enggsajjad/scooter/logs/20210728 Testing A9G GPS/20210728 Testing AT 5.jpeg

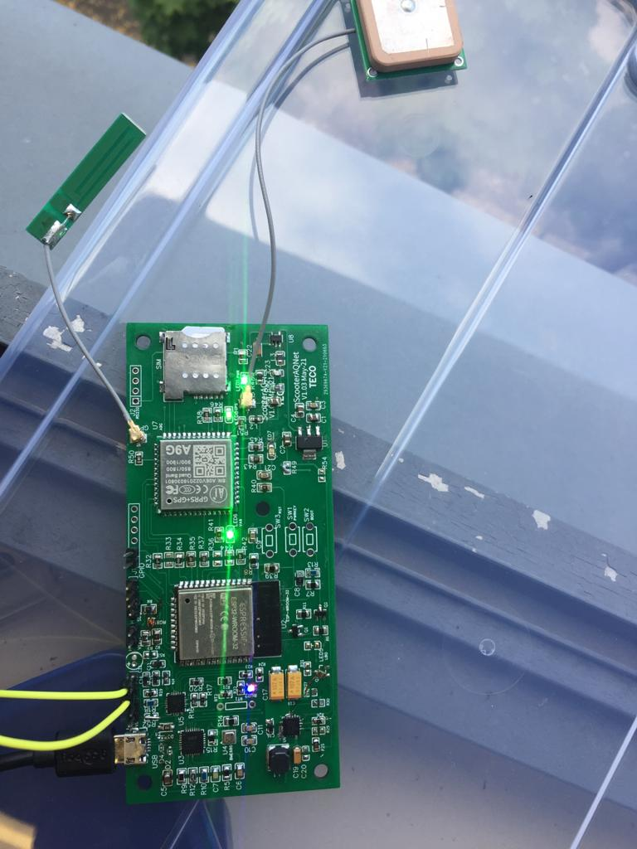
logs/20210728 Testing A9G GPS/20210728 Testing AT 5.jpeg
