enggsajjad/scooter/esp32scooter/docs/latex/esp32scooter_8ino.tex

\hypertarget{esp32scooter_8ino}{}\section{H\+:/github/scooter/esp32scooter/esp32scooter.ino File Reference}
\label{esp32scooter_8ino}\index{H:/github/scooter/esp32scooter/esp32scooter.ino@{H:/github/scooter/esp32scooter/esp32scooter.ino}}

This is the Arduino .ino file.  

{\ttfamily \#include \char`\"{}main.\+h\char`\"{}}\newline
\subsection*{Functions}
\begin{DoxyCompactItemize}
\item 
void \mbox{\hyperlink{esp32scooter_8ino_a4fc01d736fe50cf5b977f755b675f11d}{setup}} ()
\begin{DoxyCompactList}\small\item\em initialization of peripherals attached to E\+S\+P32 board \end{DoxyCompactList}\item 
void \mbox{\hyperlink{esp32scooter_8ino_afe461d27b9c48d5921c00d521181f12f}{loop}} ()
\begin{DoxyCompactList}\small\item\em reading the Microphone with timer function \end{DoxyCompactList}\end{DoxyCompactItemize}

\subsection{Detailed Description}
This is the Arduino .ino file. 

This is the E\+S\+P32 implementation file, which implement the overall flow of the project by calling different files/functions. It implements the state-\/machine like flow as described in the \href{StatemachineFlow.pdf}{\texttt{ {\bfseries{flowchart}}}}.

\begin{DoxyDate}{Date}
07.\+09.\+2020 
\end{DoxyDate}

\subsection{Function Documentation}
\mbox{\Hypertarget{esp32scooter_8ino_afe461d27b9c48d5921c00d521181f12f}\label{esp32scooter_8ino_afe461d27b9c48d5921c00d521181f12f}} 
\index{esp32scooter.ino@{esp32scooter.ino}!loop@{loop}}
\index{loop@{loop}!esp32scooter.ino@{esp32scooter.ino}}
\subsubsection{\texorpdfstring{loop()}{loop()}}
{\footnotesize\ttfamily void loop (\begin{DoxyParamCaption}{ }\end{DoxyParamCaption})}

reading the Microphone with timer function 

\begin{DoxyReturn}{Returns}
void 
\end{DoxyReturn}

Definition at line 59 of file esp32scooter.\+ino.

\mbox{\Hypertarget{esp32scooter_8ino_a4fc01d736fe50cf5b977f755b675f11d}\label{esp32scooter_8ino_a4fc01d736fe50cf5b977f755b675f11d}} 
\index{esp32scooter.ino@{esp32scooter.ino}!setup@{setup}}
\index{setup@{setup}!esp32scooter.ino@{esp32scooter.ino}}
\subsubsection{\texorpdfstring{setup()}{setup()}}
{\footnotesize\ttfamily void setup (\begin{DoxyParamCaption}{ }\end{DoxyParamCaption})}

initialization of peripherals attached to E\+S\+P32 board 

\begin{DoxyReturn}{Returns}
void 
\end{DoxyReturn}

Definition at line 23 of file esp32scooter.\+ino.
