enggsajjad/scooter/esp32scooter/docs/images/header.tex

% Latex header for doxygen 1.8.15
\let\mypdfximage\pdfximage\def\pdfximage{\immediate\mypdfximage}\documentclass[twoside]{book}

% Packages required by doxygen
\usepackage{fixltx2e}
\usepackage{calc}
\usepackage{doxygen}
\usepackage{graphicx}
\usepackage[utf8]{inputenc}
\usepackage{makeidx}
\usepackage{multicol}
\usepackage{multirow}
\PassOptionsToPackage{warn}{textcomp}
\usepackage{textcomp}
\usepackage[nointegrals]{wasysym}
\usepackage[table]{xcolor}
\usepackage{ifpdf,ifxetex}

% Font selection
\usepackage[T1]{fontenc}
\usepackage[scaled=.90]{helvet}
\usepackage{courier}
\usepackage{amssymb}
\usepackage{sectsty}
\renewcommand{\familydefault}{\sfdefault}
\allsectionsfont{%
  \fontseries{bc}\selectfont%
  \color{darkgray}%
}
\renewcommand{\DoxyLabelFont}{%
  \fontseries{bc}\selectfont%
  \color{darkgray}%
}
\newcommand{\+}{\discretionary{\mbox{\scriptsize$\hookleftarrow$}}{}{}}

% Arguments of doxygenemoji:
% 1) ':<text>:' form of the emoji, already "LaTeX"-escaped
% 2) file with the name of the emoji without the .png extension
% in case image exist use this otherwise use the ':<text>:' form
\newcommand{\doxygenemoji}[2]{%
  \IfFileExists{./#2.png}{\raisebox{-0.1em}{}}{#1}%
}
% Page & text layout
\usepackage{geometry}
\geometry{%
  a4paper,%
  top=2.5cm,%
  bottom=2.5cm,%
  left=2.5cm,%
  right=2.5cm%
}
\tolerance=750
\hfuzz=15pt
\hbadness=750
\setlength{\emergencystretch}{15pt}
\setlength{\parindent}{0cm}
\newcommand{\doxynormalparskip}{\setlength{\parskip}{3ex plus 2ex minus 2ex}}
\newcommand{\doxytocparskip}{\setlength{\parskip}{1ex plus 0ex minus 0ex}}
\doxynormalparskip
\makeatletter
\renewcommand{\paragraph}{%
  \@startsection{paragraph}{4}{0ex}{-1.0ex}{1.0ex}{%
    \normalfont\normalsize\bfseries\SS@parafont%
  }%
}
\renewcommand{\subparagraph}{%
  \@startsection{subparagraph}{5}{0ex}{-1.0ex}{1.0ex}{%
    \normalfont\normalsize\bfseries\SS@subparafont%
  }%
}
\makeatother

% Headers & footers
\usepackage{fancyhdr}
\pagestyle{fancyplain}
\fancyhead[LE]{\fancyplain{}{\bfseries\thepage}}
\fancyhead[CE]{\fancyplain{}{}}
\fancyhead[RE]{\fancyplain{}{\bfseries\leftmark}}
\fancyhead[LO]{\fancyplain{}{\bfseries\rightmark}}
\fancyhead[CO]{\fancyplain{}{}}
\fancyhead[RO]{\fancyplain{}{\bfseries\thepage}}
\fancyfoot[LE]{\fancyplain{}{}}
\fancyfoot[CE]{\fancyplain{}{}}
\fancyfoot[RE]{\fancyplain{}{\bfseries\scriptsize Generated by Doxygen }}
\fancyfoot[LO]{\fancyplain{}{\bfseries\scriptsize Generated by Doxygen }}
\fancyfoot[CO]{\fancyplain{}{}}
\fancyfoot[RO]{\fancyplain{}{}}
\renewcommand{\footrulewidth}{0.4pt}
\renewcommand{\chaptermark}[1]{%
  \markboth{#1}{}%
}
\renewcommand{\sectionmark}[1]{%
  \markright{\thesection\ #1}%
}

% Indices & bibliography
\usepackage{natbib}
\usepackage[titles]{tocloft}
\setcounter{tocdepth}{3}
\setcounter{secnumdepth}{5}
\makeindex

\usepackage{newunicodechar}
  \newunicodechar{⁻}{${}^{-}$}% Superscript minus
  \newunicodechar{²}{${}^{2}$}% Superscript two
  \newunicodechar{³}{${}^{3}$}% Superscript three

% Hyperlinks (required, but should be loaded last)
\ifpdf
  \usepackage[pdftex,pagebackref=true]{hyperref}
\else
  \ifxetex
    \usepackage[pagebackref=true]{hyperref}
  \else
    \usepackage[ps2pdf,pagebackref=true]{hyperref}
  \fi
\fi

\hypersetup{%
  colorlinks=true,%
  linkcolor=blue,%
  citecolor=blue,%
  unicode%
}

% Custom commands
\newcommand{\clearemptydoublepage}{%
  \newpage{\pagestyle{empty}\cleardoublepage}%
}

\usepackage{caption}
\captionsetup{labelsep=space,justification=centering,font={bf},singlelinecheck=off,skip=4pt,position=top}

\usepackage{etoc}
\etocsettocstyle{\doxytocparskip}{\doxynormalparskip}
\renewcommand{\numberline}[1]{#1~}
%===== C O N T E N T S =====

\begin{document}

% Titlepage & ToC
\hypersetup{pageanchor=false,
             bookmarksnumbered=true,
             pdfencoding=unicode
            }
\pagenumbering{alph}
\begin{titlepage}
\vspace*{2cm}
\begin{center}%
{\Huge $projectname}\\
\vspace*{3cm}
{\Large $projectbrief}\\
\vspace*{1cm}
\centering
\vfill
 % also works with logo.pdf
\vspace*{2cm}
\vfill
{\large Generated by Doxygen}\\
\vspace*{1cm}
{\Large $date}\\
\end{center}
\end{titlepage}
\clearemptydoublepage
\pagenumbering{roman}
\tableofcontents
\clearemptydoublepage
\pagenumbering{arabic}
\hypersetup{pageanchor=true}

%--- Begin generated contents ---
