enggsajjad/scooter/esp32scooter/docs/Flowcharts/StatemachineFlow.pdf

# SMARTAQNET ESP32_STATIONARY STATEMACHINE

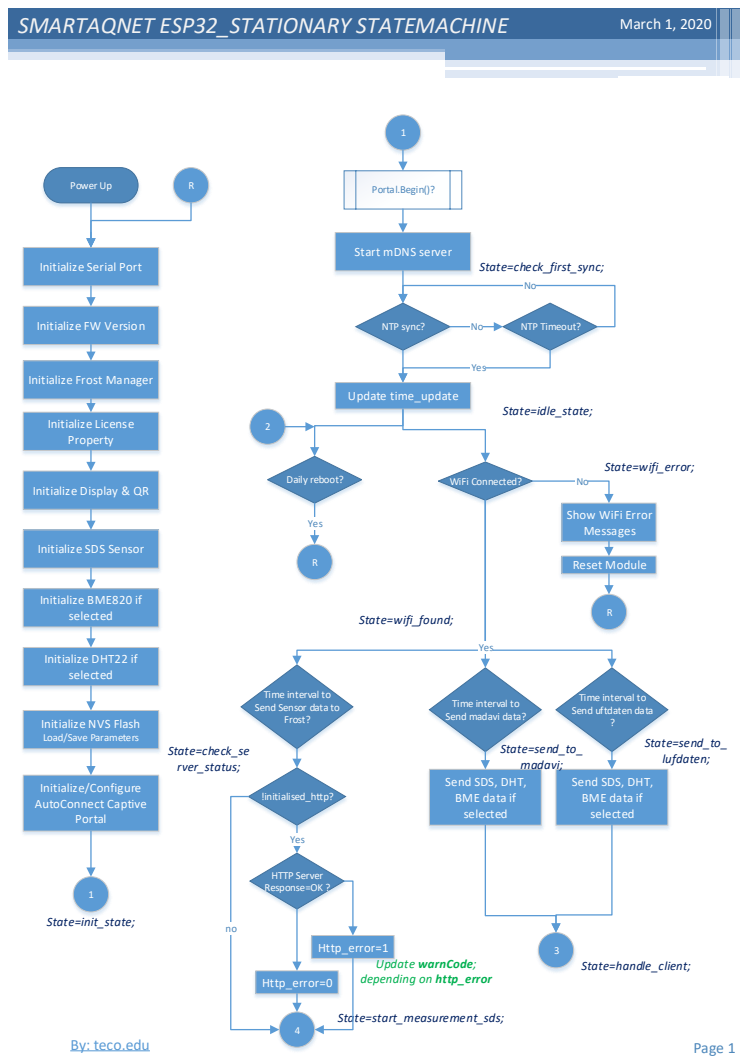
[picture p3: page 1]
March 1, 2020; Power Up; Initialize License Property; Initialize BME820 if selected; Initialize DHT22 if selected; Initialize/Configure AutoConnect Captive Portal; Portal.Begin()?; State=init_state;; NTP sync?; NTP Timeout?; Daily reboot?; WiFi Connected?; Reset Module; Update time_update; Yes; State=check_first_sync;; State=idle_state;; State=wifi_error;; State=wifi_found;; State=start_measurement_sds;; State=send_to_ madavi;; State=send_to_ lufdaten;; State=handle_client;; !initialised_http?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

Start mDNS server

Initialize Serial Port

Initialize FW Version

Initialize Frost Manager

Initialize Display & QR

Show WiFi Error
Messages

Initialize SDS Sensor

Time interval to
Send Sensor data to
Frost?

Send madavi data?

Send uftdaten data

Initialize NVS Flash
Load/Save Parameters

Send SDS, DHT,
BME data if
selected

By: teco.edu

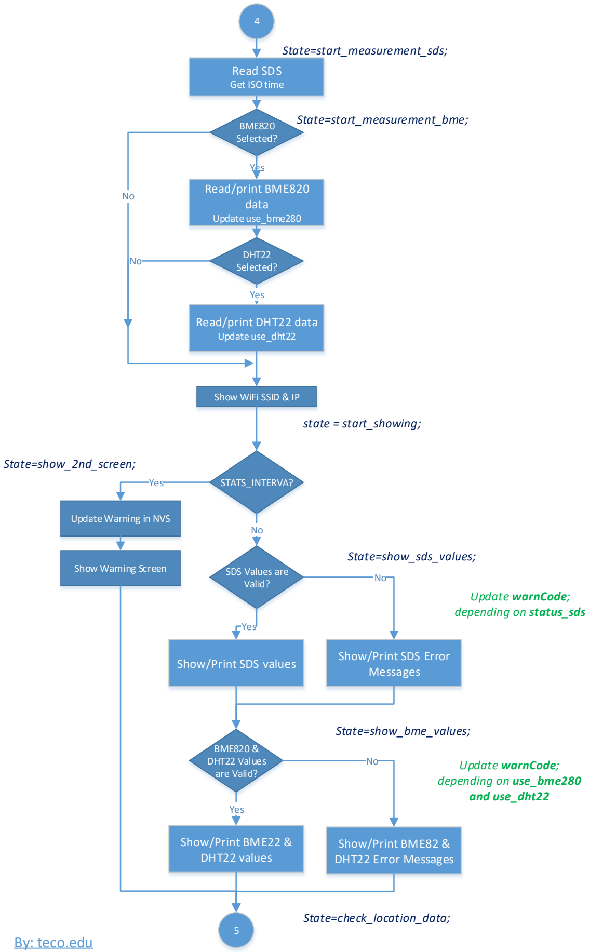
[picture p4: figure]
Read SDS Get ISO time; BME820 Selected?; Yes; State=start_measurement_sds;; State=start_measurement_bme;; Read/print BME820 data Update use_bme280; DHT22 Selected?; Read/print DHT22 data Update use_dht22; SDS Values are Valid?; Show/Print SDS values; Show/Print SDS Error; Messages; BME820 & DHT22 Values are Valid?; Show/Print BME22 & DHT22 values; Show/Print BME82 & DHT22 Error Messages; State=show_sds_values;; State=show_bme_values;; State=check_location_data;; Update warnCode; depending on status_sds; Update warnCode; depending on use_bme280 and use_dht22; Show WiFi SSID & IP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
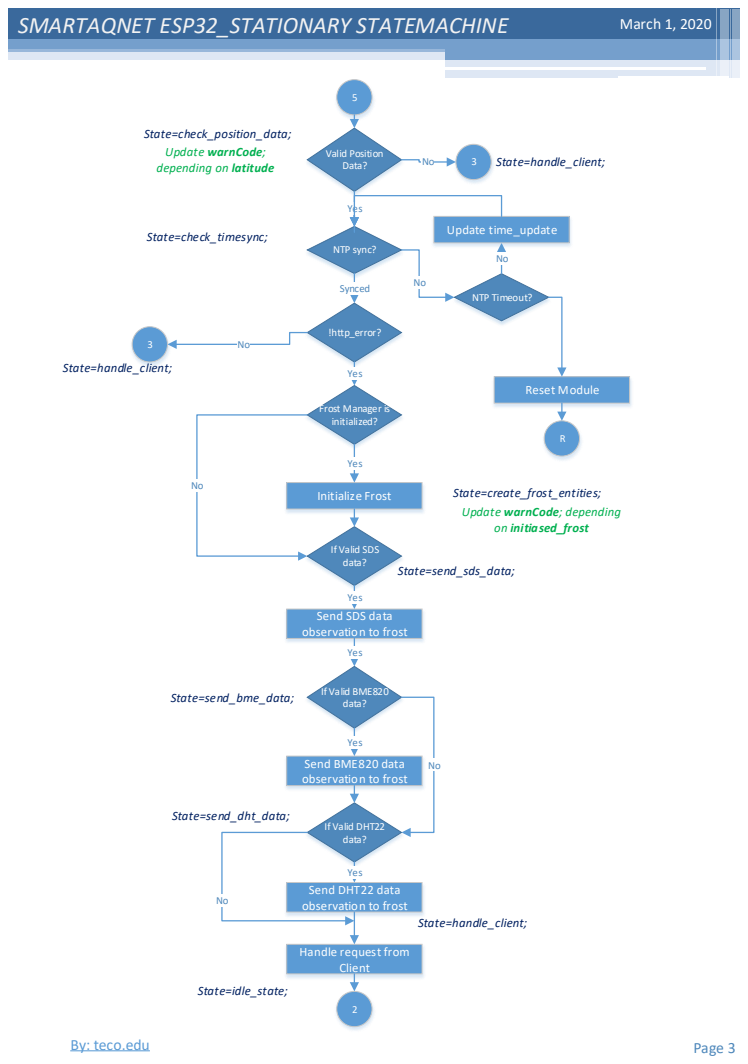
[picture p5: page 3]
Valid Position Data?; State=handle_client;; NTP sync?; NTP Timeout?; State=check_timesync;; Yes; Reset Module; Update time_update; Initialize Frost; State=create_frost_entities;; If Valid BME820 data?; If Valid DHT22 data?; State=send_sds_data;; State=send_bme_data;; State=send_dht_data;; Client; State=idle_state;; !http_error?; Synced

State=check_position_data;
Update warnCode;
depending on latitude

Frost Manager is
initialized?

Update warnCode; depending
on initiased_frost

If Valid SDS
data?

Yes
Send SDS data
observation to frost

Send BME820 data

Send DHT22 data

Handle request from

Handling the AutoConnect Portal and WebServer

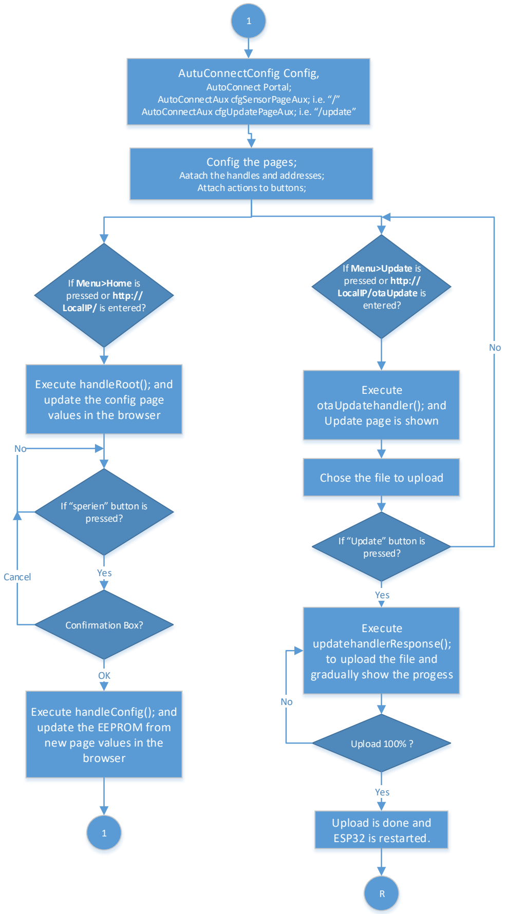
[picture p6: figure]
AutuConnectConfig Config, AutoConnect Portal; AutoConnectAux cfgSensorPageAux; i.e. “/” AutoConnectAux cfgUpdatePageAux; i.e. “/update”; If Menu>Home is pressed or http:// LocalIP/ is entered?; If Menu>Update is pressed or http:// LocalIP/otaUpdate is entered?; Config the pages; Aatach the handles and addresses; Attach actions to buttons;; Execute handleRoot(); and update the config page values in the browser; If “sperien” button is pressed?; Confirmation Box?; Execute handleConfig(); and update the EEPROM from new page values in the browser; Execute otaUpdatehandler()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

# Portal.Begin() Sub-Process

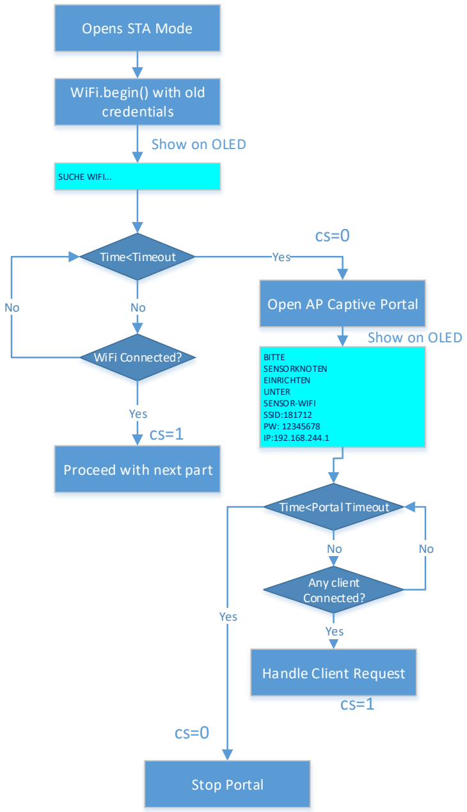
[picture p7: figure]
Opens STA Mode; Time<Timeout; WiFi.begin() with old credentials; WiFi Connected?; Proceed with next part; Yes; Time<Portal Timeout; Open AP Captive Portal; SUCHE WIFI...; BITTE SENSORKNOTEN EINRICHTEN UNTER SENSOR-WIFI SSID:181712 PW: 12345678 IP:192.168.244.1; Any client Connected?; Handle Client Request; Stop Portal; Show on OLED
