enggsajjad/scooter/esp32scooter/docs/images/tecoLogo.pdf

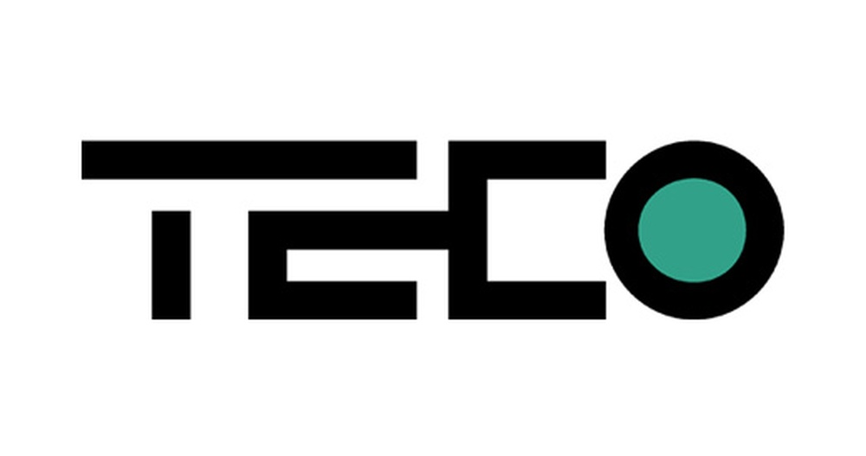
[picture p8: page 1]
