enggsajjad/scooter/esp32scooter/docs/latex/apmode.pdf

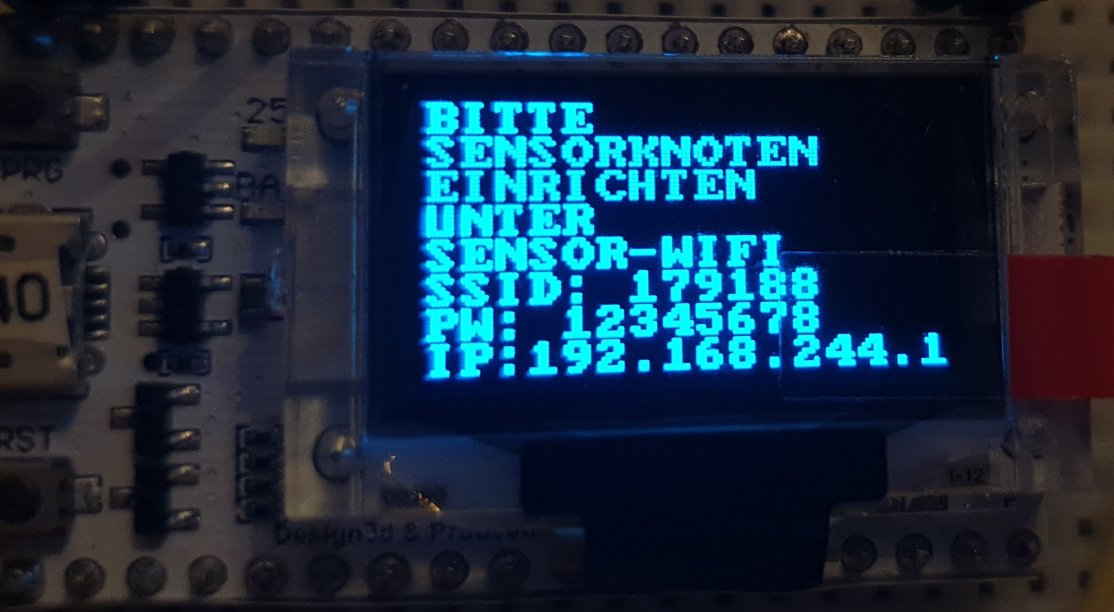
[picture p9: page 1]
