enggsajjad/scooter/esp32scooter/docs/latex/board.pdf

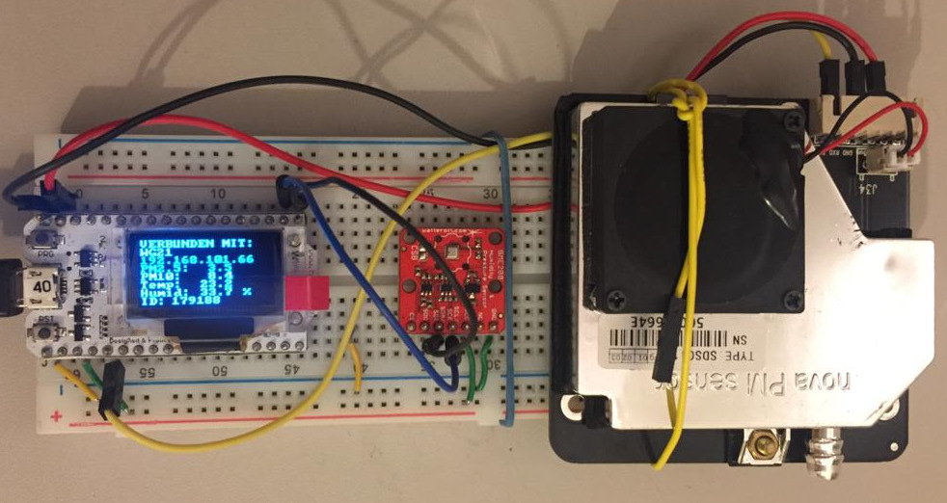
[picture p10: page 1]
