enggsajjad/scooter/esp32scooter/docs/latex/configr.pdf

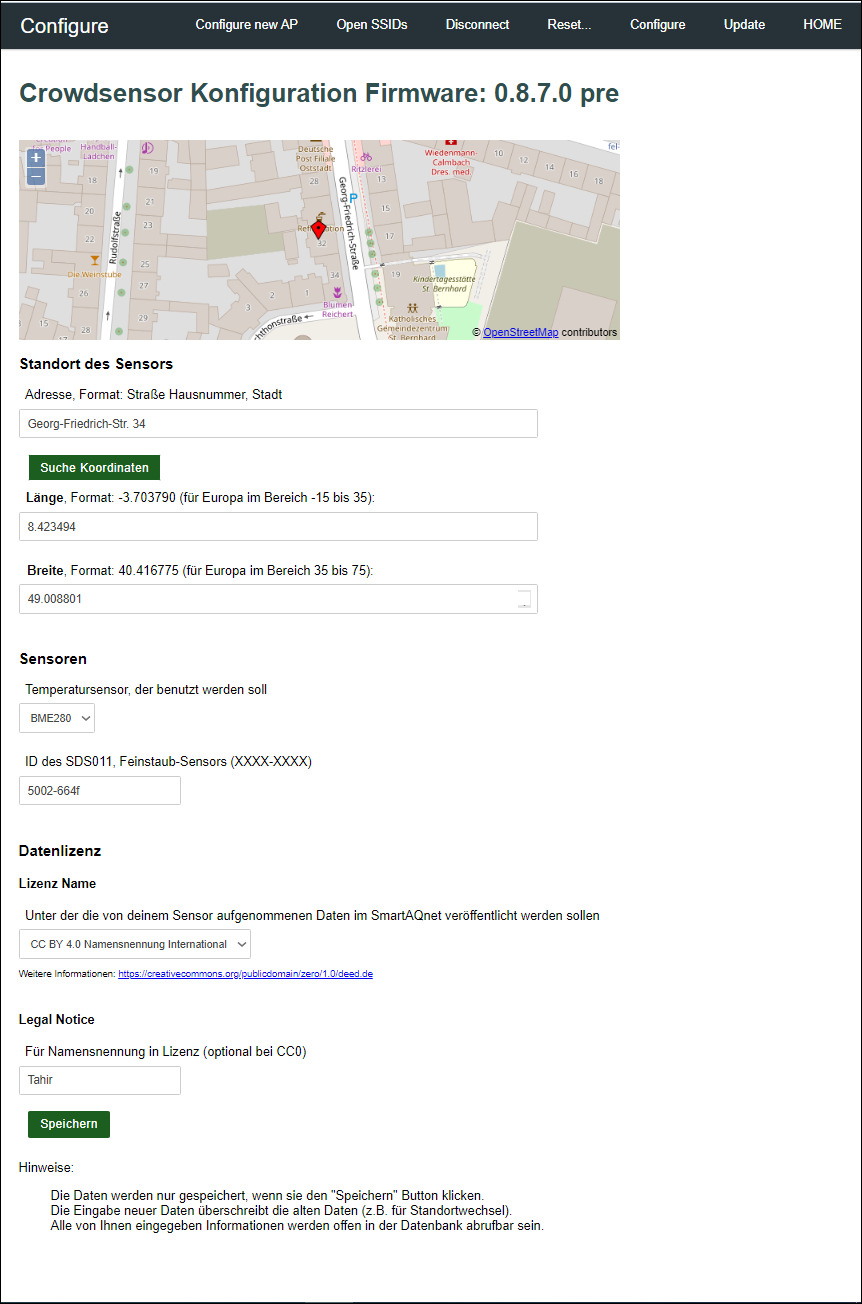
[picture p11: page 1]
