enggsajjad/scooter/esp32scooter/docs/latex/reboot.pdf

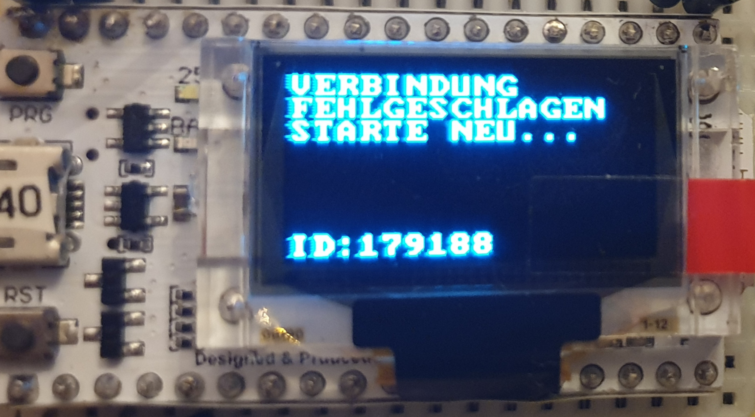
[picture p12: page 1]
