enggsajjad/scooter/esp32scooter/docs/latex/screen1.pdf

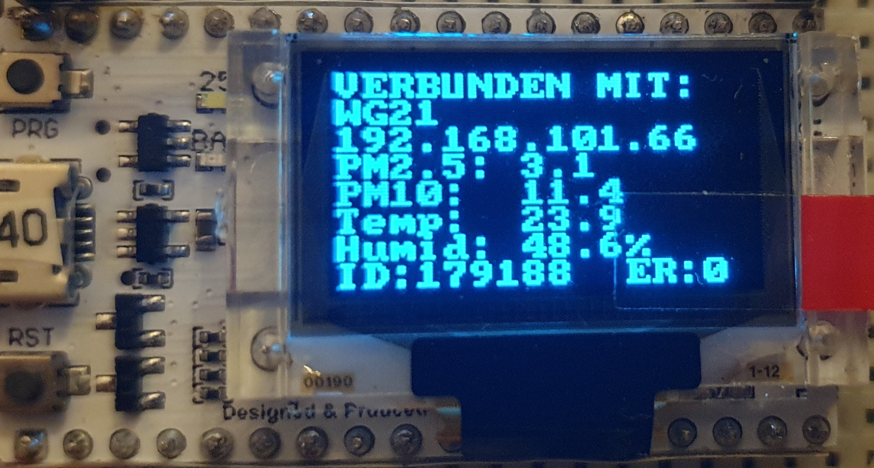
[picture p13: page 1]
