enggsajjad/scooter/esp32scooter/docs/latex/screen1error.pdf

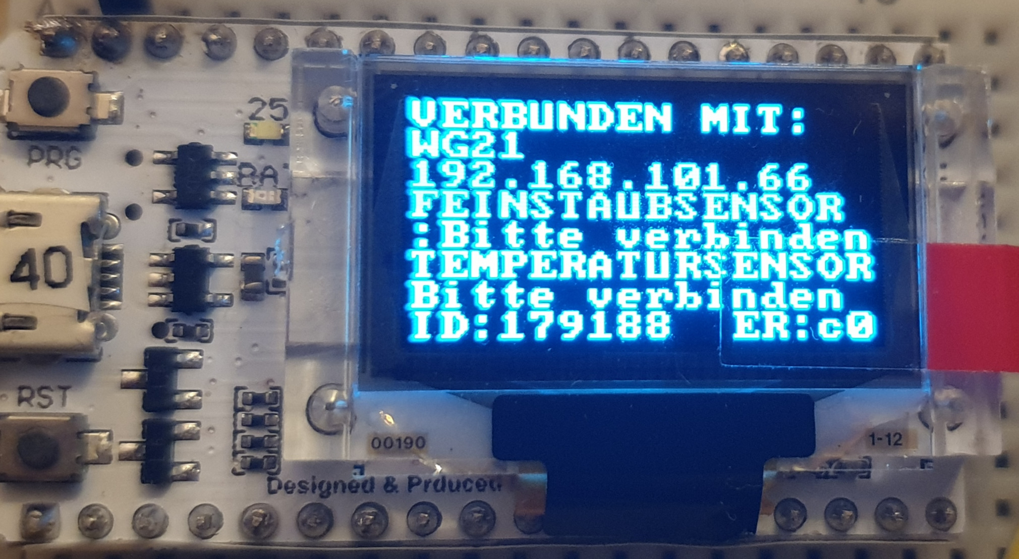
[picture p14: page 1]
