enggsajjad/scooter/esp32scooter/docs/latex/screen2.pdf

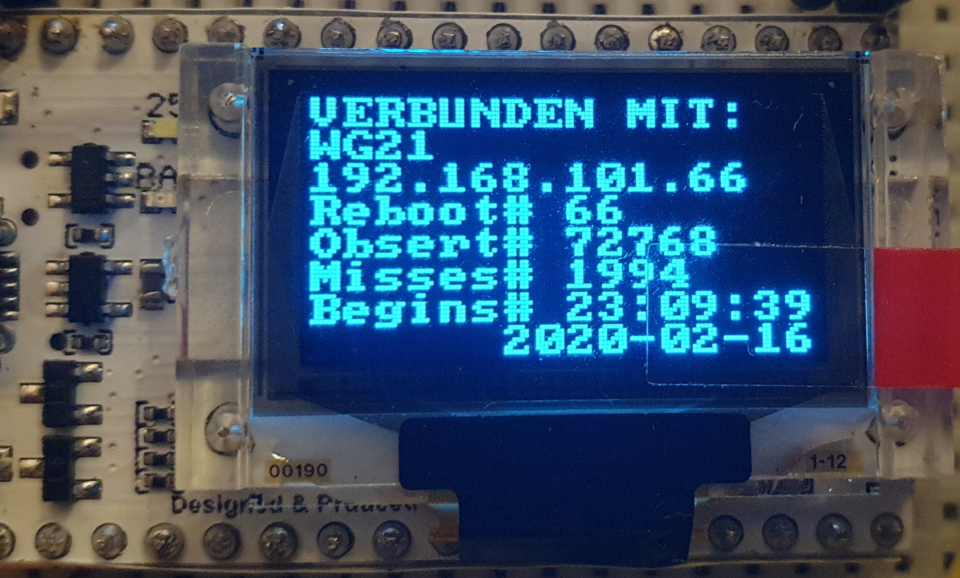
[picture p15: page 1]
