enggsajjad/scooter/esp32scooter/docs/latex/searchwifi.pdf

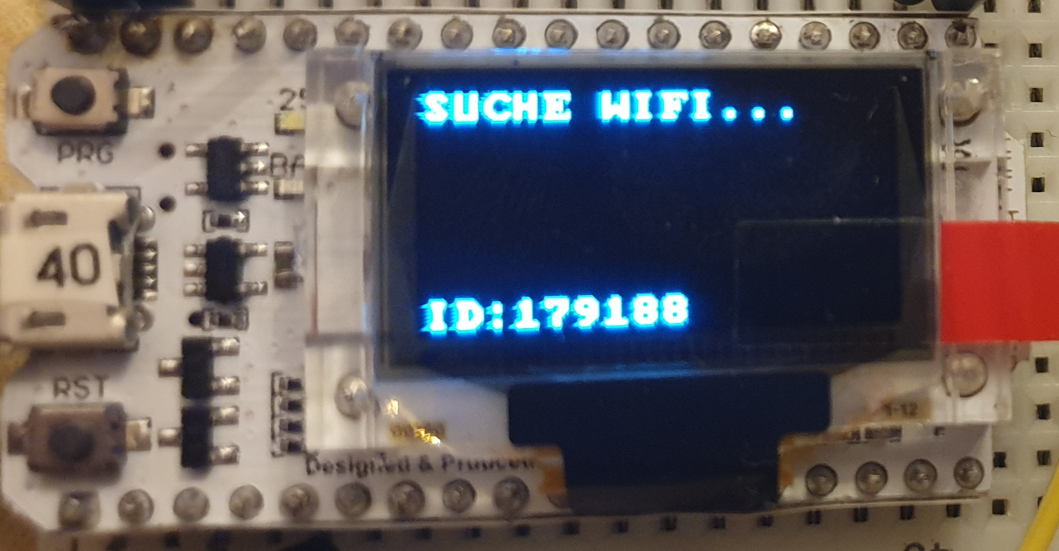
[picture p16: page 1]
