enggsajjad/scooter/esp32scooter/docs/latex/syncwait.pdf

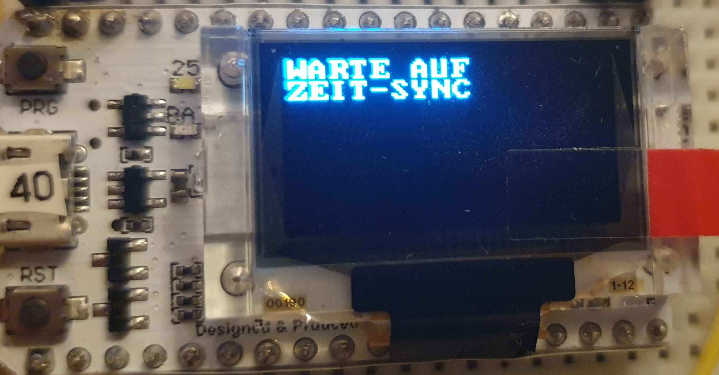
[picture p17: page 1]
