enggsajjad/scooter/logs/1.jpg

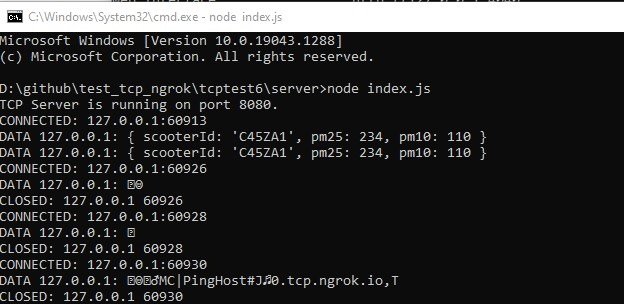
logs/1.jpg
