enggsajjad/scooter/logs/2.jpg

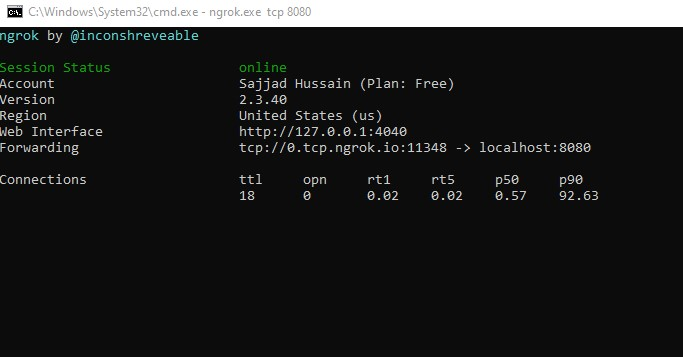
logs/2.jpg
