enggsajjad/scooter/logs/3.jpg

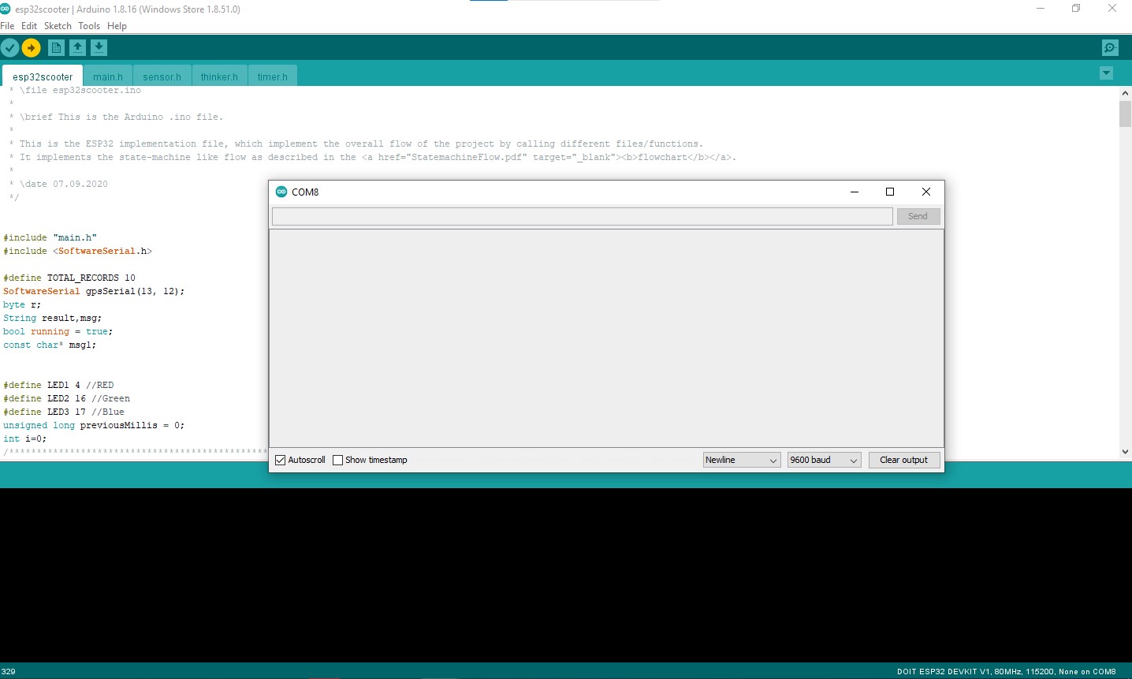
logs/3.jpg
