enggsajjad/scooter/logs/4.jpg

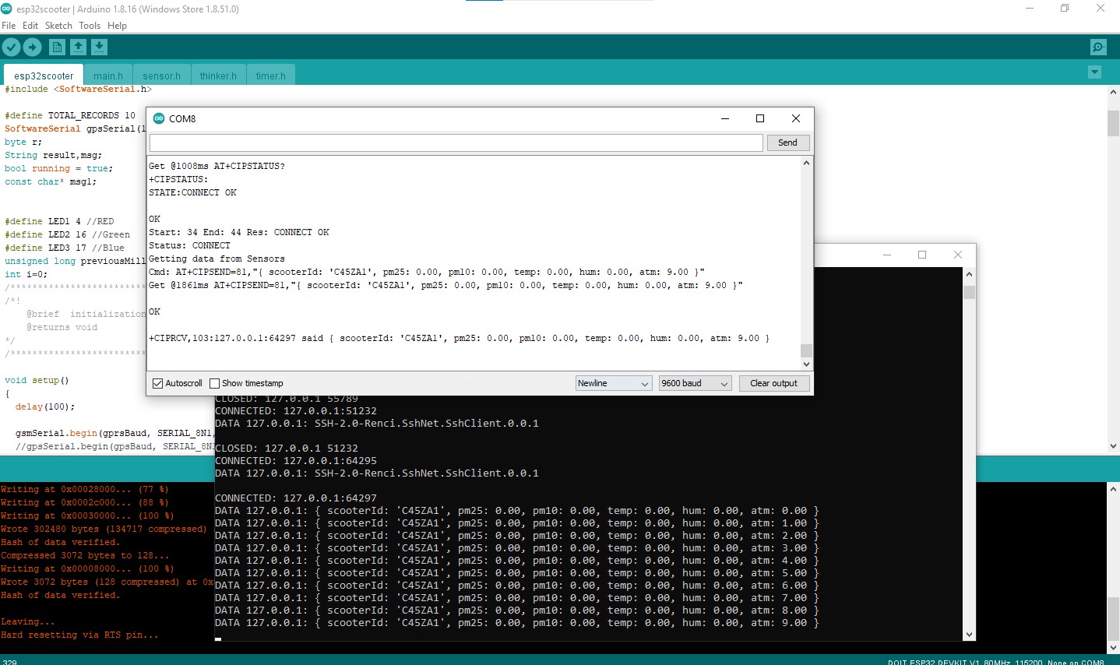
logs/4.jpg
