enggsajjad/scooter/logs/5.jpg

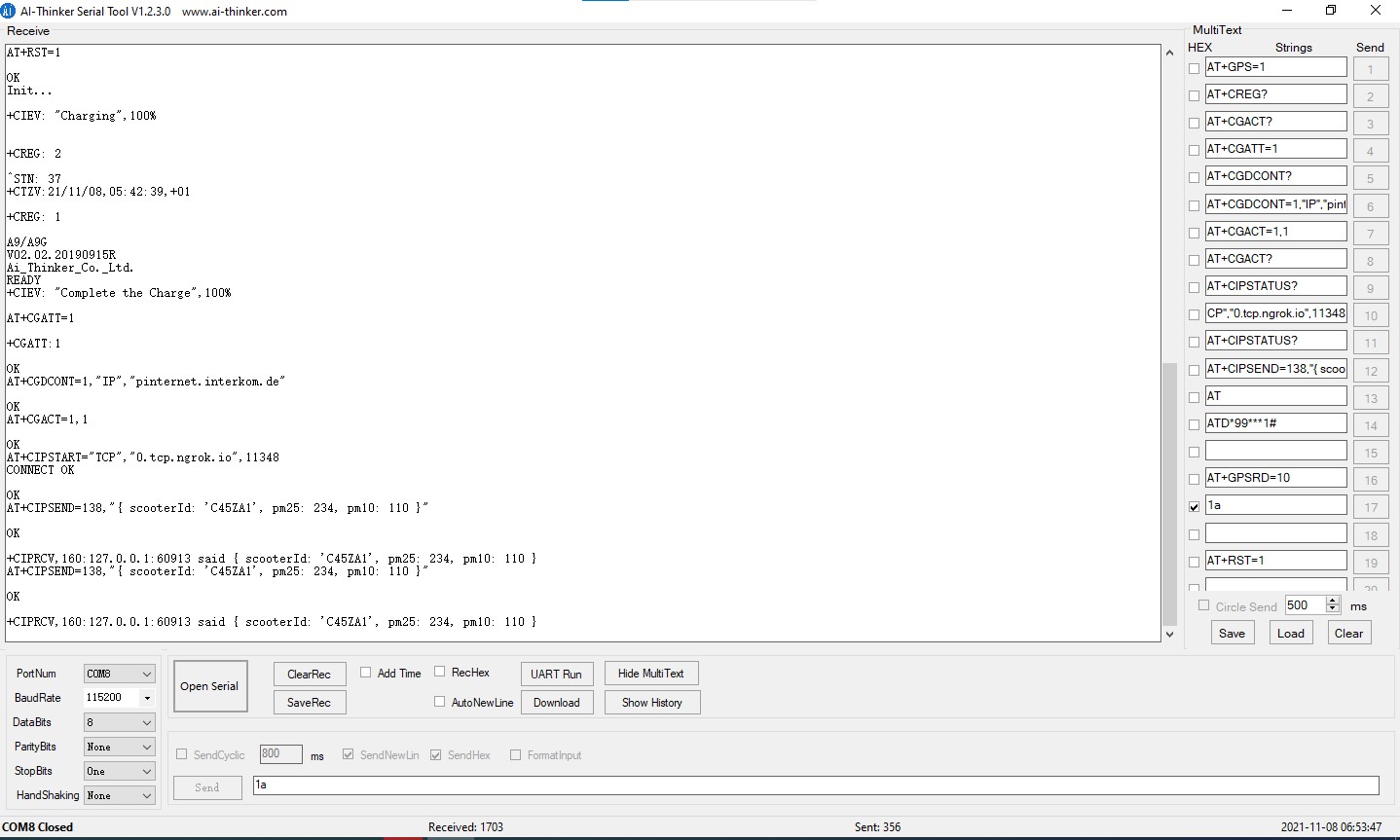
logs/5.jpg
