enggsajjad/scooter/logs/6.jpg

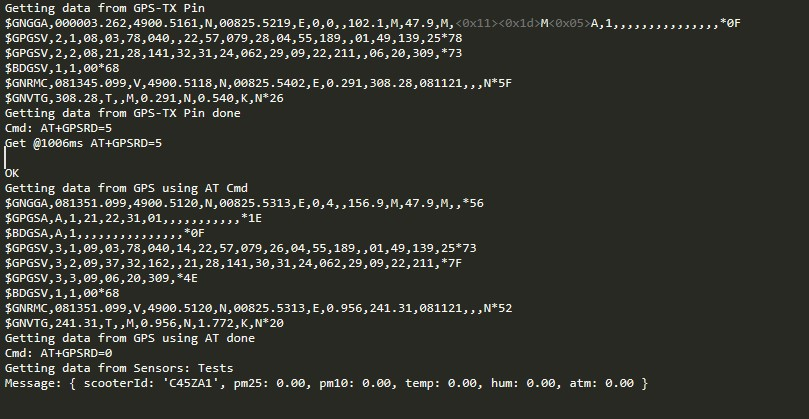
logs/6.jpg
