enggsajjad/scooter/logs/20220210 walking around map.jpg

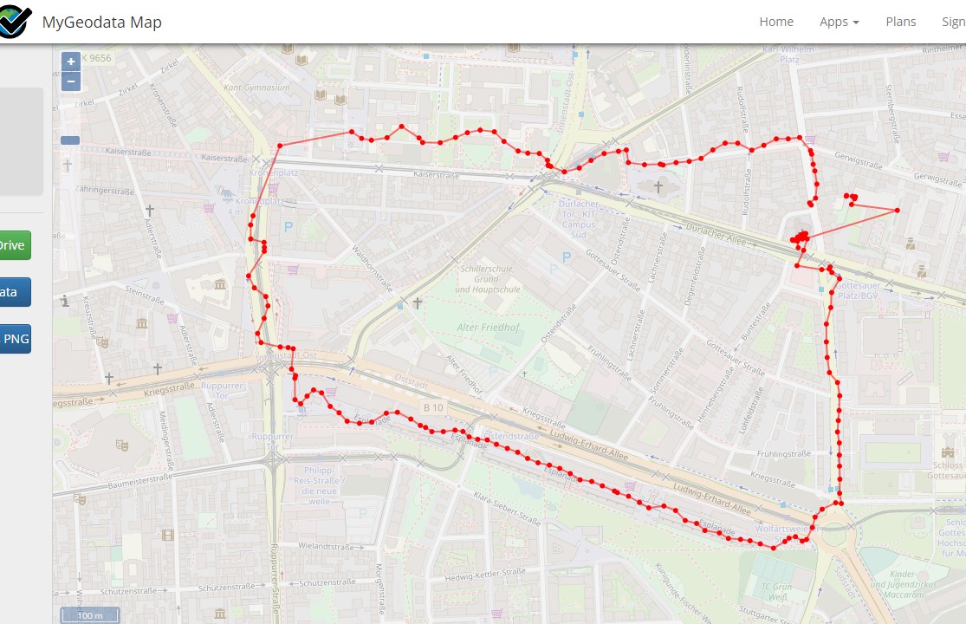
logs/20220210 walking around map.jpg
