enggsajjad/scooter/logs/20220210 walking around temperature.jpg

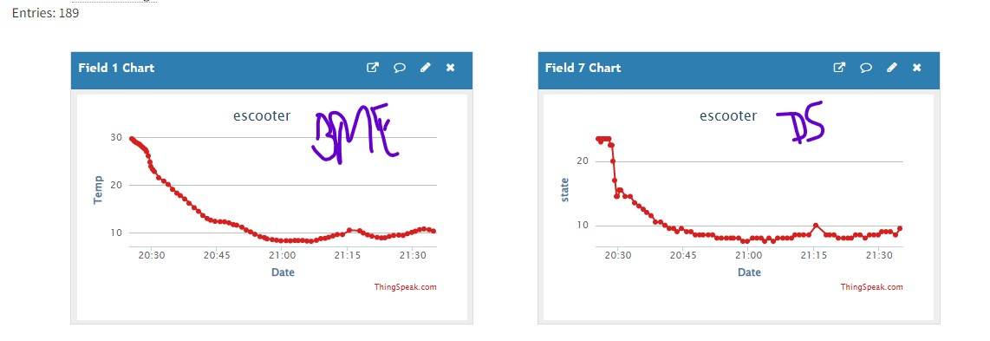
logs/20220210 walking around temperature.jpg
