enggsajjad/scooter/logs/20220211 Cycle till lidl then back home, then walk to Kronenplatz, dinner 1916 2126, walk to home map.jpg

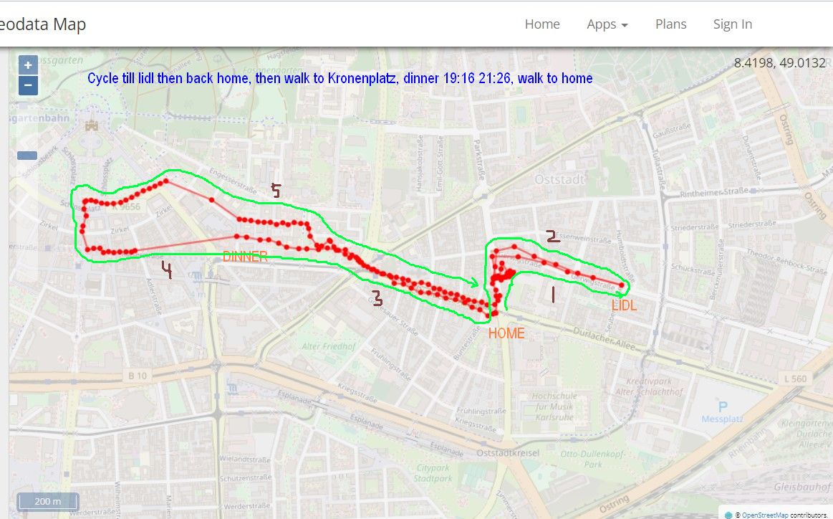
logs/20220211 Cycle till lidl then back home, then walk to Kronenplatz, dinner 1916 2126, walk to home map.jpg
