enggsajjad/scooter/logs/20220213 Walking 2034-2045 gap on the same location at multiple times temperature.jpg

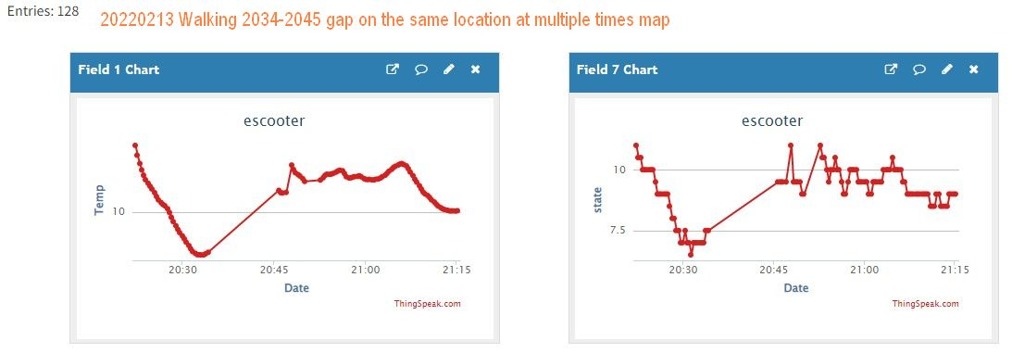
logs/20220213 Walking 2034-2045 gap on the same location at multiple times temperature.jpg
