enggsajjad/scooter/logs/20220214 Walking with cover maps.jpg

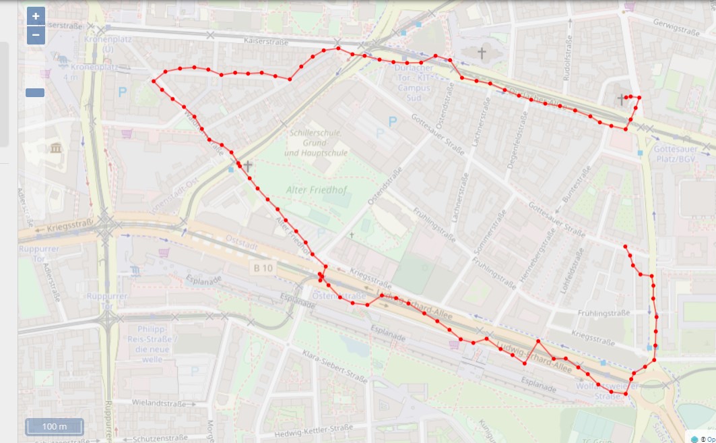
logs/20220214 Walking with cover maps.jpg
