enggsajjad/scooter/logs/20220214 Walking with cover temperature.jpg

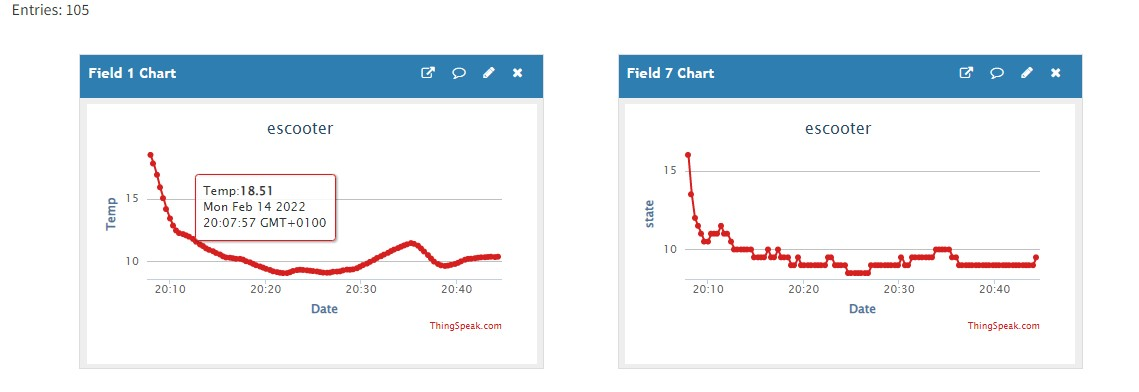
logs/20220214 Walking with cover temperature.jpg
