enggsajjad/scooter/logs/20220216 Walking dinner Walking map.jpg

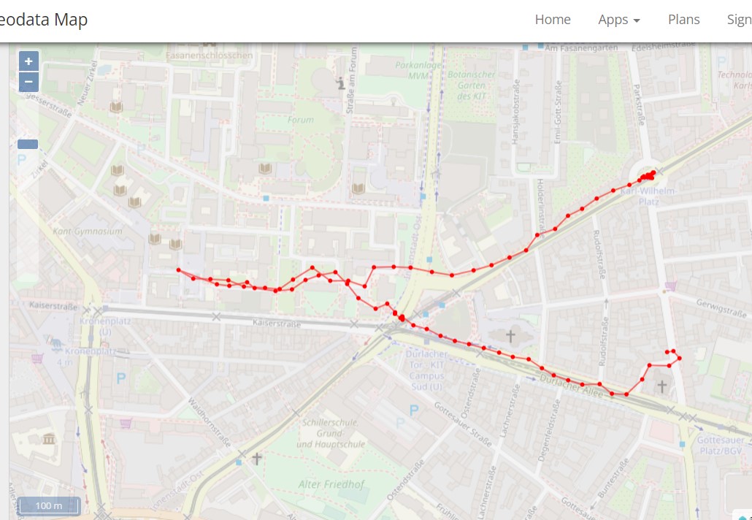
logs/20220216 Walking dinner Walking map.jpg
