enggsajjad/scooter/logs/20220216 Walking dinner Walking Temperature.jpg

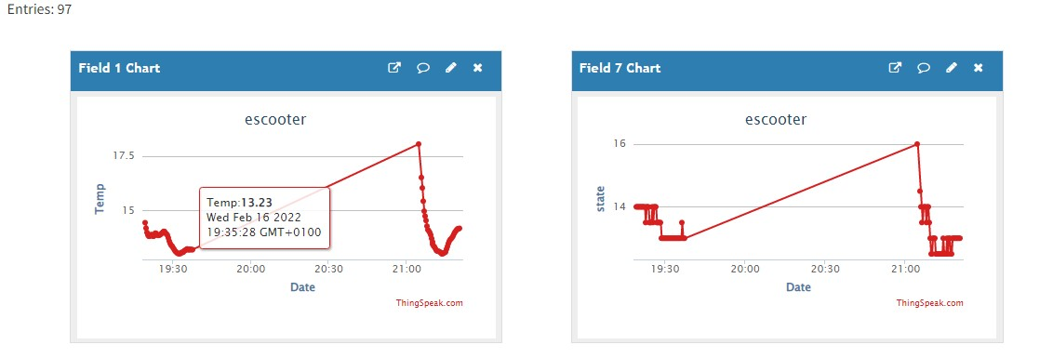
logs/20220216 Walking dinner Walking Temperature.jpg
