enggsajjad/scooter/logs/20220218 walking maps.jpg

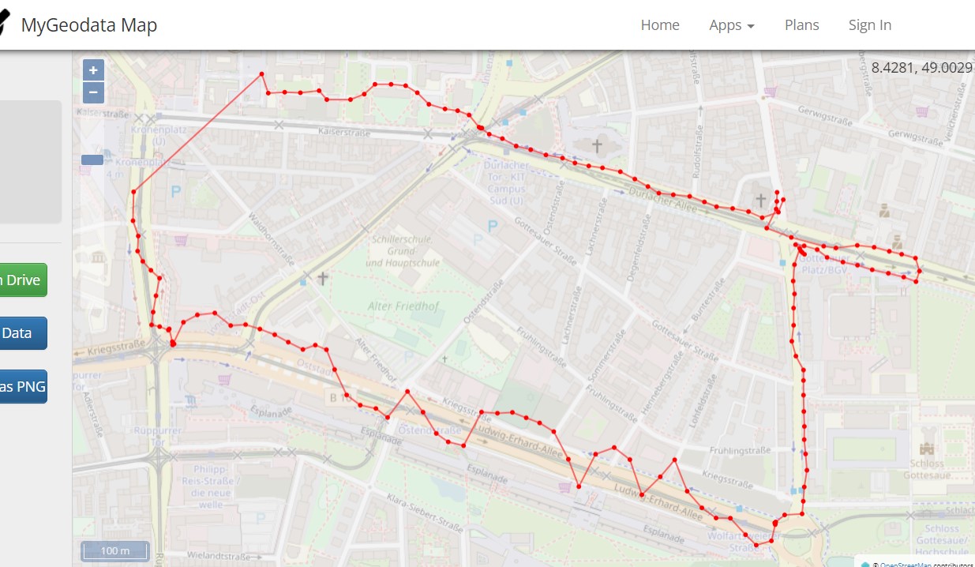
logs/20220218 walking maps.jpg
