enggsajjad/scooter/logs/20220218 walking temperature.jpg

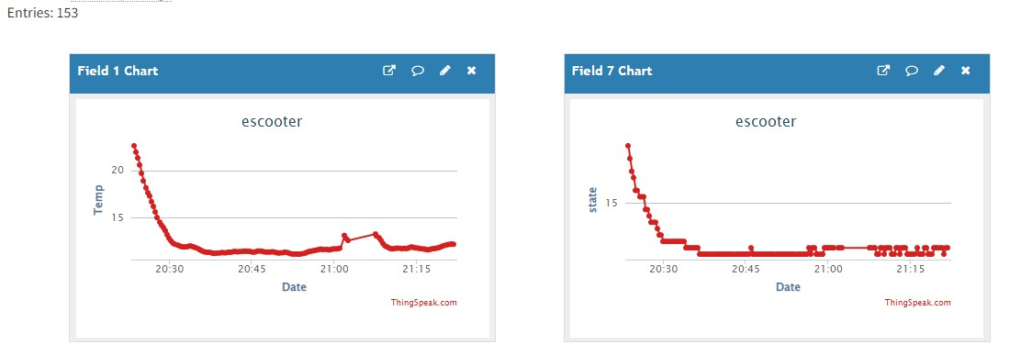
logs/20220218 walking temperature.jpg
