enggsajjad/scooter/logs/20220220 Walking from TECO to dinner to TECO to home temperature.jpg

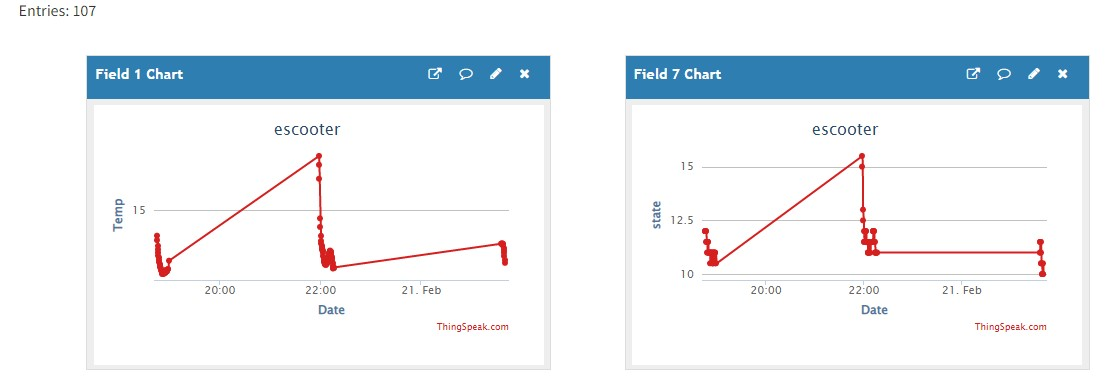
logs/20220220 Walking from TECO to dinner to TECO to home temperature.jpg
