enggsajjad/scooter/logs/20220221 Walking maps.jpg

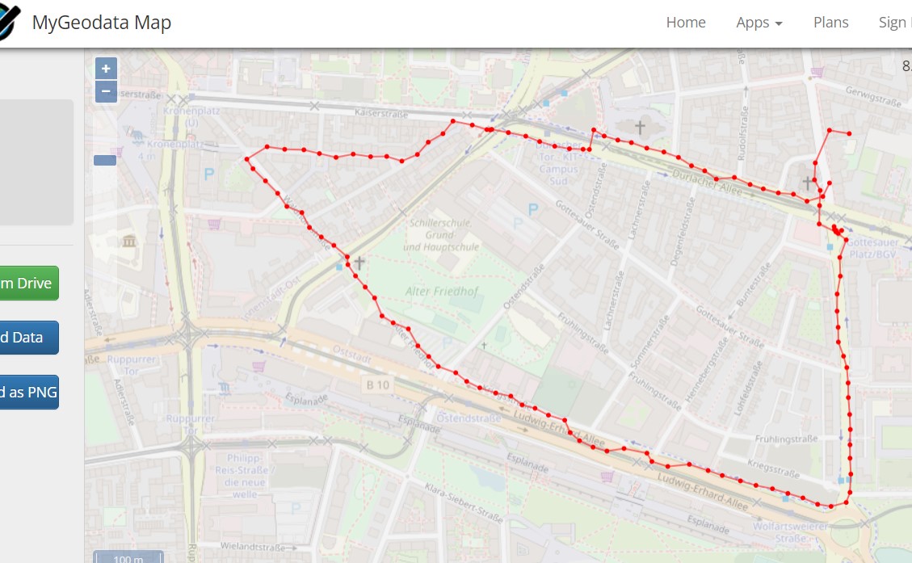
logs/20220221 Walking maps.jpg
