enggsajjad/scooter/logs/20220221 Walking temperatures.jpg

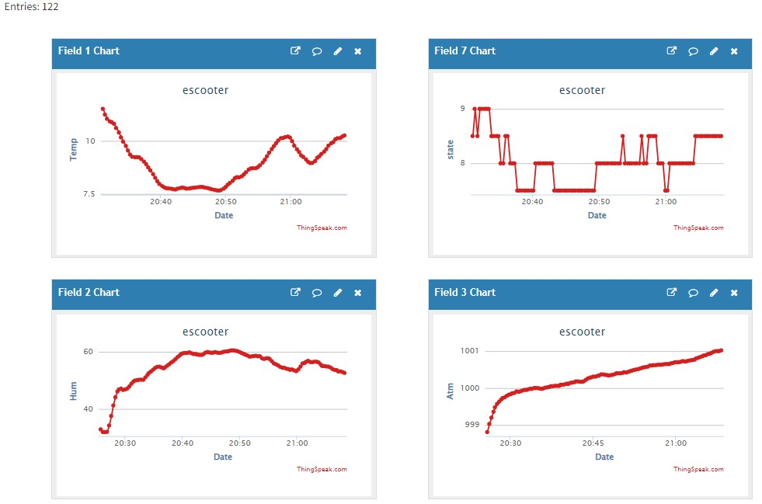
logs/20220221 Walking temperatures.jpg
