enggsajjad/scooter/logs/20220222 Walking maps.jpg

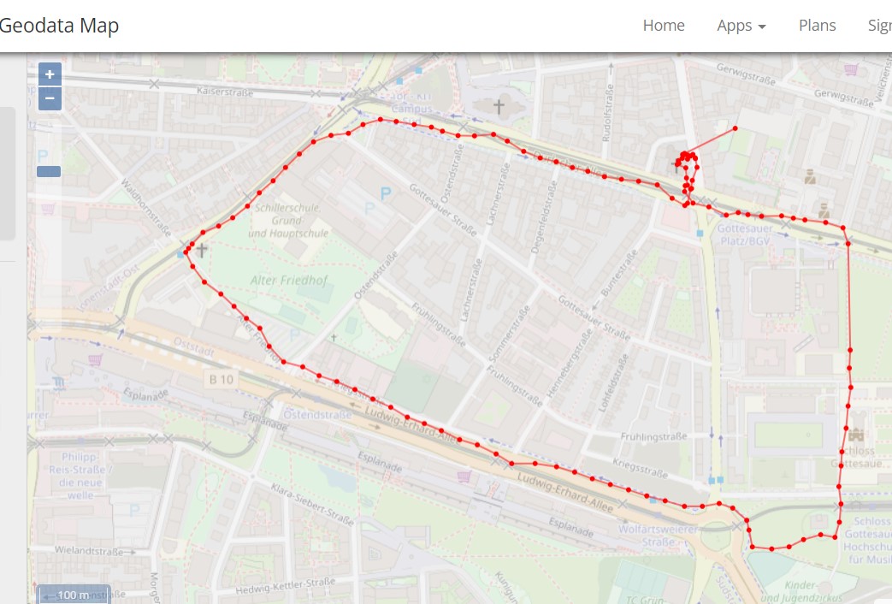
logs/20220222 Walking maps.jpg
