enggsajjad/scooter/logs/20220222 Walking temperature.jpg

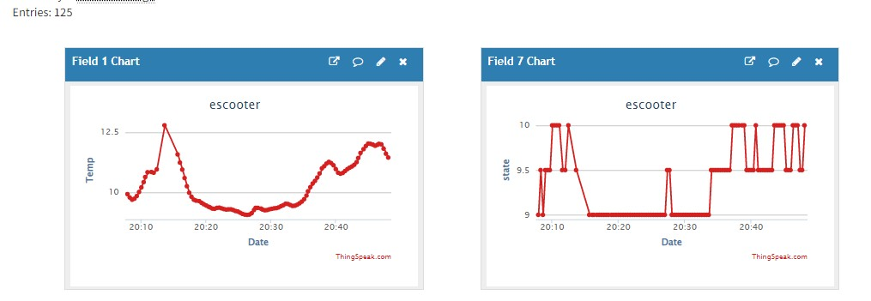
logs/20220222 Walking temperature.jpg
