enggsajjad/scooter/logs/20220223 Walking maps.jpg

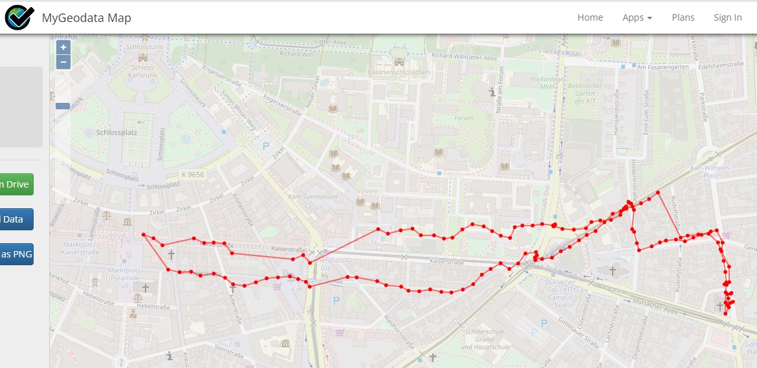
logs/20220223 Walking maps.jpg
