enggsajjad/scooter/logs/20220223 Walking Temperature.jpg

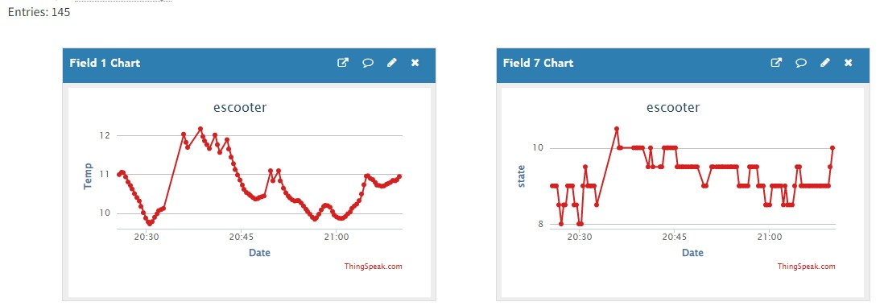
logs/20220223 Walking Temperature.jpg
