enggsajjad/scooter/logs/20220226 Walking-Train Case maps.jpg

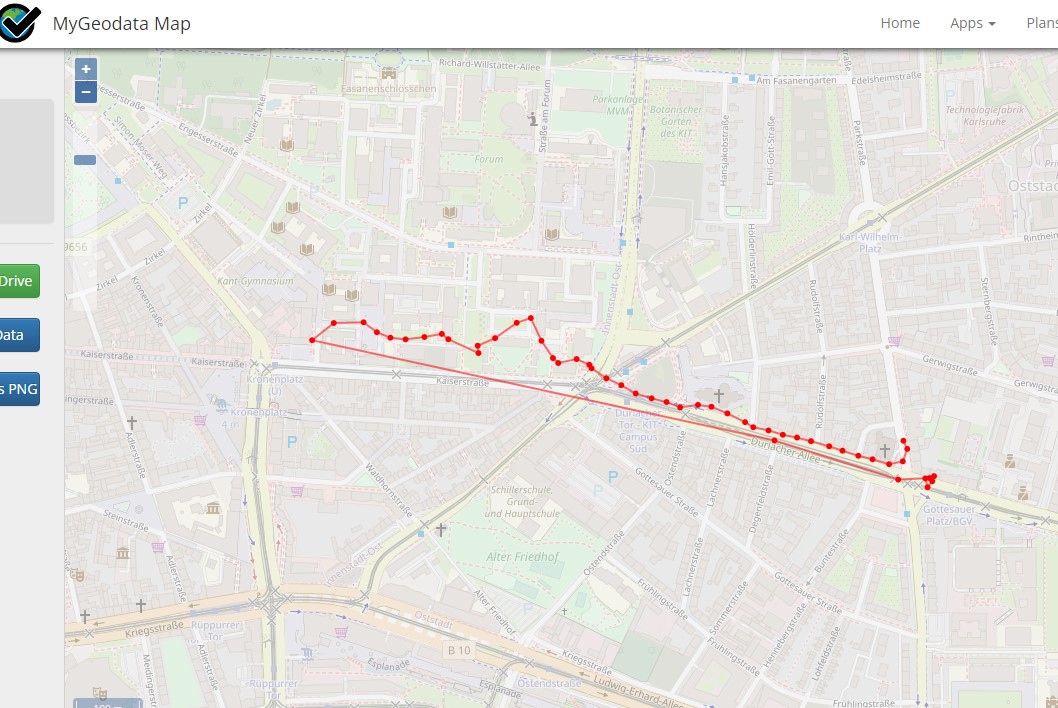
logs/20220226 Walking-Train Case maps.jpg
