enggsajjad/scooter/logs/20220226 Walking-Train Case Temperature.jpg

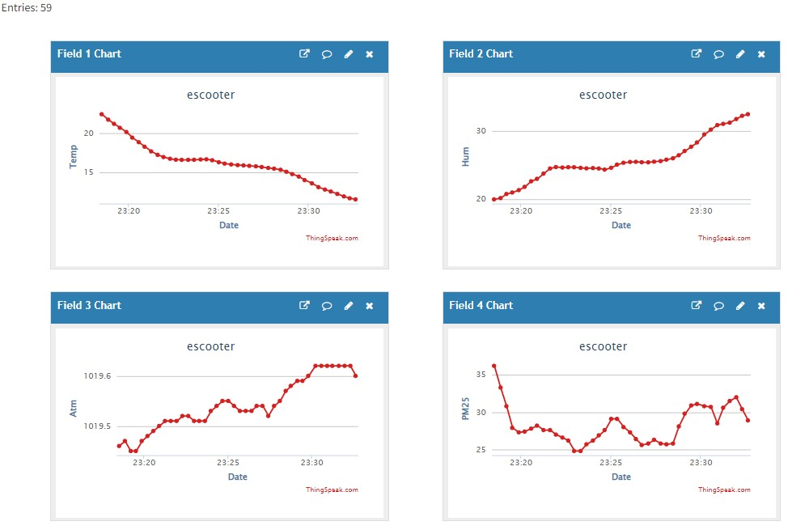
logs/20220226 Walking-Train Case Temperature.jpg
