enggsajjad/scooter/logs/20220227 Walking Case maps.jpg

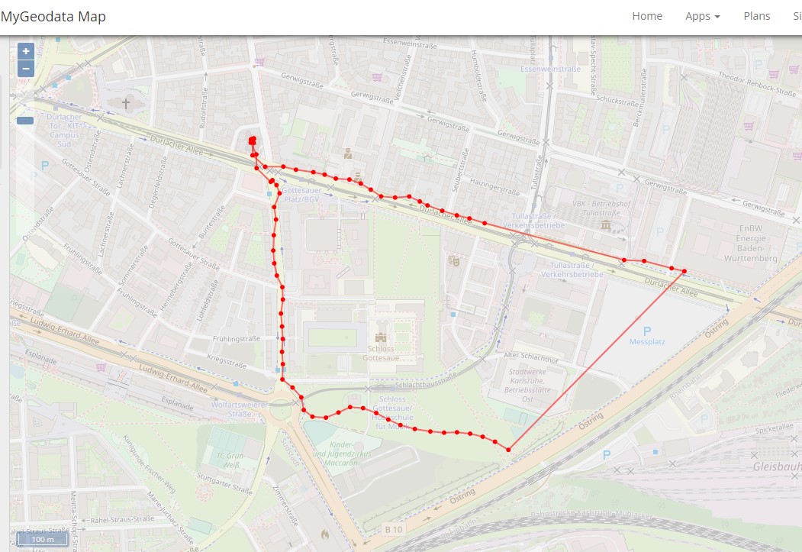
logs/20220227 Walking Case maps.jpg
