enggsajjad/scooter/logs/20220227 Walking Case Temperature.jpg

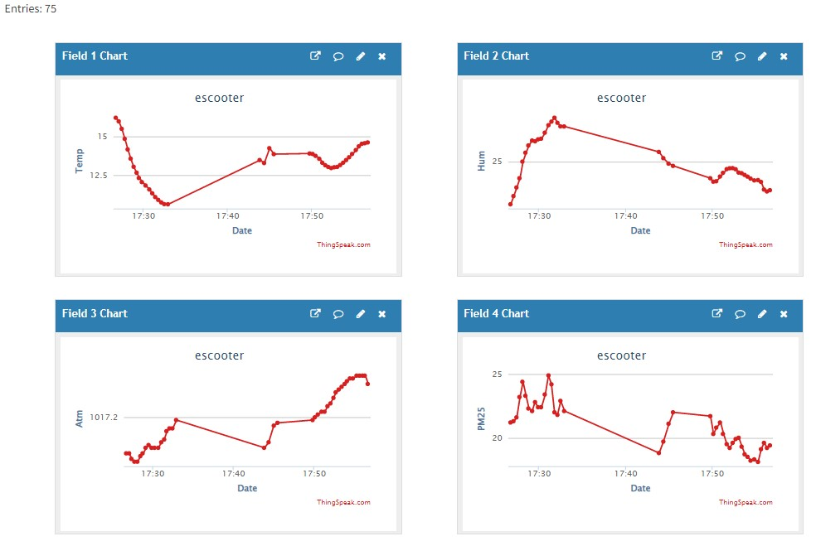
logs/20220227 Walking Case Temperature.jpg
