enggsajjad/scooter/logs/20220228 Walking Cycle Case Maps Combined.jpg

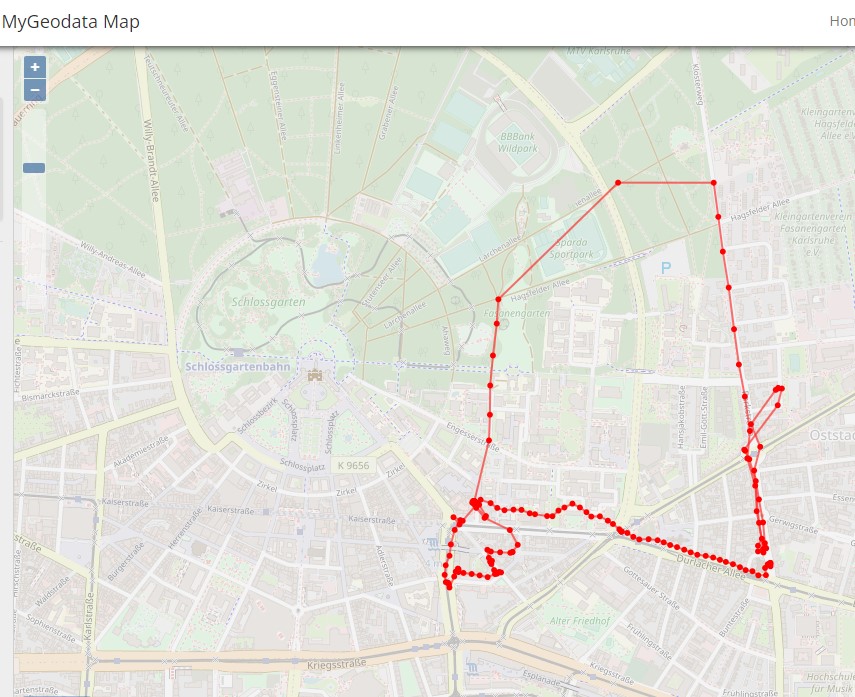
logs/20220228 Walking Cycle Case Maps Combined.jpg
