enggsajjad/scooter/logs/20220228 Walking Cycle Case Maps Part2.jpg

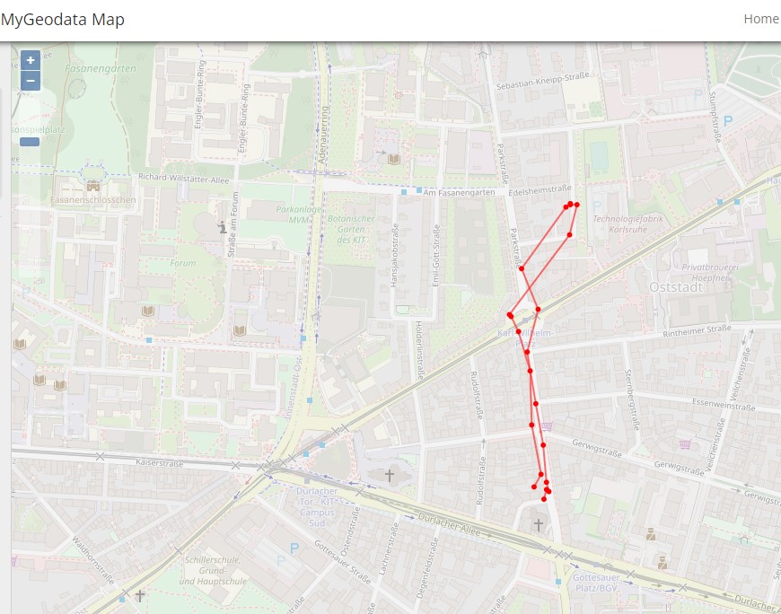
logs/20220228 Walking Cycle Case Maps Part2.jpg
