enggsajjad/scooter/logs/20220228 Walking Cycle Case Temperature Combined.jpg

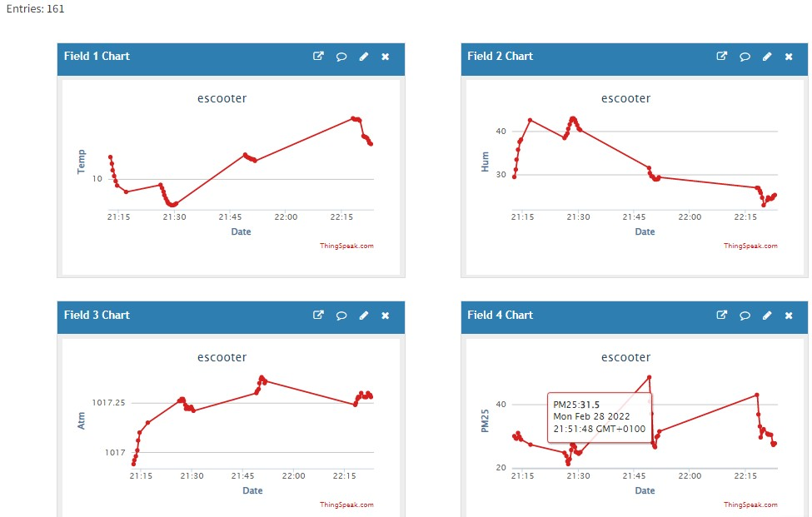
logs/20220228 Walking Cycle Case Temperature Combined.jpg
