enggsajjad/scooter/logs/20220228 Walking Cycle Case Temperature Part2.jpg

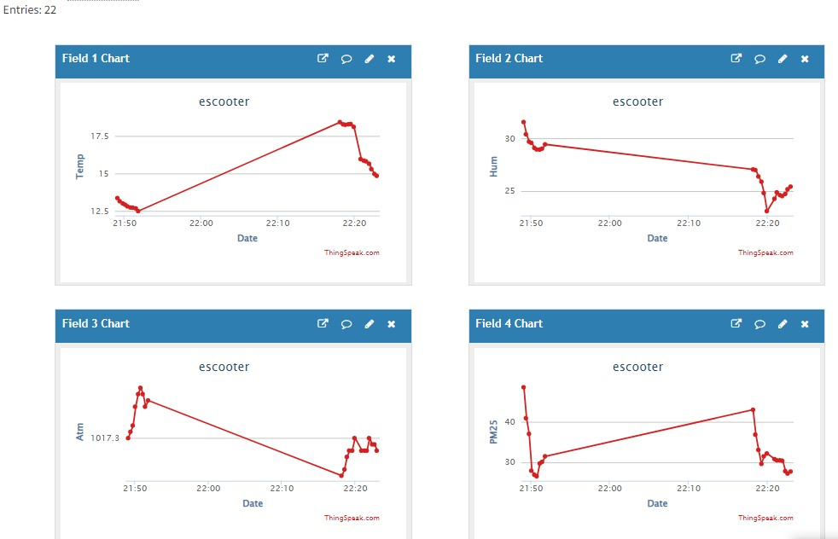
logs/20220228 Walking Cycle Case Temperature Part2.jpg
