enggsajjad/scooter/logs/20220301 Walking Cycle Case Map.jpg

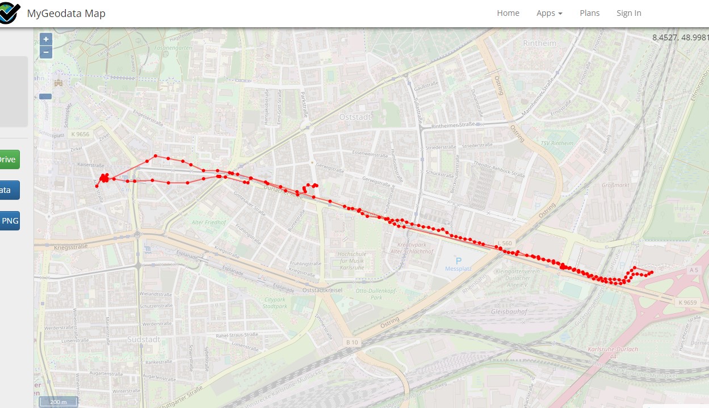
logs/20220301 Walking Cycle Case Map.jpg
