enggsajjad/scooter/logs/20220301 Walking Cycle Case Temperature.jpg

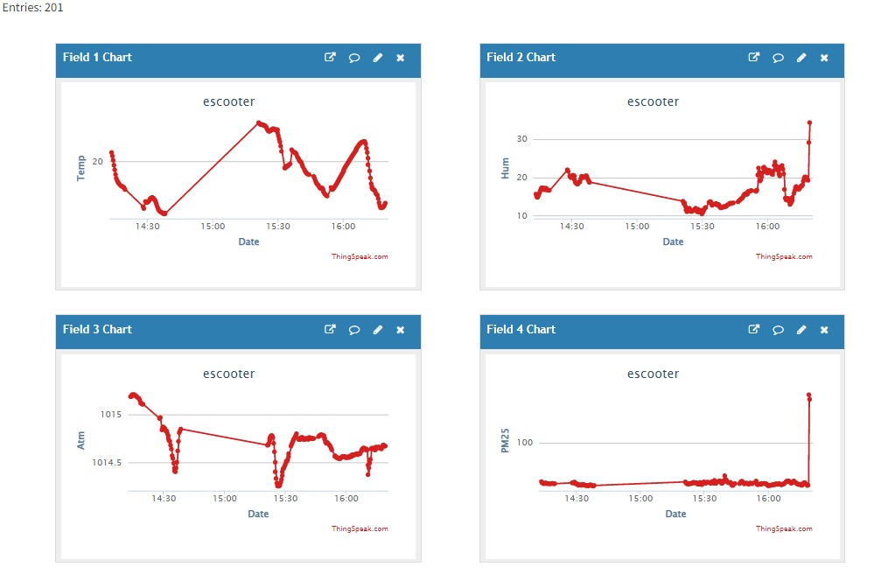
logs/20220301 Walking Cycle Case Temperature.jpg
