enggsajjad/scooter/logs/20220302 Train Walk Case Maps.jpg

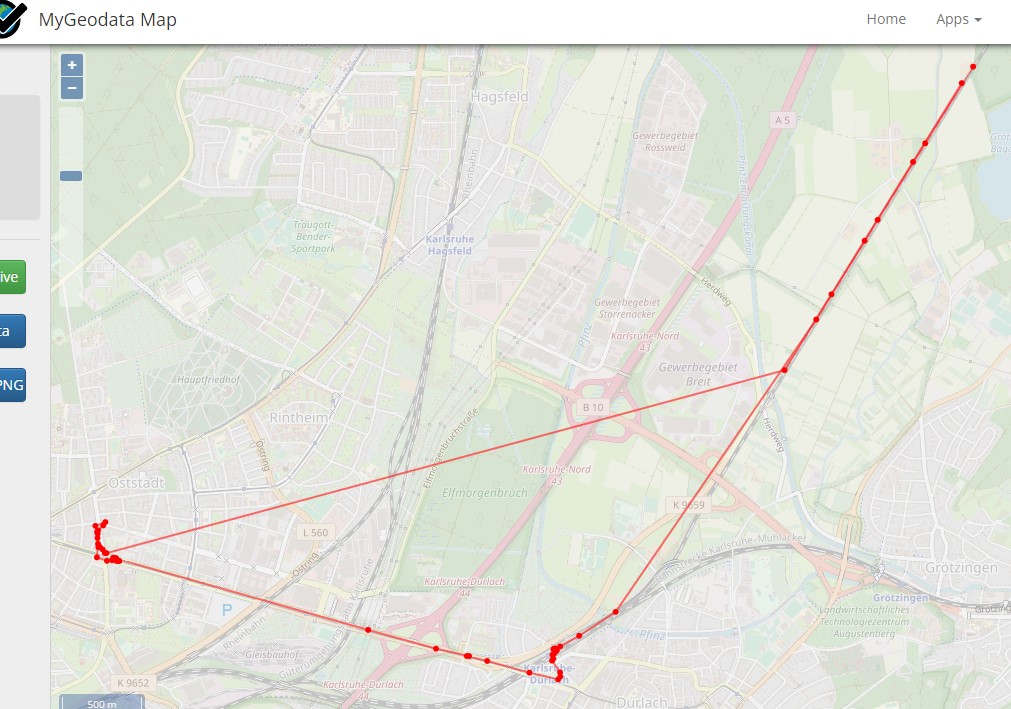
logs/20220302 Train Walk Case Maps.jpg
