enggsajjad/scooter/logs/20220302 Train Walk Case Temperature.jpg

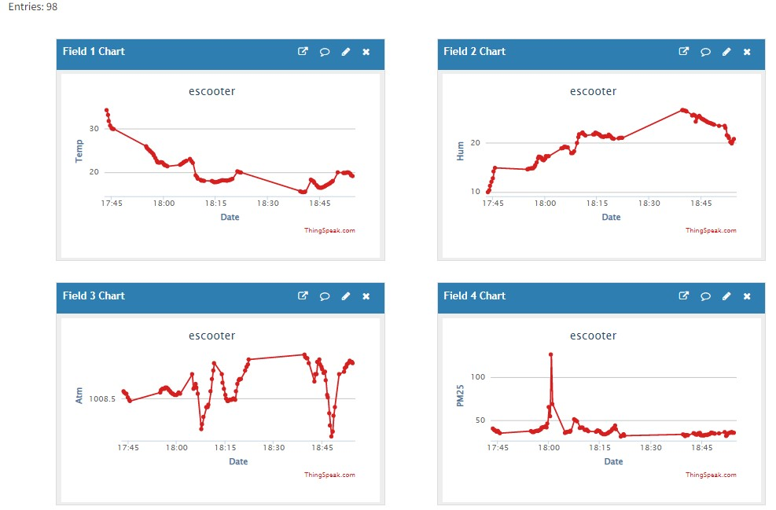
logs/20220302 Train Walk Case Temperature.jpg
