enggsajjad/scooter/logs/20220303 walking case maps.jpg

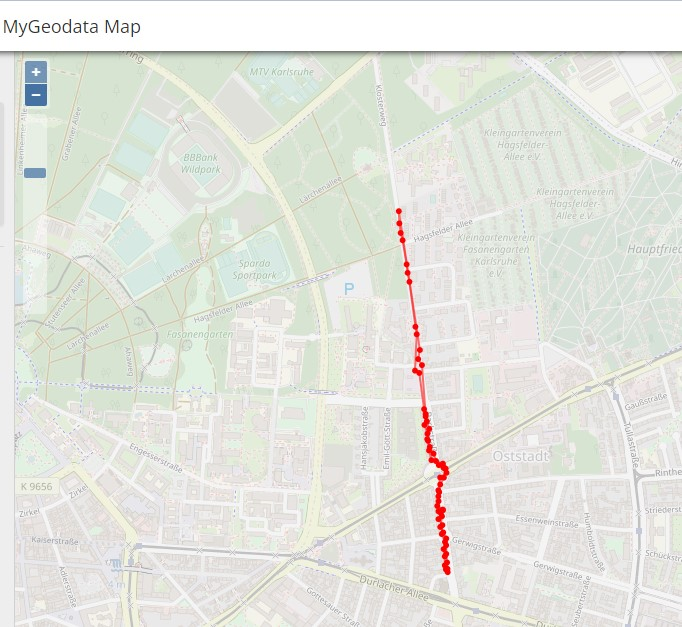
logs/20220303 walking case maps.jpg
