enggsajjad/scooter/logs/20220303 walking case temperature.jpg

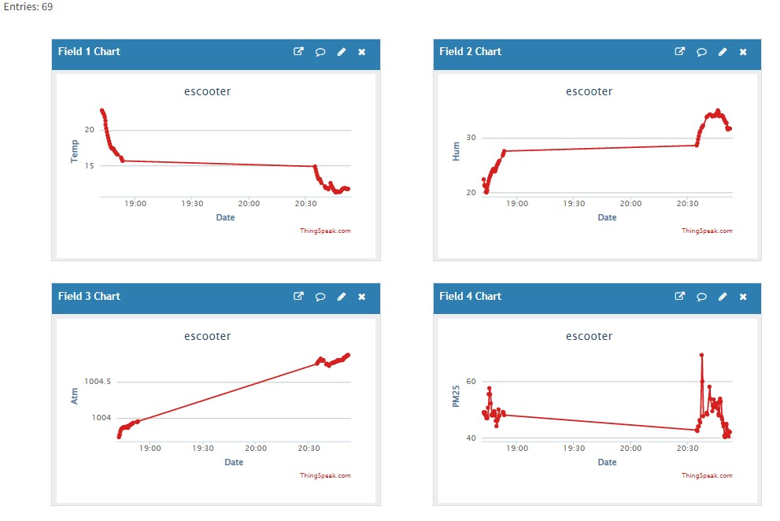
logs/20220303 walking case temperature.jpg
