enggsajjad/scooter/logs/20220304 Cycle Case maps.jpg

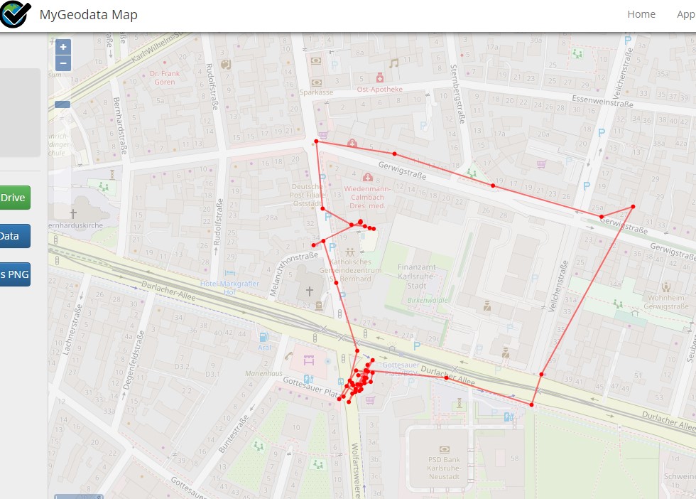
logs/20220304 Cycle Case maps.jpg
