enggsajjad/scooter/logs/20220304 Cycle Case Temperature.jpg

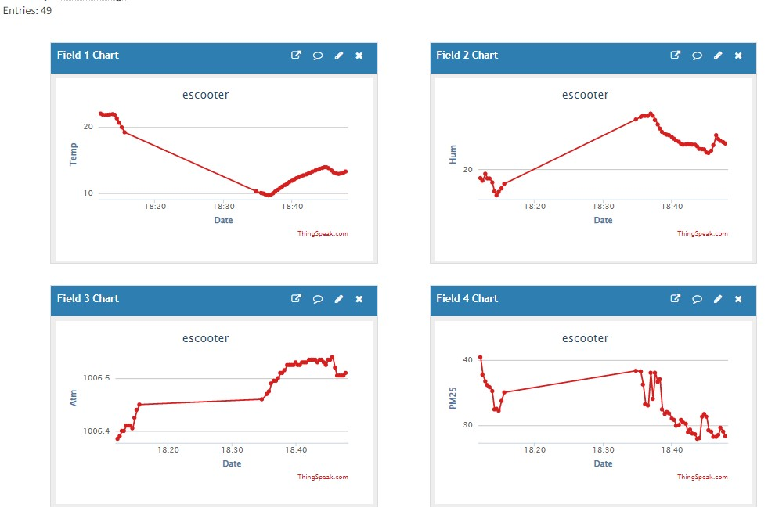
logs/20220304 Cycle Case Temperature.jpg
