enggsajjad/scooter/logs/20220304 Walk Case maps.jpg

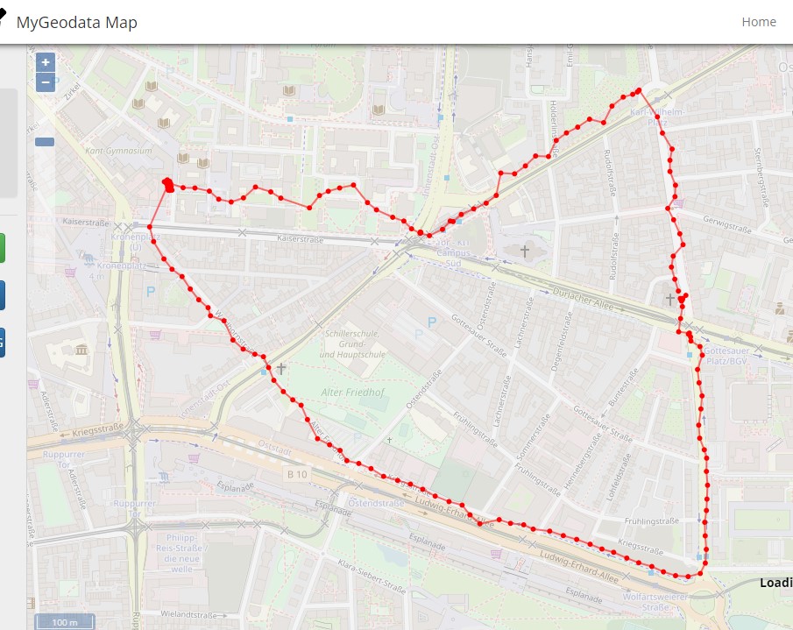
logs/20220304 Walk Case maps.jpg
