enggsajjad/scooter/logs/20220304 Walk Case Temperature.jpg

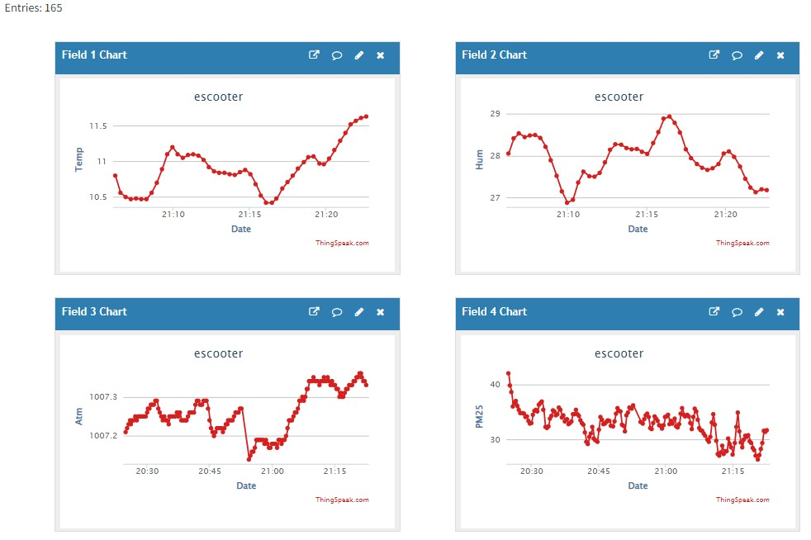
logs/20220304 Walk Case Temperature.jpg
