enggsajjad/scooter/logs/20220305 Walking case maps.jpg

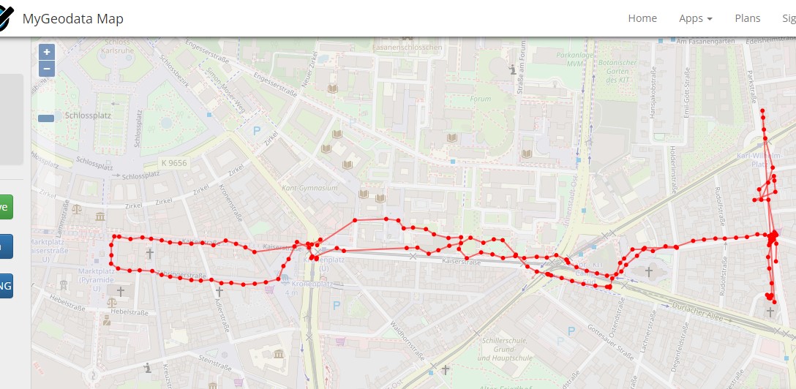
logs/20220305 Walking case maps.jpg
