enggsajjad/scooter/logs/20220305 Walking case temperature.jpg

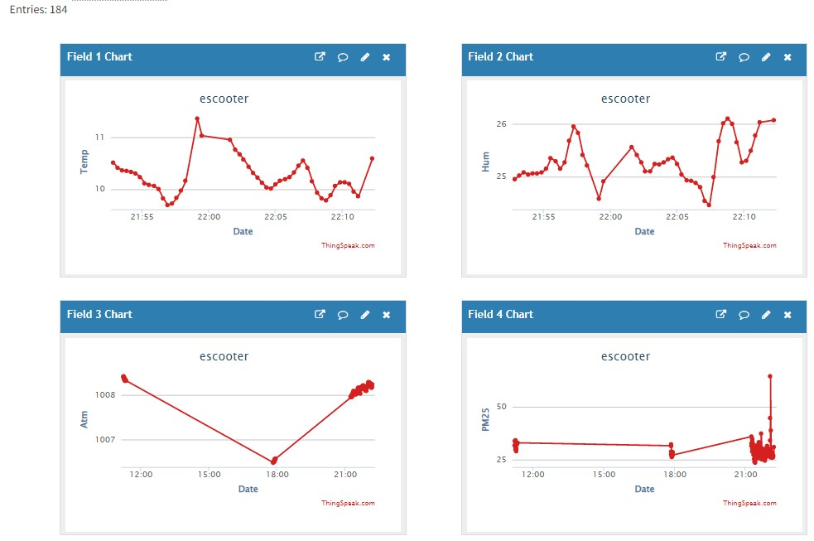
logs/20220305 Walking case temperature.jpg
