enggsajjad/scooter/logs/20220307 Charging Case Temperature.jpg

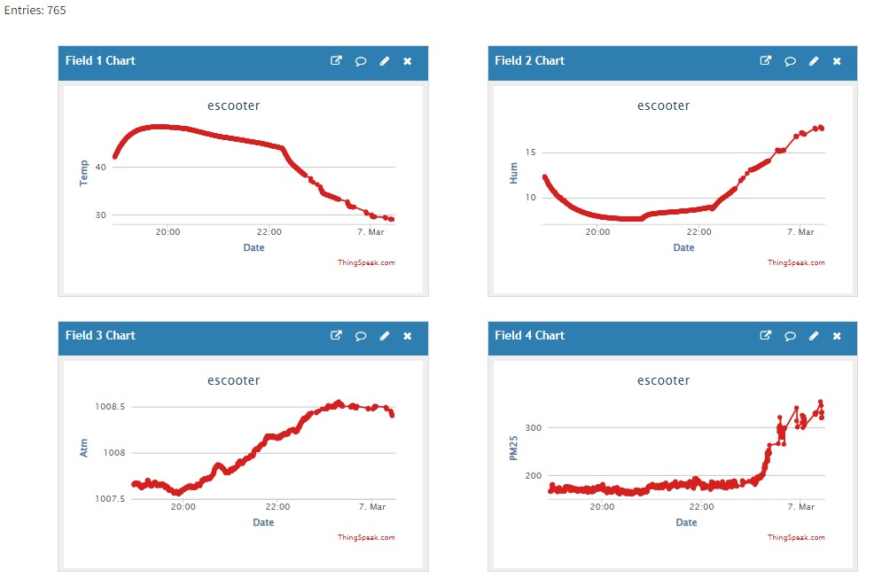
logs/20220307 Charging Case Temperature.jpg
