enggsajjad/scooter/logs/20220307 Walking case maps.jpg

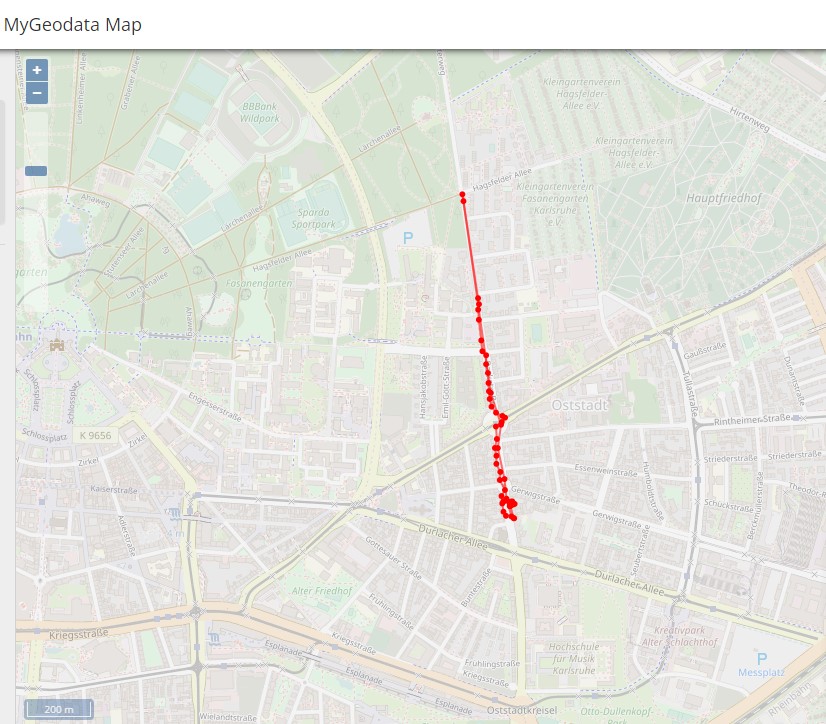
logs/20220307 Walking case maps.jpg
