enggsajjad/scooter/logs/20220307 Walking case temperature.jpg

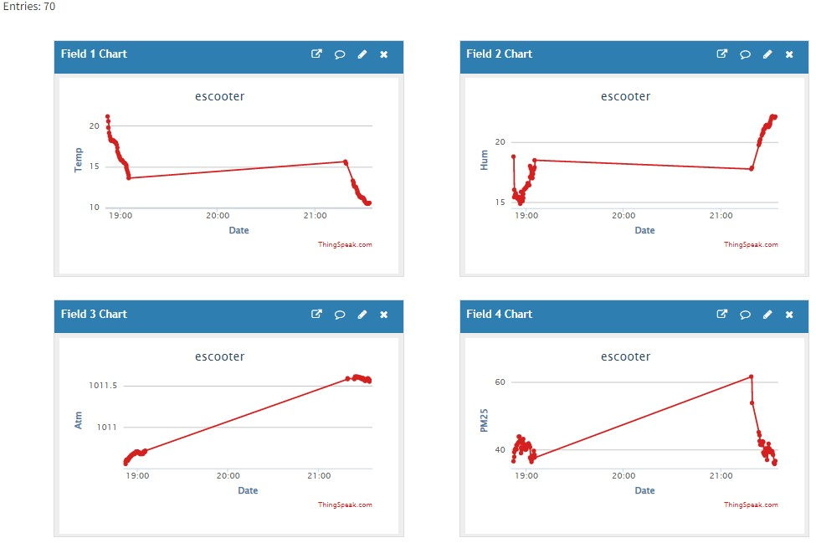
logs/20220307 Walking case temperature.jpg
