enggsajjad/scooter/logs/20220308 Cycle Case Map.jpg

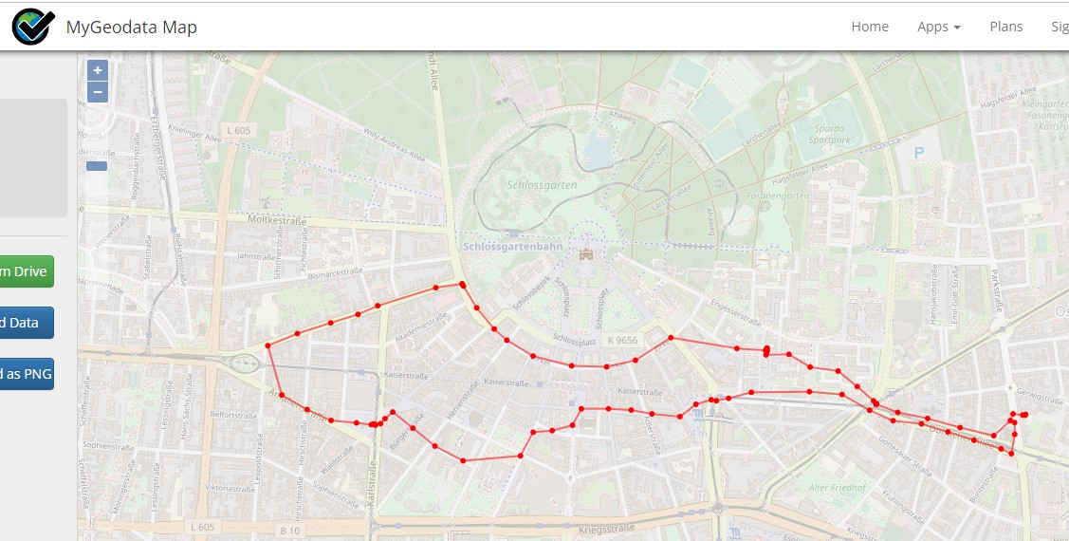
logs/20220308 Cycle Case Map.jpg
