enggsajjad/scooter/logs/20220308 Cycle Case temperature.jpg

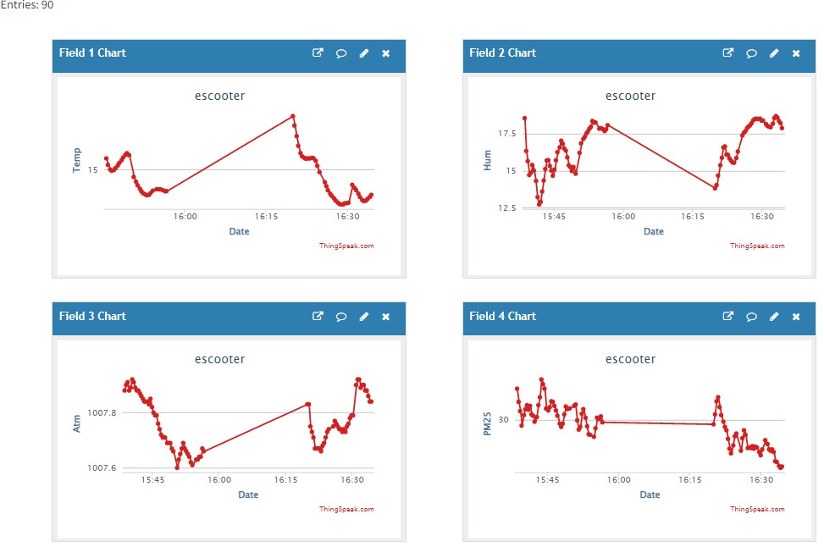
logs/20220308 Cycle Case temperature.jpg
