enggsajjad/scooter/logs/20220309 Walking Case Maps.jpg

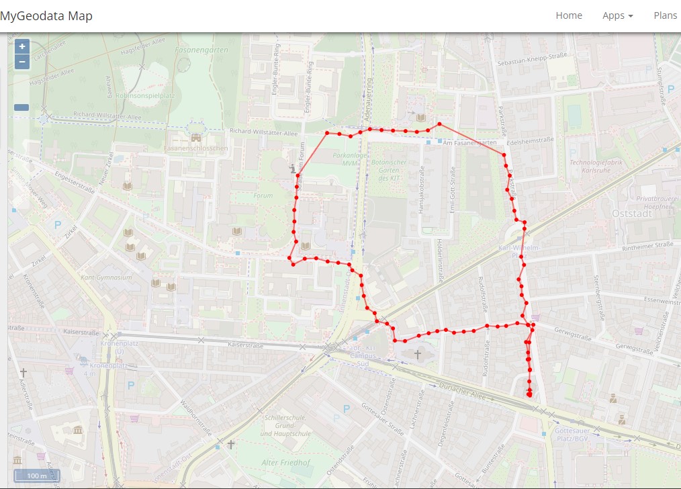
logs/20220309 Walking Case Maps.jpg
