enggsajjad/scooter/logs/20220309 Walking Case Temperature.jpg

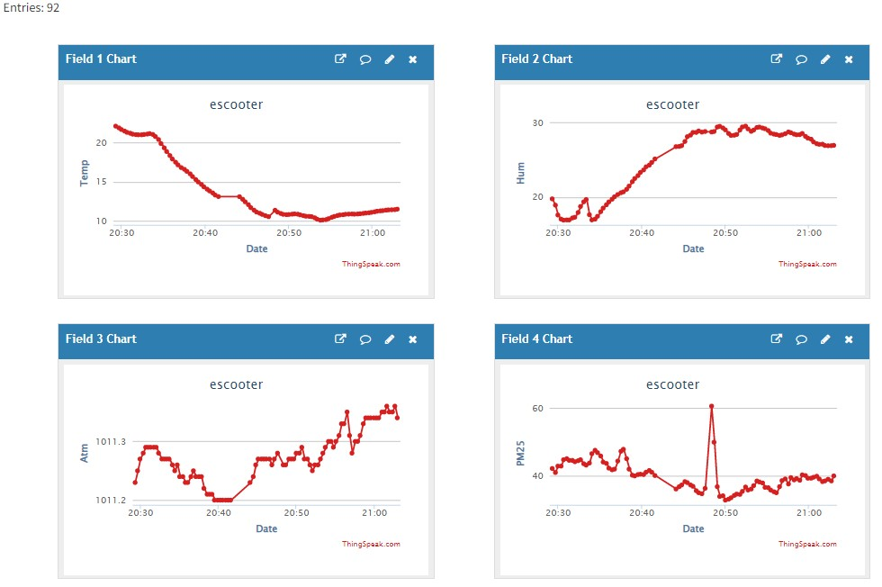
logs/20220309 Walking Case Temperature.jpg
