enggsajjad/scooter/logs/20220310 Walking Case Maps.jpg

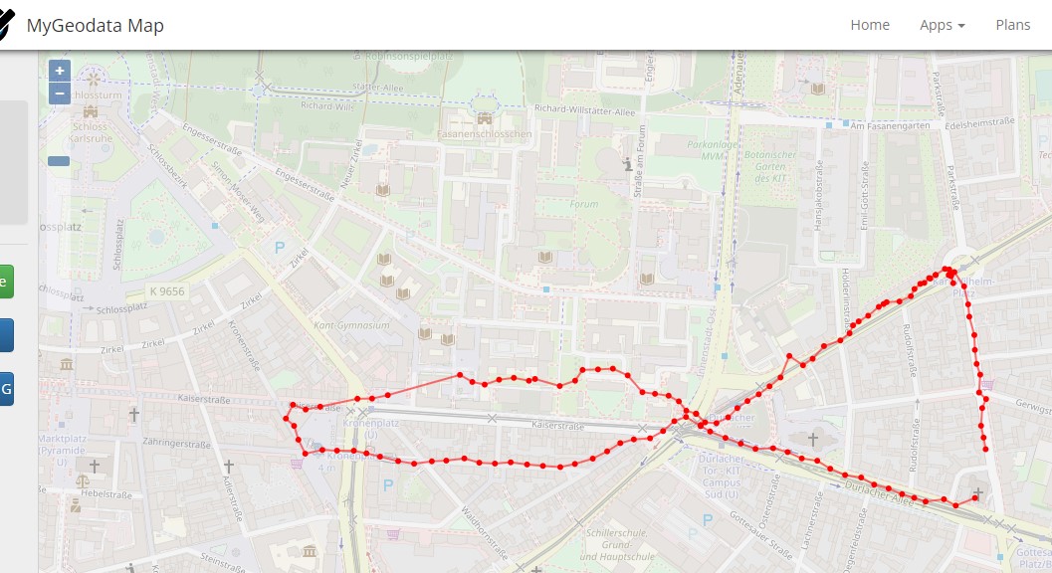
logs/20220310 Walking Case Maps.jpg
