enggsajjad/scooter/logs/20220310 Walking Case Temperature.jpg

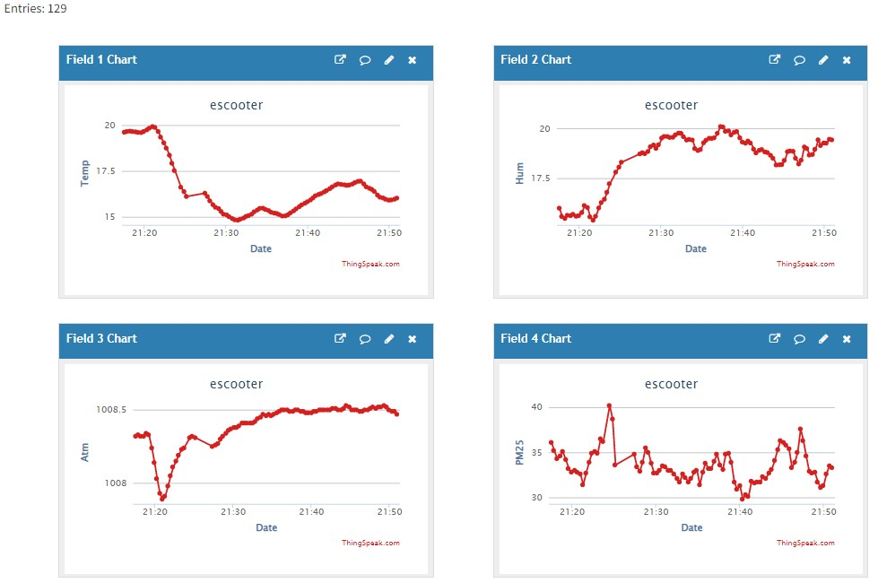
logs/20220310 Walking Case Temperature.jpg
