enggsajjad/scooter/logs/20220311 Cycling Walking Map.jpg

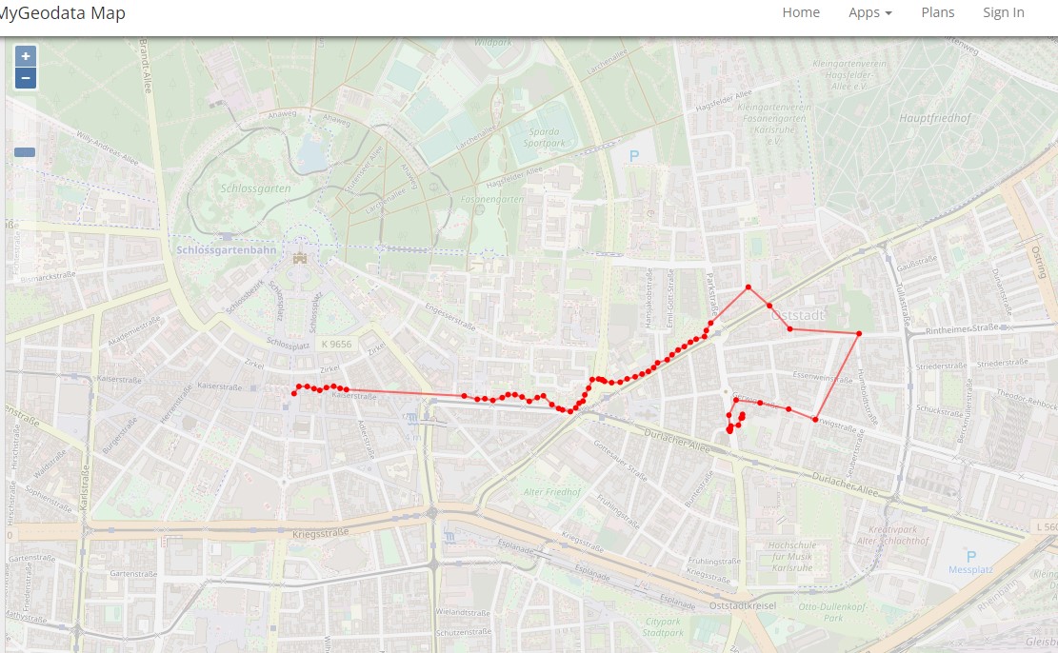
logs/20220311 Cycling Walking Map.jpg
