enggsajjad/scooter/logs/20220311 Cycling Walking Temperature.jpg

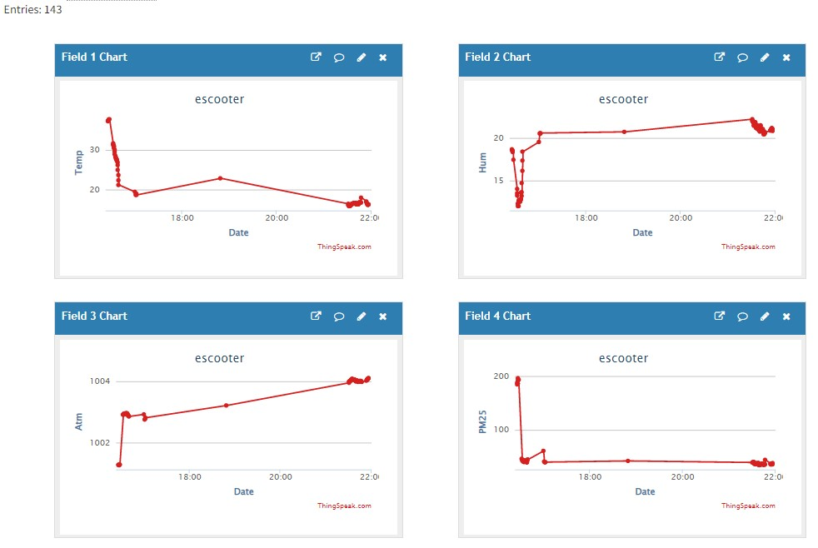
logs/20220311 Cycling Walking Temperature.jpg
