enggsajjad/scooter/logs/20220313 Train Cycle Walk Mannheim Heidelburg map part1.jpg

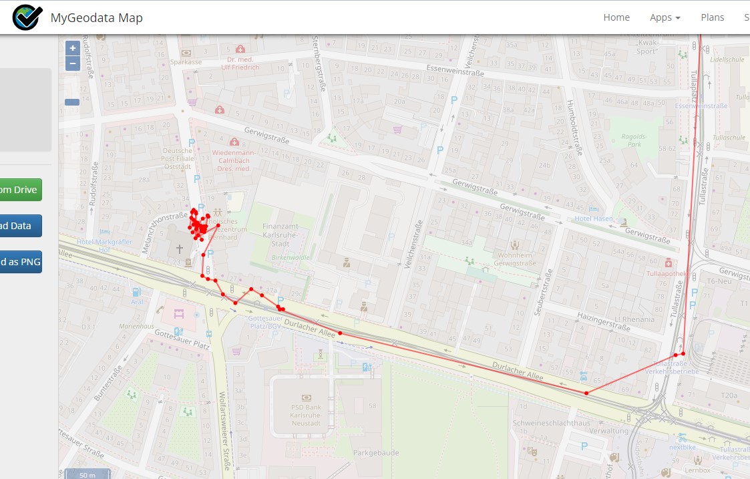
logs/20220313 Train Cycle Walk Mannheim Heidelburg map part1.jpg
