enggsajjad/scooter/logs/20220313 Train Cycle Walk Mannheim Heidelburg map part3.jpg

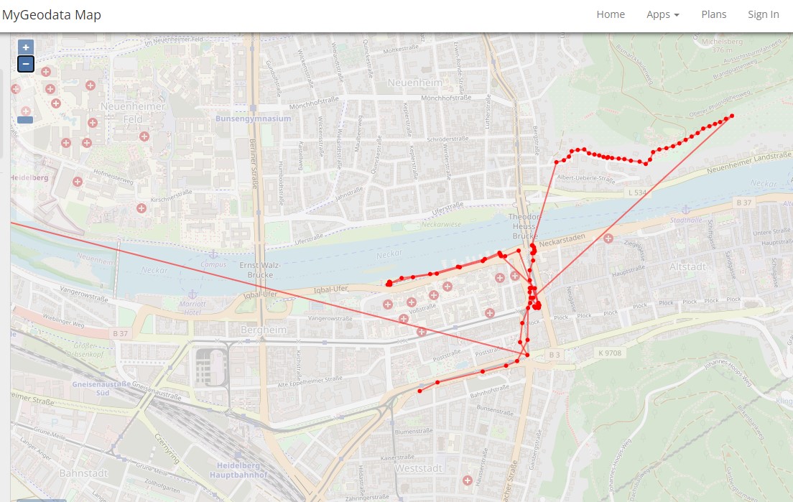
logs/20220313 Train Cycle Walk Mannheim Heidelburg map part3.jpg
