enggsajjad/scooter/logs/20220313 Train Cycle Walk Mannheim Heidelburg map.jpg

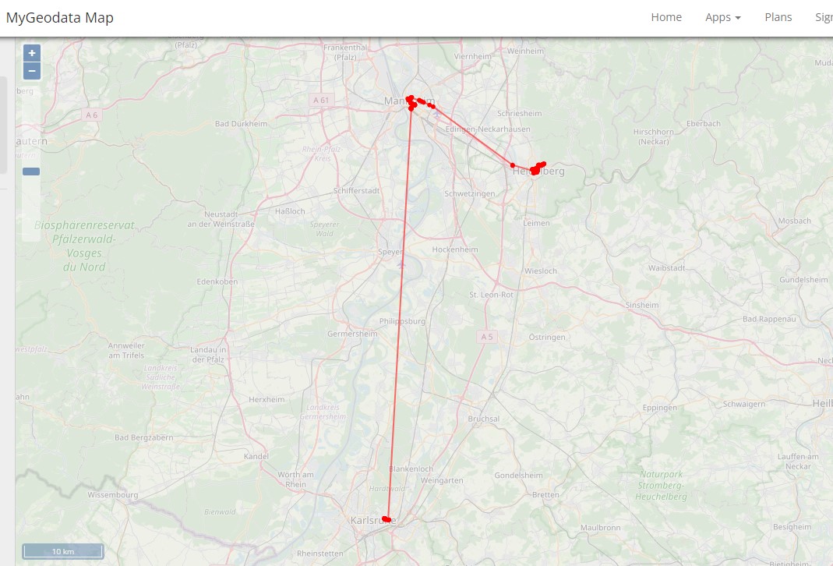
logs/20220313 Train Cycle Walk Mannheim Heidelburg map.jpg
