enggsajjad/scooter/logs/20220313 Train Cycle Walk Mannheim Heidelburg temperature.jpg

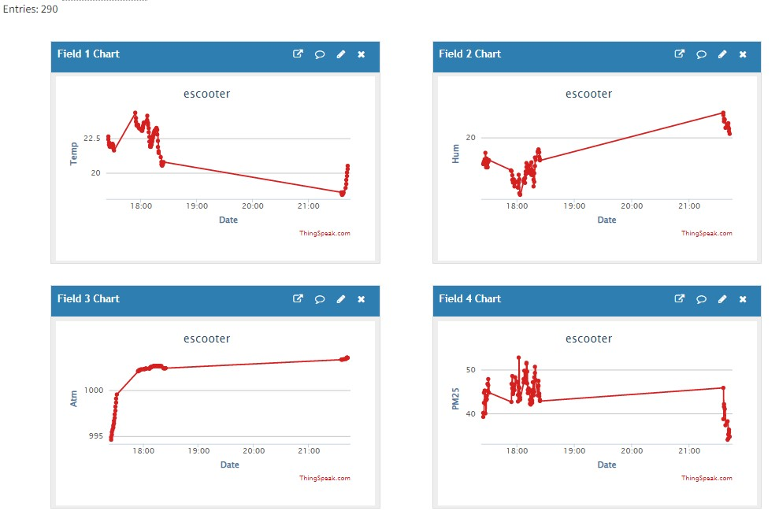
logs/20220313 Train Cycle Walk Mannheim Heidelburg temperature.jpg
