enggsajjad/scooter/logs/20220314 Cycling to Oberreut maps.jpg

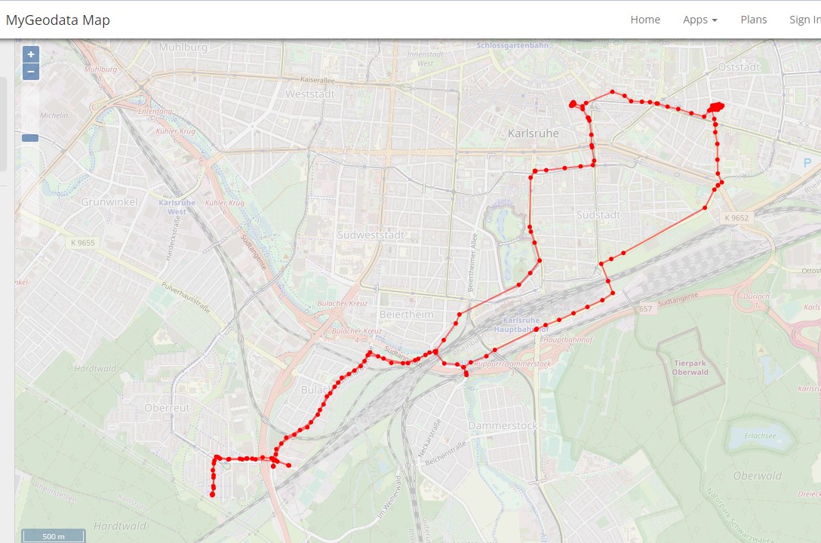
logs/20220314 Cycling to Oberreut maps.jpg
