enggsajjad/scooter/logs/20220314 Cycling to Oberreut temperature.jpg

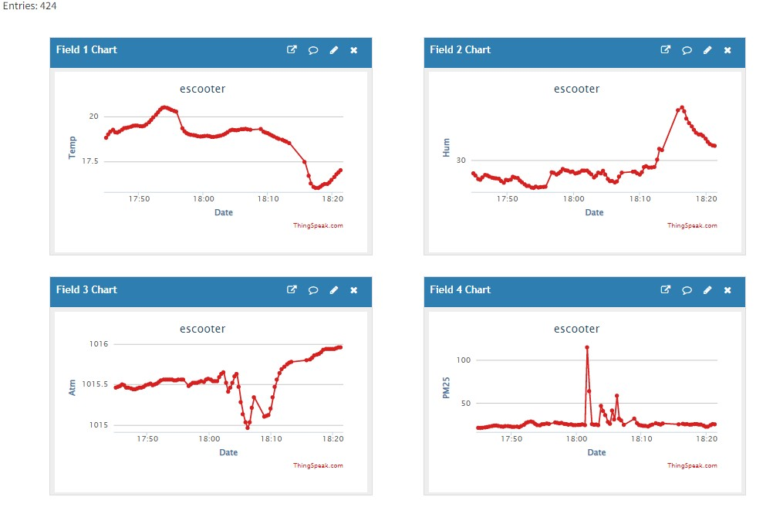
logs/20220314 Cycling to Oberreut temperature.jpg
