enggsajjad/scooter/logs/20220315 Walking Case Maps.jpg

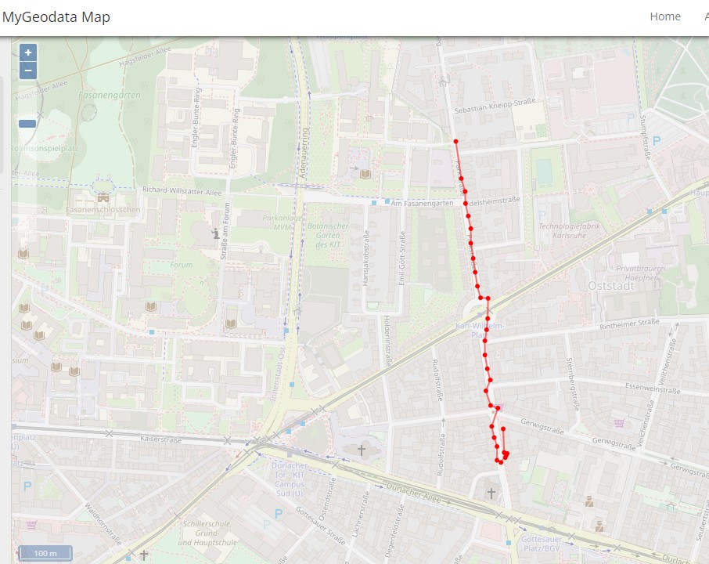
logs/20220315 Walking Case Maps.jpg
