enggsajjad/scooter/logs/20220315 Walking Case Temperature.jpg

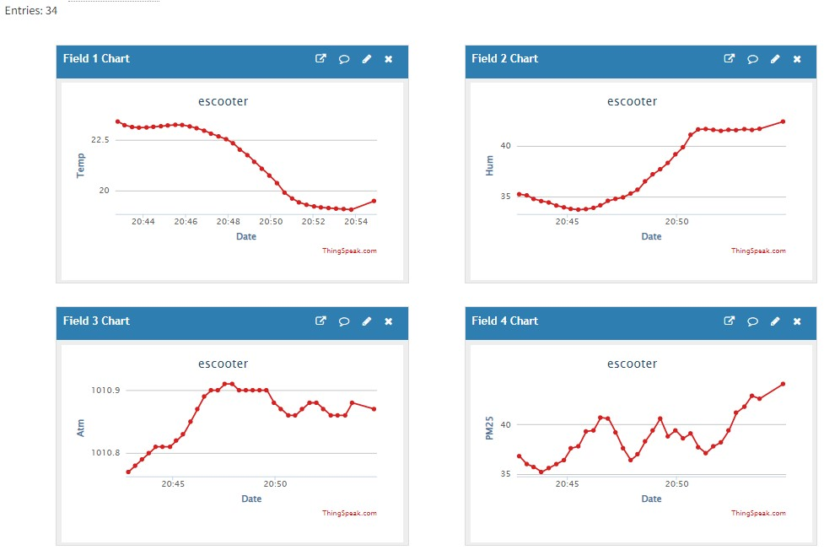
logs/20220315 Walking Case Temperature.jpg
