enggsajjad/scooter/logs/20220316 Walking Cycle Case maps.jpg

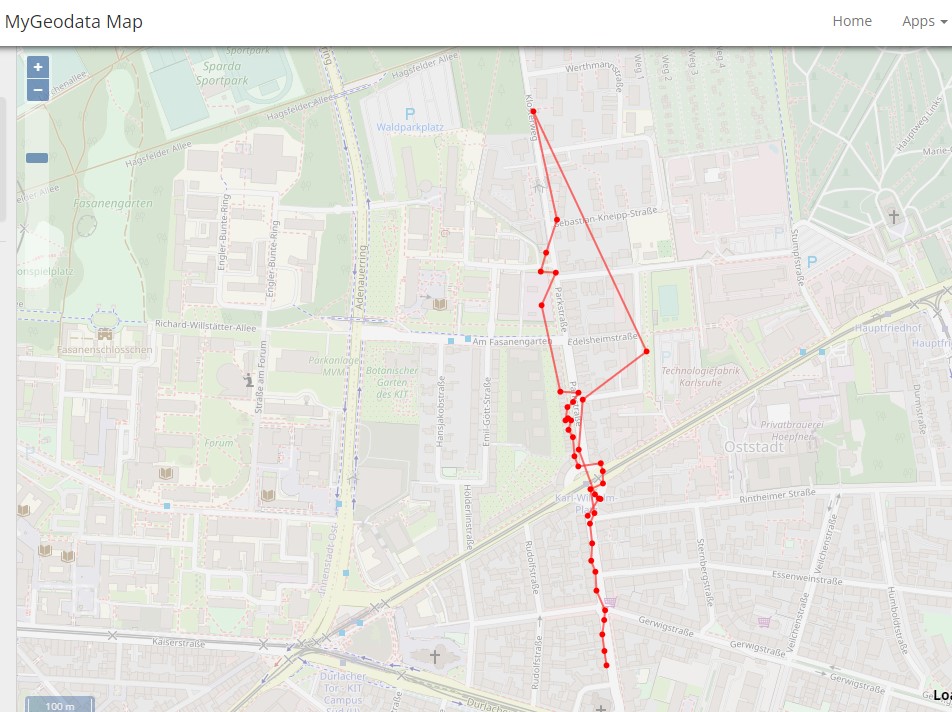
logs/20220316 Walking Cycle Case maps.jpg
