enggsajjad/scooter/logs/20220316 Walking Cycle Case temperature.jpg

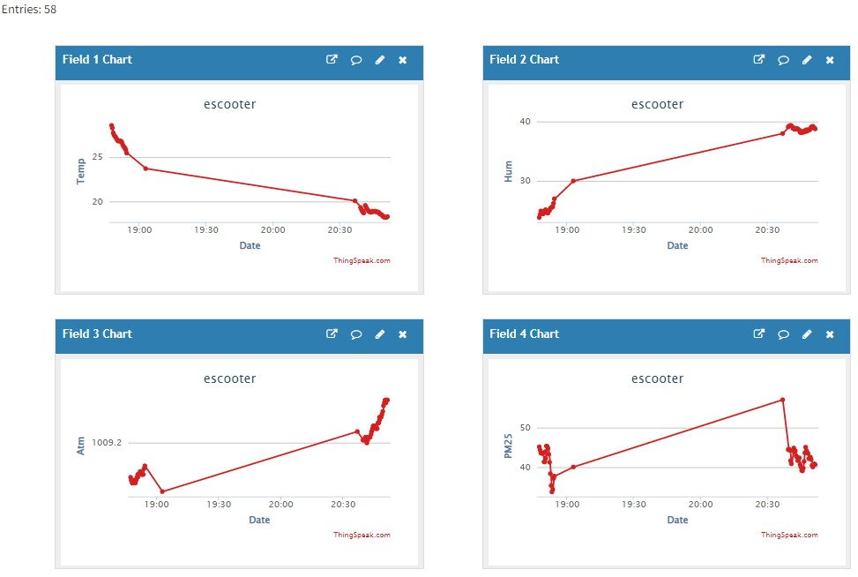
logs/20220316 Walking Cycle Case temperature.jpg
