enggsajjad/scooter/logs/20220317 Cycle Case Maps.jpg

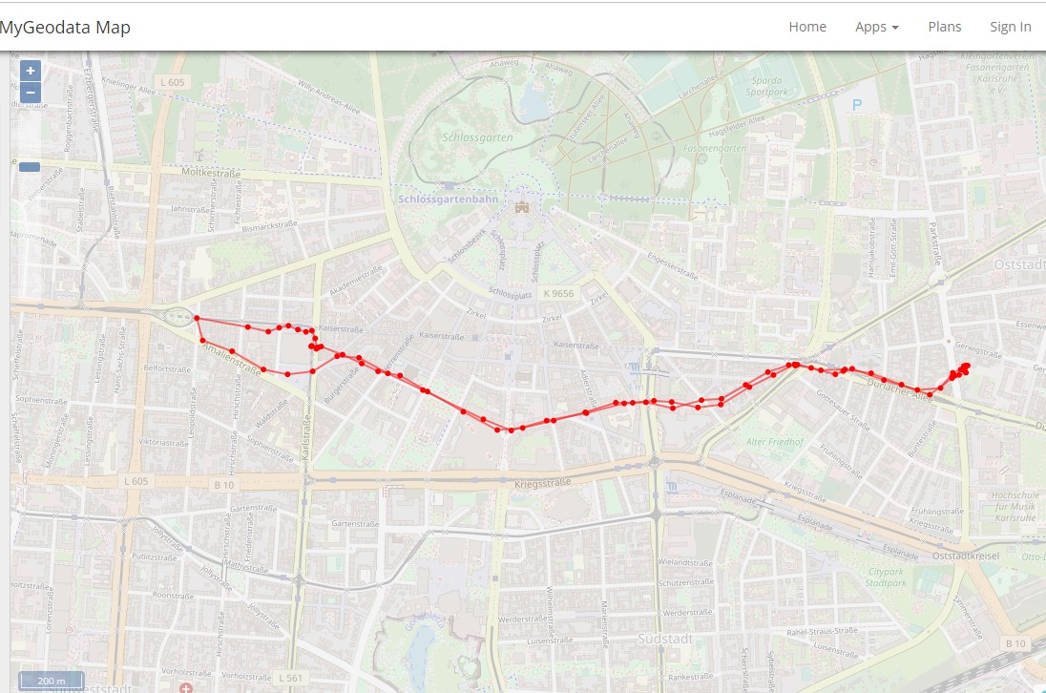
logs/20220317 Cycle Case Maps.jpg
