enggsajjad/scooter/logs/20220317 Cycle Case Temperature.jpg

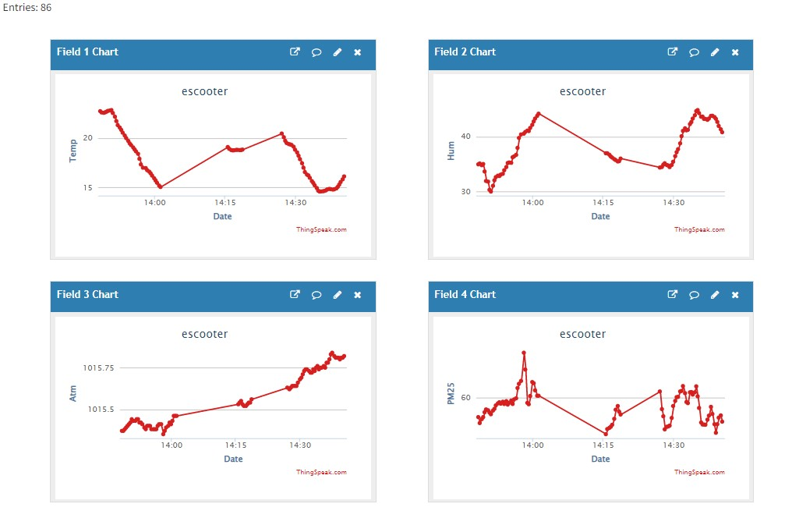
logs/20220317 Cycle Case Temperature.jpg
