enggsajjad/scooter/logs/20220401 Charging in the room temperature.jpg

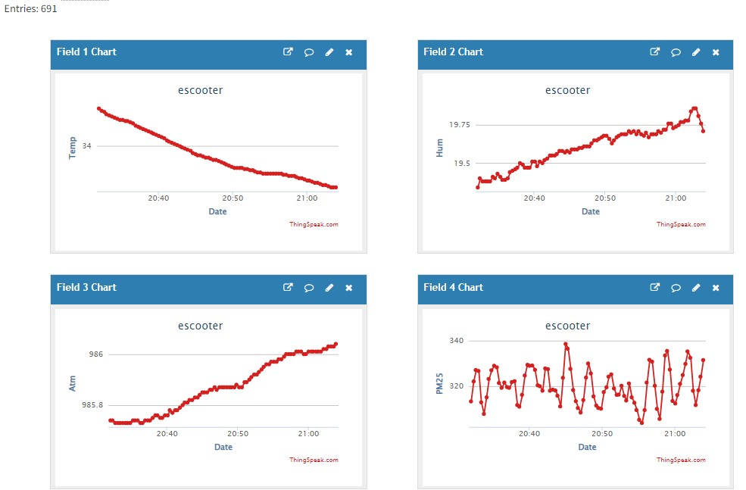
logs/20220401 Charging in the room temperature.jpg
