enggsajjad/scooter/logs/20220401 Walking Maps.jpg

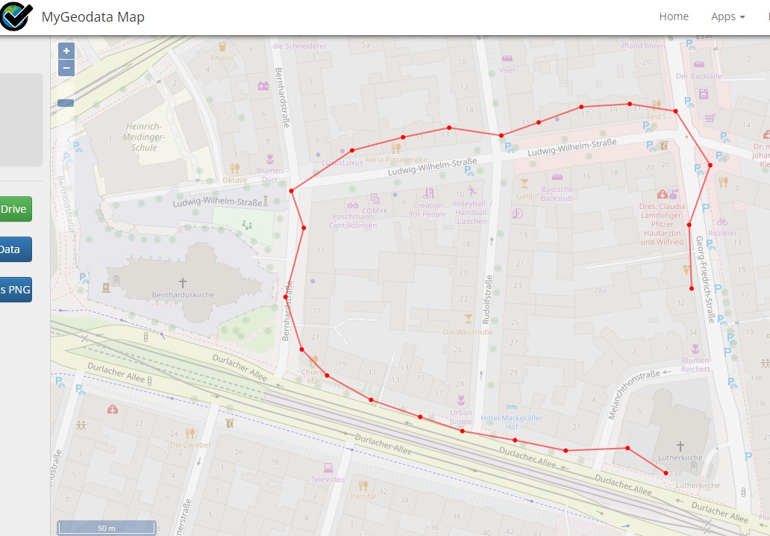
logs/20220401 Walking Maps.jpg
