enggsajjad/scooter/logs/20220401 Walking Temperature.jpg

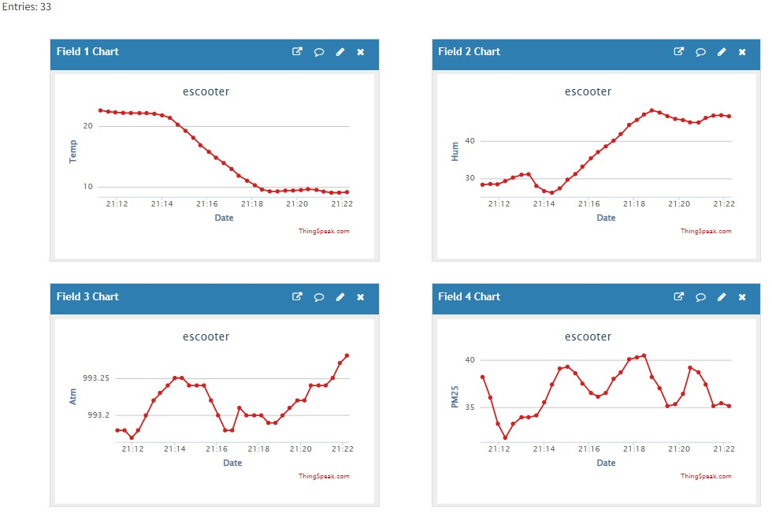
logs/20220401 Walking Temperature.jpg
