enggsajjad/scooter/logs/20220416 Charging.jpg

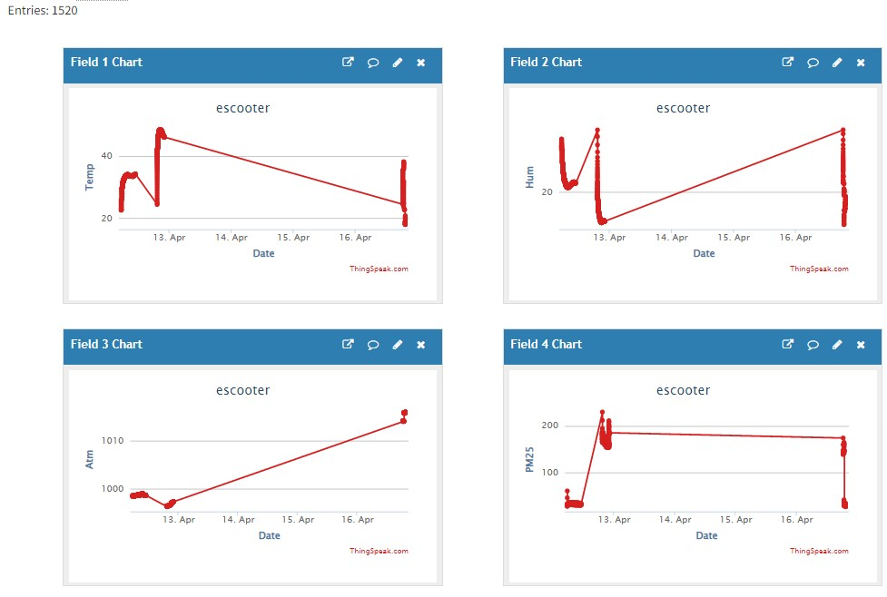
logs/20220416 Charging.jpg
