enggsajjad/scooter/logs/20220519 Walking Map.jpg

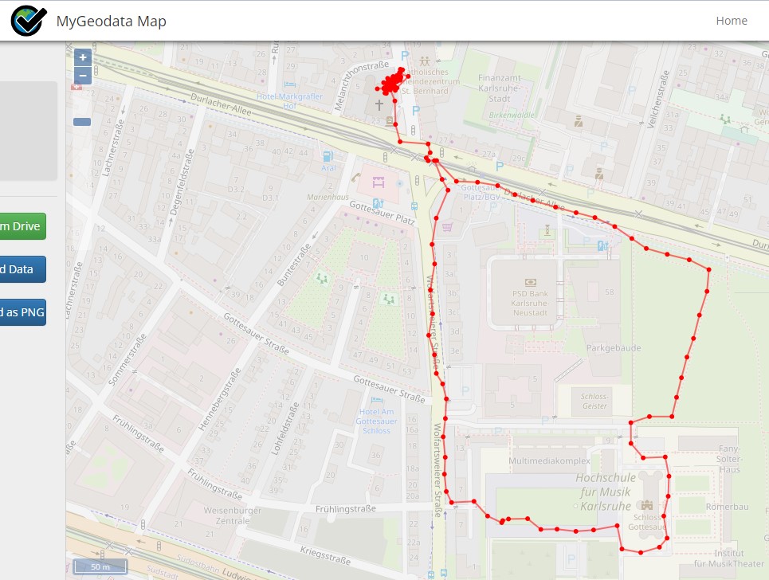
logs/20220519 Walking Map.jpg
