enggsajjad/scooter/logs/20220519 Walking Temperatures.jpg

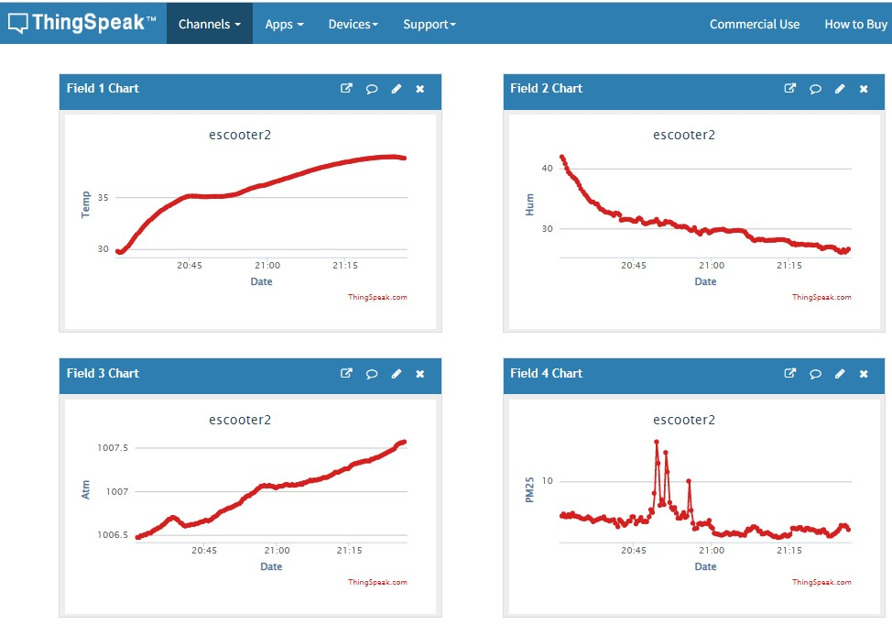
logs/20220519 Walking Temperatures.jpg
