enggsajjad/scooter/logs/20220520 Walking Map.jpg

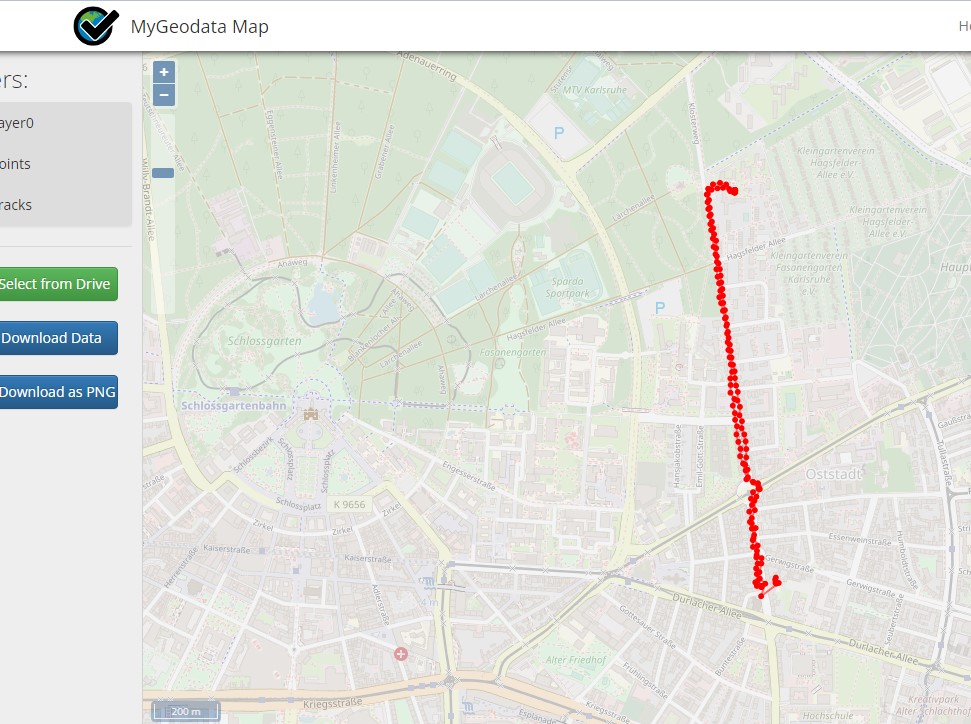
logs/20220520 Walking Map.jpg
