enggsajjad/scooter/logs/20220520 Walking Temperatures.jpg

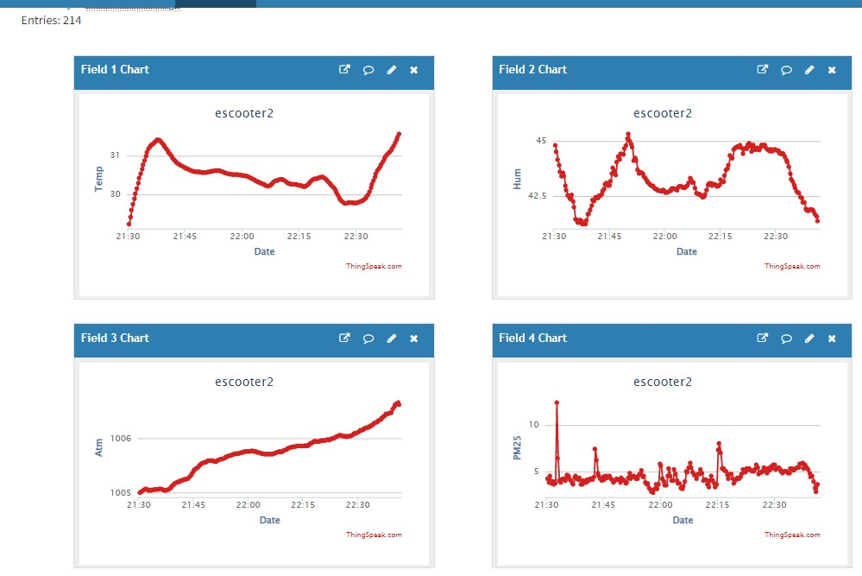
logs/20220520 Walking Temperatures.jpg
