enggsajjad/scooter/logs/202112271751 start 1751 Out 1753 Train 1803 Walking 1827 - 1833 Room 1850 stopped when train entered in the tunnel map.png

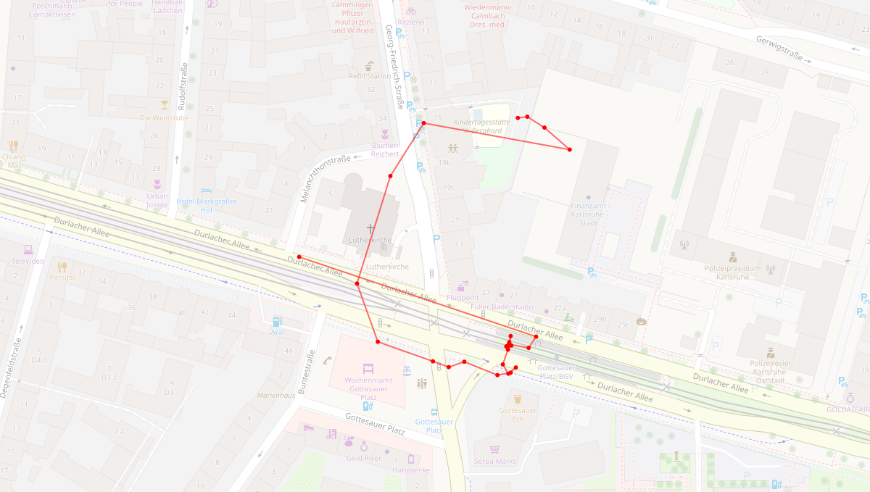
logs/202112271751 start 1751 Out 1753 Train 1803 Walking 1827 - 1833 Room 1850 stopped when train entered in the tunnel map.png
