enggsajjad/scooter/logs/202201152200 walk till commerzbank and then teco, stopped in the middle maps.png

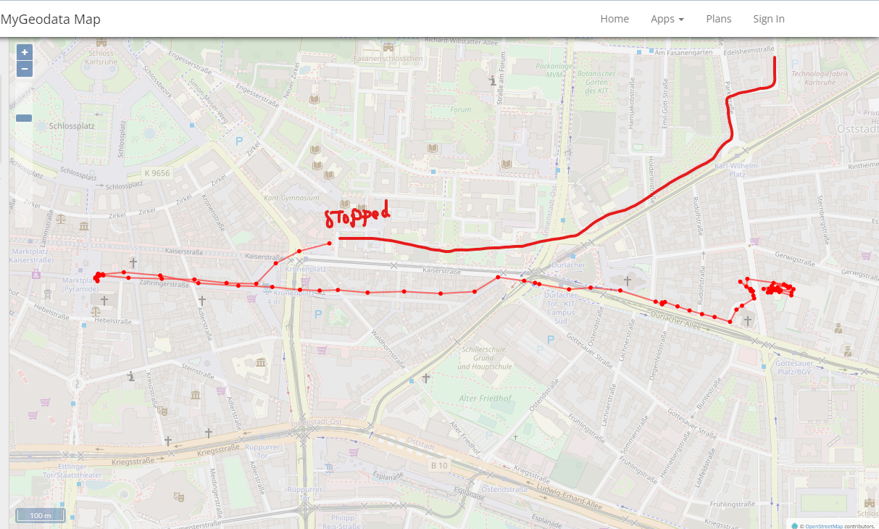
logs/202201152200 walk till commerzbank and then teco, stopped in the middle maps.png
