enggsajjad/scooter/logs/202202091818 Cycling+Walking till EtlingerTor Gap 1835 1848 inside EtlingerTor maps.jpg

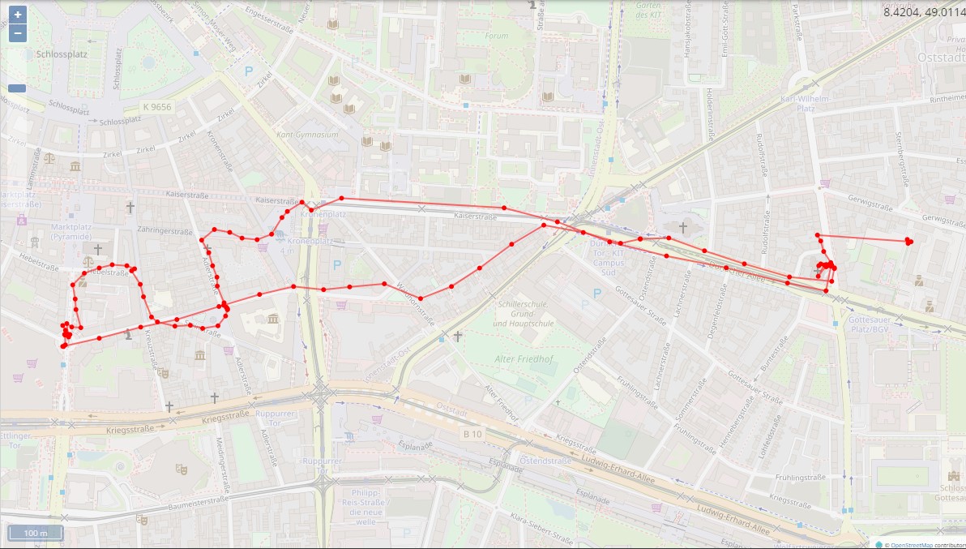
logs/202202091818 Cycling+Walking till EtlingerTor Gap 1835 1848 inside EtlingerTor maps.jpg
