enggsajjad/scooter/logs/202202092036  Walking map.jpg

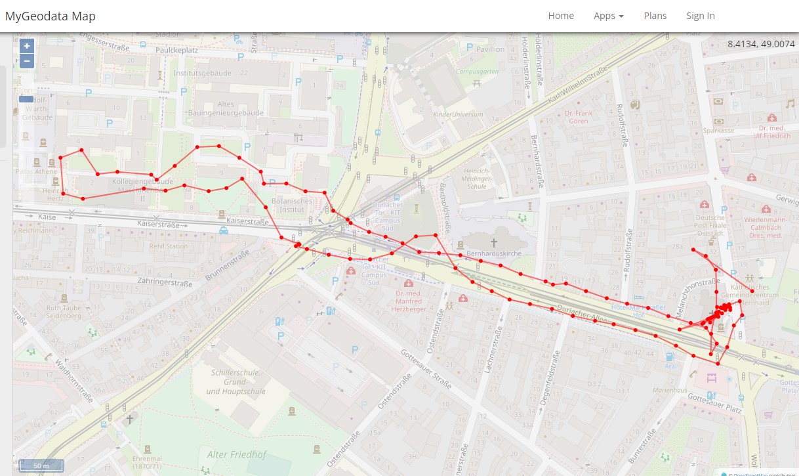
logs/202202092036 Walking map.jpg
