enggsajjad/scooter/logs/202202092036  Walking Temperature.jpg

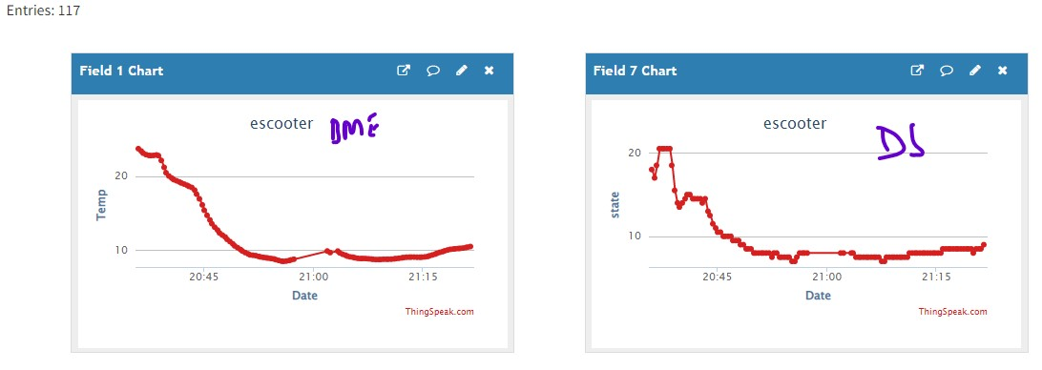
logs/202202092036 Walking Temperature.jpg
