enggsajjad/scooter/logs/20211225162715 start 2021-12-25T155930, end 2021-12-25T162715, values 82, 1665s 20s per value, no error, walking 1608 till 1622 GPS tracking OK MAPS.png

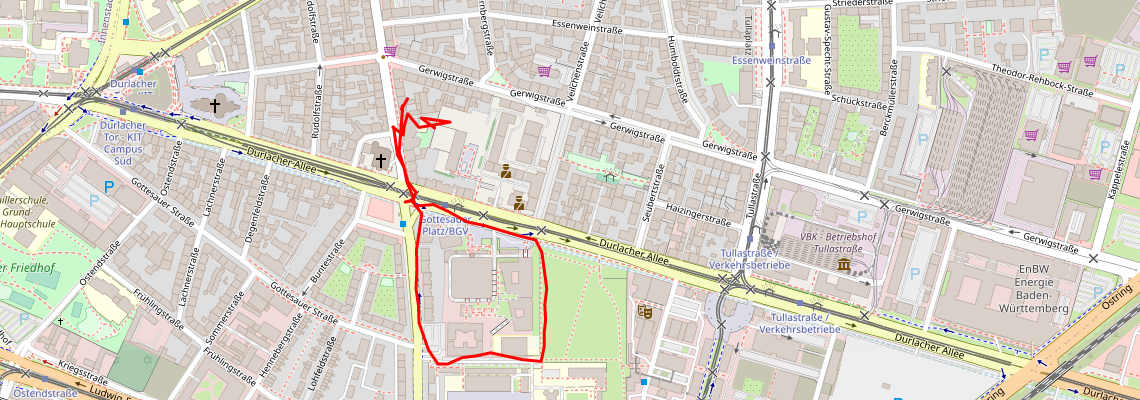
logs/20211225162715 start 2021-12-25T155930, end 2021-12-25T162715, values 82, 1665s 20s per value, no error, walking 1608 till 1622 GPS tracking OK MAPS.png
