enggsajjad/scooter/logs/20211229212632 Walking, stopped send data.png

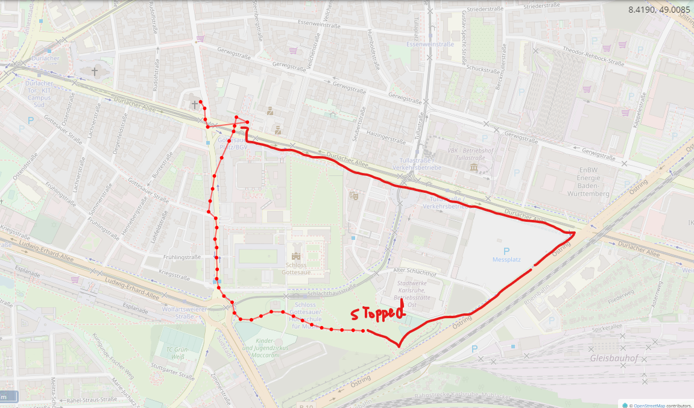
logs/20211229212632 Walking, stopped send data.png
