enggsajjad/scooter/logs/20211230202554 Walking again stopped after some time..png

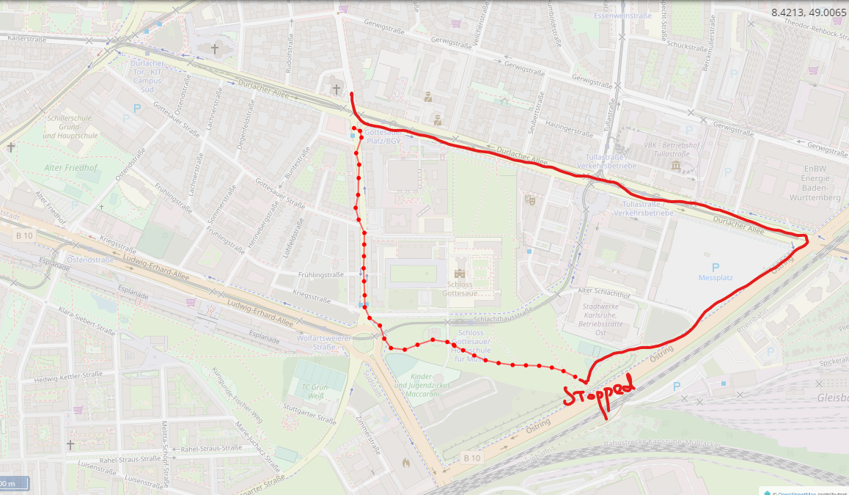
logs/20211230202554 Walking again stopped after some time..png
