enggsajjad/scooter/logs/20220101133327 Walking towards durlach and stopped in the middle, power off, map.png

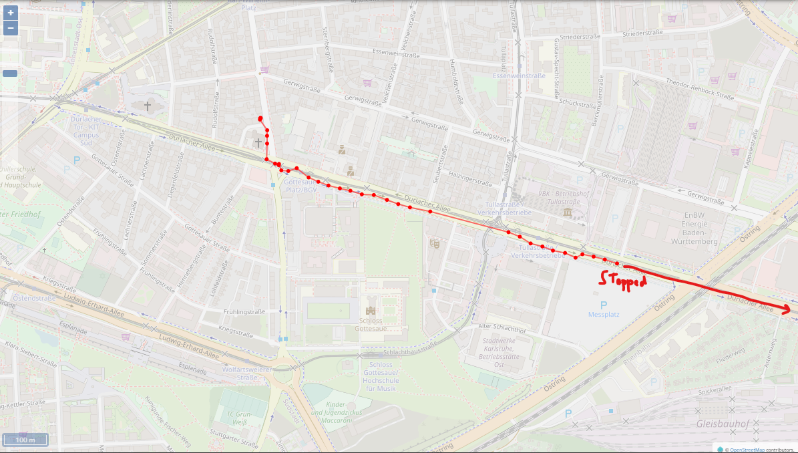
logs/20220101133327 Walking towards durlach and stopped in the middle, power off, map.png
