enggsajjad/scooter/logs/20220113221410 cycle start 1735 to hadiko return 1911, walk 2011, return 2100, stopped many times maps.png

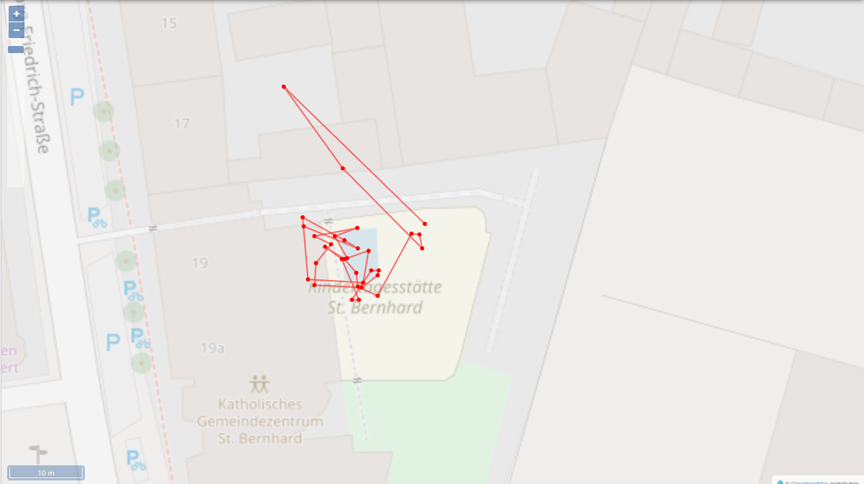
logs/20220113221410 cycle start 1735 to hadiko return 1911, walk 2011, return 2100, stopped many times maps.png
