enggsajjad/scooter/logs/20220114152412 uncovered running at home for hours, walk 1300 after some time gives errors maps.png

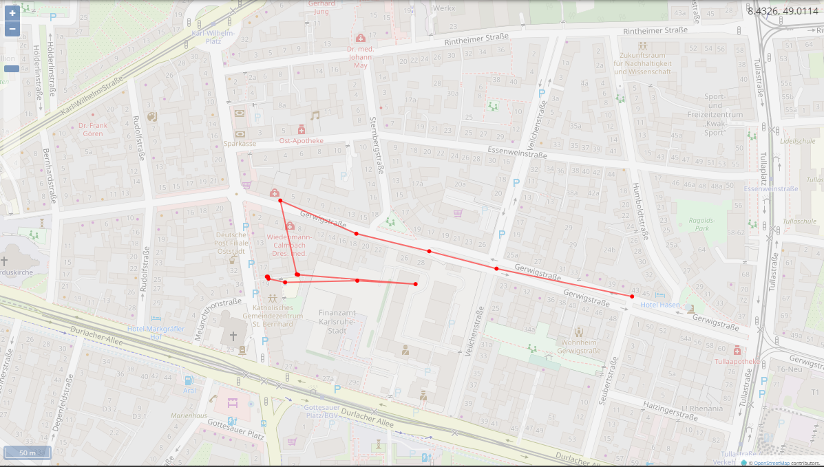
logs/20220114152412 uncovered running at home for hours, walk 1300 after some time gives errors maps.png
