enggsajjad/scooter/logs/20220114235317 Walikng 2037 returned 2129 seconds 3120 values 164 OK maps.png

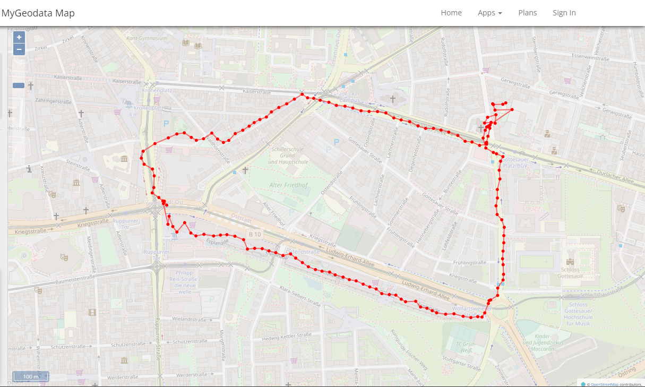
logs/20220114235317 Walikng 2037 returned 2129 seconds 3120 values 164 OK maps.png
