enggsajjad/scooter/logs/20220115204445 error while walking log before and after walk maps.png

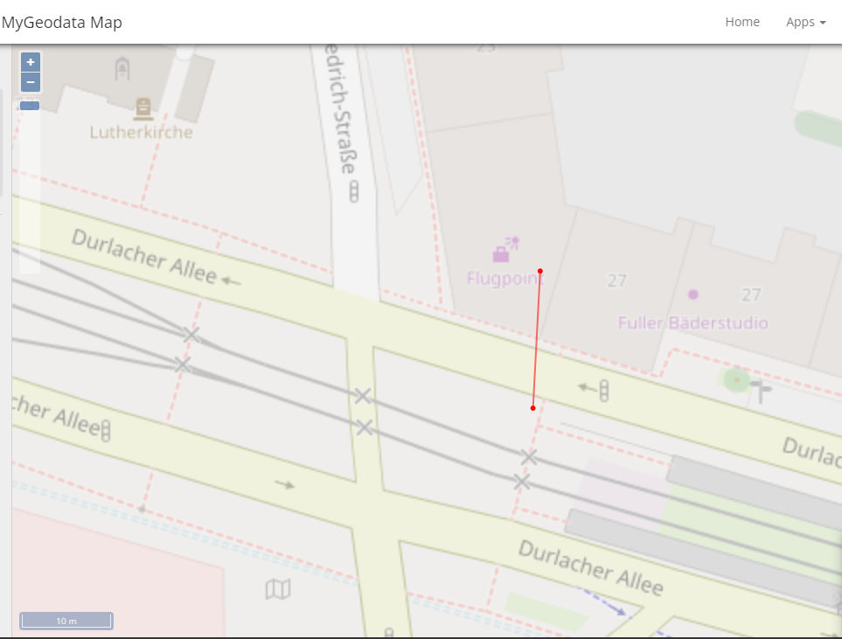
logs/20220115204445 error while walking log before and after walk maps.png
