enggsajjad/scooter/logs/20220116000444 in room with ds1820 comparasion BME vs  DS1820.png

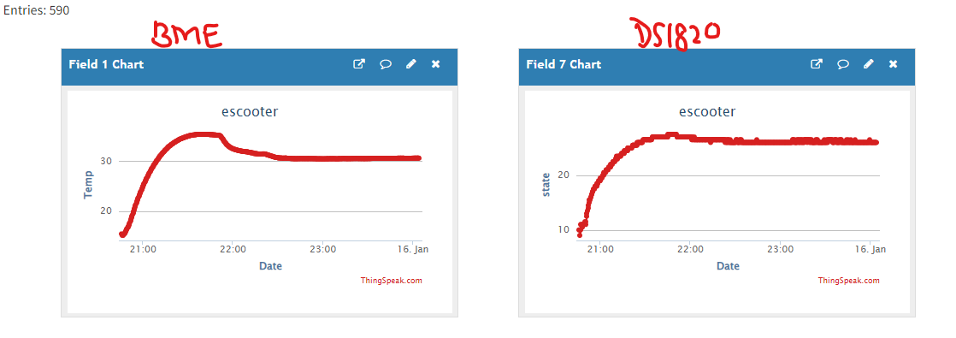
logs/20220116000444 in room with ds1820 comparasion BME vs DS1820.png
