enggsajjad/scooter/logs/20220207213808 Walk 2022-02-07T201214 2022-02-07T212318, Gap 205500 - 205848, 192 values initial logs temperature.png

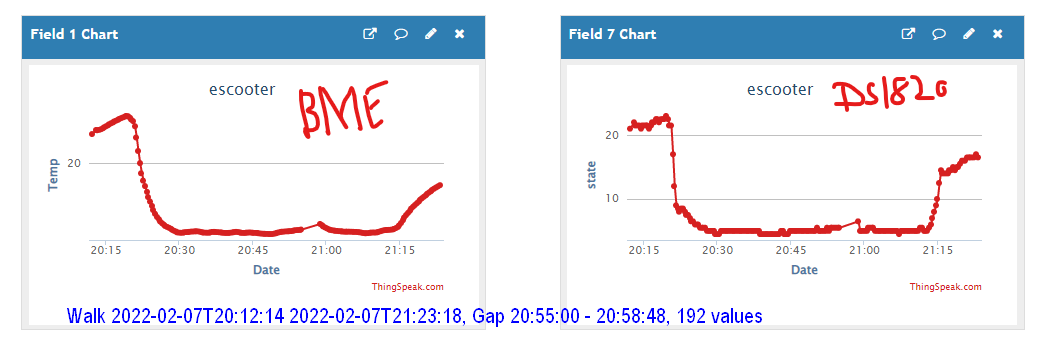
logs/20220207213808 Walk 2022-02-07T201214 2022-02-07T212318, Gap 205500 - 205848, 192 values initial logs temperature.png
