enggsajjad/scooter/logs/20220208201444 Walking Maps.jpg

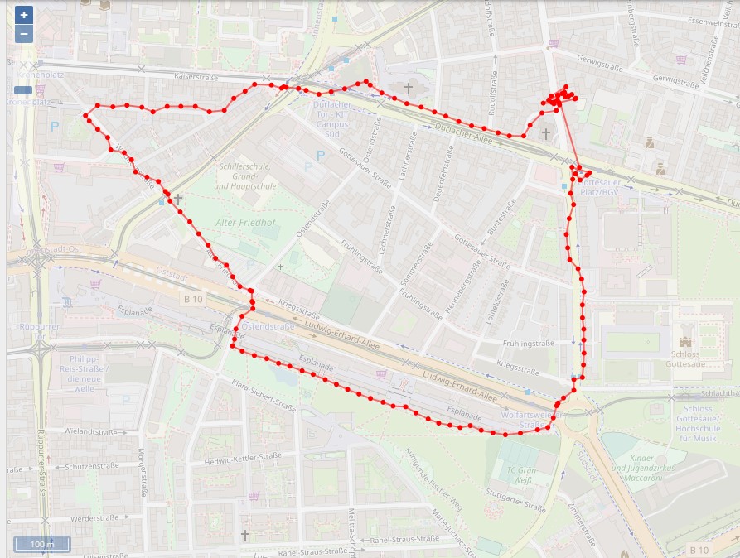
logs/20220208201444 Walking Maps.jpg
