enggsajjad/scooter/logs/20220208201444 Walking Temperature.jpg

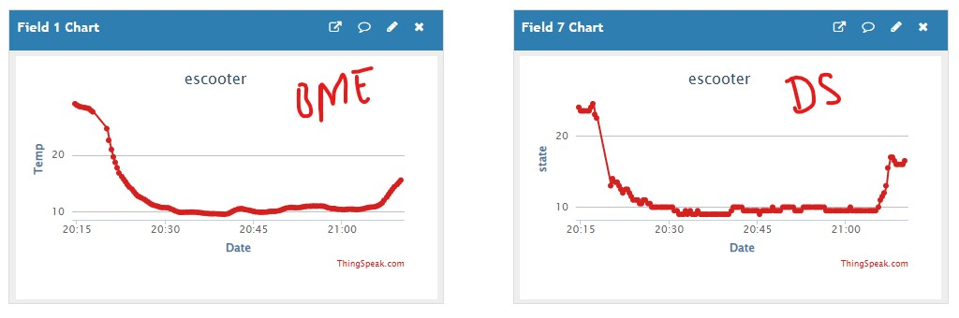
logs/20220208201444 Walking Temperature.jpg
