enggsajjad/scooter/logs/boot button and 10uf capacitor.jpg

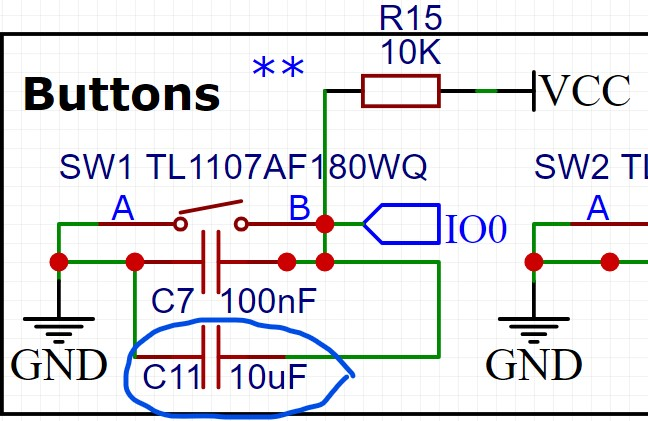
logs/boot button and 10uf capacitor.jpg
