enggsajjad/scooter/logs/boot button and ciruit with auto rc 2s timing.jpg

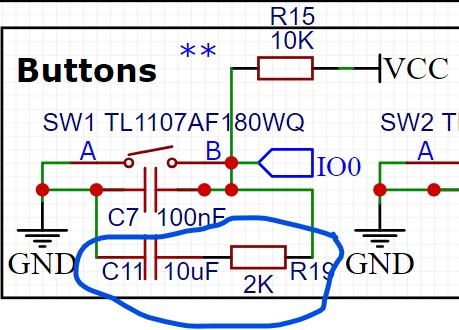
logs/boot button and ciruit with auto rc 2s timing.jpg
