enggsajjad/scooter/logs/boot button and ciruit.jpg

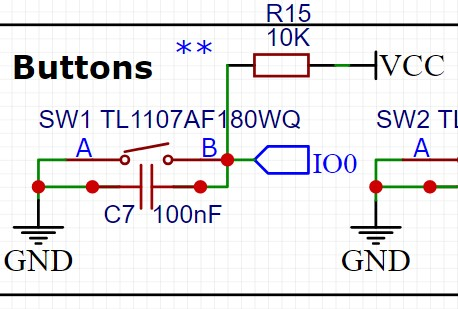
logs/boot button and ciruit.jpg
