enggsajjad/scooter/logs/GPS NMEA MSG.png

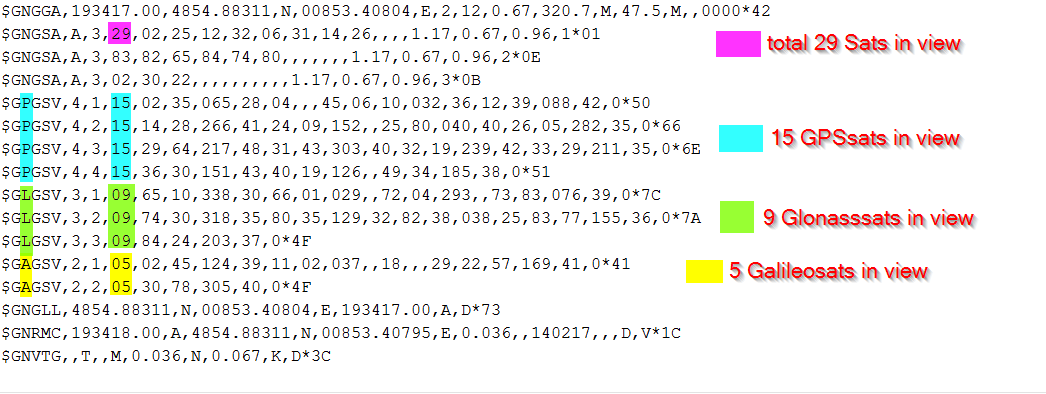
logs/GPS NMEA MSG.png
