enggsajjad/scooter/pcb/PCB5/BOM_escooter_sajjad - rev5_2022-02-26.csv

ID | Name | Designator | Footprint | Quantity | Available 26.02.2022
1 | 22uF | C1,C2,C4,C24 | C0805 | 4 | 14
2 | 0.1uF | C3,C6,C7 | C0805 | 3 | 41
3 | 4.7uF | C5 | C0805 | 1 | 7
4 | 10uF | C8 | C0805 | 1 | 3
5 | 100nF | C9,C10,C11,C21 | C0805 | 4 | 7
6 | 4700uF | C12 | CAP-TH_BD4.0-P1.50-D0.8-FD | 1 | 0
7 | 10uF | C13,C14,C15 | C0603 | 3 | 35
8 | 2.2uF | C16 | C0805 | 1 | 10
9 | 100uF | C17,C18 | CASE-C_6032 | 2 | 3
10 | 10uF | C19 | C1206 | 1 | 4
11 | 10uF | C22 | CAP-SMD_L3.2-W1.6-R-RD | 1
12 | 8.2pF | C23 | C0603 | 1 | 6
13 | MBR120VLSFT1G | D1 | SOD-123F_L2.8-W1.8-LS3.7-RD | 1 | 10
14 | LESD5D5.0CT1G | D2,D3,D4 | SOD-523_L1.2-W0.8-LS1.6-BI | 3 | 10
15 | U.FL-R-SMT(10) | GPRS,GPS | ANT-SMD_UFL-R-SMT | 2 | 12
16 | SDS | H1 | 1X04 2.54MM HOLES HEADERS PINS | 1
17 | VBAT | H2 | 1X02 2.54MM HOLES HEADERS PINS | 1
18 | VIN | H3 | 1X02 2.54MM HOLES HEADERS PINS | 1
19 | VOUT | H4 | 1X02 2.54MM HOLES HEADERS PINS | 1
20 | GPIO | J1 | M1X6 | 1
21 | RS232 | J2 | M1X4 | 1
22 | 7uH | L1 | IND-SMD_L10.2-W10.0 | 1 | 6
23 | 82nH | L2 | L0603 | 1 | 5
24 | 2.2uH | L3 | L0805 | 1 | 6
25 | PWR | LED1 | LED0805-RD | 1 | 10
26 | RGB1 | LED2 | LED-ARRAY-SMD_0603-4P-L1.6-W1.6-BL-RD111 | 1 | 9
27 | RGB2 | LED3 | LED-ARRAY-SMD_0603-4P-L1.6-W1.6-BL-RD111 | 1
28 | LBO | LED5 | LED0805-RD | 1
29 | VA9 | LED6 | LED0805-RD | 1
30 | Network | LED7 | LED0805-RD | 1
31 | GPS | LED8 | LED0805-RD | 1
32 | Mounting_Hole | MK1,MK2,MK3,MK4,MK5 | MOUNTINGHOLE_3.5MM | 5
33 | SS8050_C2150 | Q1,Q2 | SOT-23-3_L2.9-W1.3-P1.90-LS2.4-BR | 2 | 4
34 | MMUN2133LT1G | Q3 | SOT-23-3_L2.9-W1.6-P1.90-LS2.8-BR | 1 | 8
35 | 1K | R1,R2,R3,R4,R40,R41,R45,R46 | R0805 | 8 | 18
36 | 10K | R5,R6,R7,R8,R11,R39 | R0805 | 6 | 29
37 | 22.1K | R9 | R0805 | 1 | 2
38 | 2K | R10,R13 | R0805 | 2 | 3
39 | 47.5K | R12 | R0805 | 1 | 4
40 | 4.7K | R14,R15 | R0805 | 2 | 6
41 | 270k | R16 | R0603 | 1 | 1
42 | 100k | R17,R19 | R0603 | 2 | 4
43 | 2k | R18 | R0603 | 1 | 3
44 | 1k | R20,R22,R23,R24,R31 | R0603 | 5 | 0
45 | 10K | R21 | R0603 | 1 | 0
46 | 1.87M | R25,R27 | R0603 | 2 | 3
47 | 200k | R26,R30 | R0603 | 2 | 2
48 | 0R | R28,R49,R50,R51,R52,R53,R54,R56,R57 | R0603 | 9 | 44
49 | 340k | R29 | R0603 | 1 | 5
50 | 50R | R32,R33,R34,R35,R36,R37,R38,R42,R43,R44 | R0805 | 10 | 0
51 | 330K | R47 | R0805 | 1 | 6
52 | 56K | R48 | R0805 | 1
53 | 1M | R55 | R0603 | 1
54 | ∞k | RT1 | R_AXIAL-0.3 | 1
55 | 150k | RT2 | R0603 | 1 | 2
56 | SIM-002-A6 | SIM | MICRO-SIM-SMD_SIM-002-A6 | 1 | 3
57 | PWRKEY | SW1 | SW-TH_L6.0-W3.5-LS6.6 | 1 | 7
58 | BOOT | SW2 | SW-TH_L6.0-W3.5-LS6.6 | 1
59 | RST | SW3 | SW-TH_L6.0-W3.5-LS6.6 | 1
60 | LD1117S33TR | U1 | SOT-223_L6.5-W3.5-P2.30-LS7.0-BR | 1 | 2
61 | ESP-WROOM-32 | U2 | WIFIM-SMD_ESP-WROOM-32 | 1 | 12
62 | CP2102N-A01-GQFN28 | U3 | QFN-28_L5.0-W5.0-P0.50-BL-EP3.3 | 1
63 | BME680 | U4 | LGA-8_L3.0-W3.0-P0.80-TR | 1
64 | MCP73871-2AAI/ML | U5 | QFN-20_L4.0-W4.0-P0.50-BL-EP | 1 | 2
65 | TPS6103xRSAR | U6 | QFN-16_L4.0-W4.0-P0.65-TL-EP2.6 | 1 | 8
66 | A9G | U7 | A9G | 1 | 1
67 | SY8089AAAC | U8 | SOT-23-5_L3.0-W1.7-P0.95-LS2.8-BR | 1 | 3
68 | microUSB | USB | MICRO-USB-SMD_5P-P0.65-H-F_C10418 | 1 | 2
