enggsajjad/scooter/pcb/PCB5/remaing parts.xlsx

Available 26.02.2022 | Part | Address
0 | sds011 | https://www.alibaba.com/product-detail/Zhida-Shunfa-Laser-PM2-5-sensor_1600234899557.html?s=p
3 | sy8089 | https://lcsc.com/product-detail/DC-DC-Converters_Silergy-Corp-SY8089AAAC_C78988.html
1 | a9g | https://lcsc.com/product-detail/2G-3G-4G-5G-Modules_Ai-Thinker-A9G_C133738.html
2 | sim | https://lcsc.com/product-detail/Card-Sockets-Connectors_SOFNG-SIM-002-A6_C409615.html
12 | nmosfet | https://www.reichelt.de/de/de/mosfet-n-ch-60v-0-265a-0-31w-sot-23-bsn-20bk-nxp-p219199.html?PROVID=2788&r=1
8 | battery | https://eckstein-shop.de/LiPo-Akku-Lithium-Ion-Polymer-Batterie-37V-200-350-2000-2500mAh-JST-PH-Connector
1 | gps antenna | mouser
1 | gprs antenna | mouser
