enggsajjad/scooter/pcb/PCB2/BOM All.xlsx

https://www.mouser.de/ProjectManager/ProjectDetail.aspx?AccessID=cc19181bfe
https://lcsc.com/product-detail/Card-Sockets-Connectors_SOFNG-SIM-002-A6_C409615.html
https://lcsc.com/product-detail/2G-3G-4G-5G-Modules_Ai-Thinker-A9G_C133738.html
https://lcsc.com/product-detail/DC-DC-Converters_Silergy-Corp-SY8089AAAC_C78988.html
https://yima.en.alibaba.com/product/60390523700-222175283/SDS021_PM2_5_sensor_subsize_minisize_laser_dust_sensor_particle_sensor_for_pm10_or_pm2_5.html
