enggsajjad/scooter/pcb/PCB5/Basket_Feb26_1007PM.xls

SHOPPING BASKET
This is not an invoice
26-Feb-22 22:07:44
 | Mouser No | Mfr. No | Manufacturer | Customer No | Description | RoHS | Lifecycle | Order Qty. | Price (EUR) | Ext.: (EUR)
1 | 511-LD1117S33 | LD1117S33TR | STMicroelectronics |  | LDO Voltage Regulators 3.3V 0.8A Positive | RoHS Compliant By Exemption |  | 1 | 0,525 € | 0,53 €
2 | 634-CP2102NA02GQFN28 | CP2102N-A02-GQFN28 | Silicon Laboratories |  | USB Interface IC USBXpress - USB to UART Bridge QFN28 | RoHS Compliant |  | 1 | 1,99 € | 1,99 €
3 | 750-SS8050-G | SS8050-G | Comchip Technology |  | Bipolar Transistors - BJT NPN TRANSISTOR 1.5A 40V | RoHS Compliant |  | 1 | 0,271 € | 0,27 €
4 | 80-T489A106K10ATA2K2 | T489A106K010ATA2K2 | KEMET |  | Tantalum Capacitors - Solid SMD 10V 10uF 1206 10% | RoHS Compliant | New Product | 1 | 0,761 € | 0,76 €
5 | 667-ERA-6VEB1001V | ERA-6VEB1001V | Panasonic |  | Thin Film Resistors - SMD 0805 0.1% 1Kohm 25ppm SMD | RoHS Compliant | New Product | 1 | 0,726 € | 0,73 €
6 | 667-ERJ-6ENF4752V | ERJ-6ENF4752V | Panasonic |  | Thick Film Resistors - SMD 0805 47.5Kohms 1% AEC-Q200 | RoHS Compliant By Exemption |  | 1 | 0,096 € | 0,10 €
7 | 80-C0805C475K3RACTU | C0805C475K3RACTU | KEMET |  | Multilayer Ceramic Capacitors MLCC - SMD/SMT 25V 4.7uF X7R 0805 10% | RoHS Compliant |  | 1 | 0,525 € | 0,53 €
8 | 621-BAT760-7 | BAT760-7 | Diodes Incorporated |  | Schottky Diodes & Rectifiers 0.5A 30V LF | RoHS Compliant |  | 1 | 0,499 € | 0,50 €
9 | 80-C0805C829C1HAUTO | C0805C829C1HACAUTO | KEMET |  | Multilayer Ceramic Capacitors MLCC - SMD/SMT 100V 8.2pF X8R 0805 0.25pF AEC-Q200 | RoHS Compliant |  | 1 | 0,149 € | 0,15 €
10 | 262-BME680 | BME680 | Bosch |  | Air Quality Sensors MEMS gas, humidity, pressure and temperature sensor | RoHS Compliant |  | 1 | 10,25 € | 10,25 €
11 | 80-C0805X104M5RACTU | C0805X104M5RACTU | KEMET |  | Multilayer Ceramic Capacitors MLCC - SMD/SMT 50V 0.1uF X7R 0805 20% Flex Soft | RoHS Compliant | New Product | 1 | 0,42 € | 0,42 €
12 | 652-CVH201205-2R2M | CVH201205-2R2M | Bourns |  | Fixed Inductors Ind,2x1.25x.5mm,2.2uH20%,0.6A,Shd,SMD | RoHS Compliant |  | 1 | 0,254 € | 0,25 €
13 | 667-ERJ-P06F3303V | ERJ-P06F3303V | Panasonic |  | Thick Film Resistors - SMD 0805 330Kohms 0.5W 1% AEC-Q200 | RoHS Compliant By Exemption |  | 1 | 0,175 € | 0,18 €
14 | 612-TL1107 | TL1107AF180WQ | E-Switch |  | Tactile Switches 6.0X4.3MM 180G | RoHS Compliant |  | 1 | 0,333 € | 0,33 €
15 | 604-APTD2012LZGCK | APTD2012LZGCK | Kingbright |  | Standard LEDs - SMD 0805 Dome Lens LED Green- 525nm | RoHS Compliant |  | 1 | 0,595 € | 0,60 €
16 | 649-10118194-0011LF | 10118194-0011LF | FCI / Amphenol |  | USB Connectors MICRO USD B-TYPE | RoHS Compliant |  | 1 | 0,464 € | 0,46 €
17 | 667-ERA-6ARB2212V | ERA-6ARB2212V | Panasonic |  | Thin Film Resistors - SMD 0805 Thin film chip resistor | RoHS Compliant By Exemption |  | 1 | 1,10 € | 1,10 €
18 | 667-ERJ-3EKF3403V | ERJ-3EKF3403V | Panasonic |  | Thick Film Resistors - SMD 0603 340Kohms 1% AEC-Q200 | RoHS Compliant By Exemption |  | 1 | 0,088 € | 0,09 €
19 | 667-ERJ-UP3F1503V | ERJ-UP3F1503V | Panasonic |  | Thick Film Resistors - SMD 0603 Anti-sulfurated anti-surge resistor | RoHS Compliant | New Product | 1 | 0,219 € | 0,22 €
20 | 667-ERA-3VEB1001V | ERA-3VEB1001V | Panasonic |  | Thin Film Resistors - SMD 0603 0.1% 1Kohm 25ppm SMD | RoHS Compliant | New Product | 1 | 0,508 € | 0,51 €
21 | 538-206640-0001 | 206640-0001 | Molex |  | Antennas GNSS Activ Patch Ant Low-Noise Amplifier | RoHS Compliant |  | 1 | 7,71 € | 7,71 €
22 | 712-ANT-LPC-FPC-100 | ANT-LPC-FPC-100 | Linx Technologies |  | Antennas Cellular Multiband Dipole Flexible Patch, U.FL-type Plug | RoHS Compliant |  | 1 | 3,93 € | 3,93 €
23 | 581-F381E225MMA | F381E225MMA | Kyocera AVX |  | Tantalum Capacitors - Polymer 25V 2.2uF 20% 0603 ESR=500mOhms | RoHS Compliant | New Product | 1 | 4,23 € | 4,23 €
24 | 667-ERJ-UP3F2003V | ERJ-UP3F2003V | Panasonic |  | Thick Film Resistors - SMD 0603 Anti-sulfurated anti-surge resistor | RoHS Compliant By Exemption | New Product | 1 | 0,21 € | 0,21 €
25 | 71-CRCW08050000Z0EAC | CRCW08050000Z0EAC | Vishay |  | Thick Film Resistors - SMD 1/8Watt 0ohms Commercial Use | RoHS Compliant By Exemption |  | 1 | 0,088 € | 0,09 €
26 | 356-ES32WROOM32D16MB | ESP32-WROOM-32D-N16 | Espressif |  | WiFi Modules - 802.11 SMD Module, ESP32-D0WD, 128Mbits SPI flash, UART mode, PCB antenna |  | NRND | 1 | 4,00 € | 4,00 €
27 | 74-TM8R106K010UBA | TM8R106K010UBA | Vishay |  | Tantalum Capacitors - Solid SMD 10uF 10volts 10% R case MAP Hi-Rel | RoHS Compliant |  | 1 | 10,06 € | 10,06 €
28 | 581-TPSC107K010T0200 | TPSC107K010T0200 | Kyocera AVX |  | Tantalum Capacitors - Solid SMD 10V 100uF 10% 2312 ESR=.7Ohm AEC-Q200 | RoHS Compliant |  | 1 | 0,831 € | 0,83 €
29 | 771-BAS70H-T/R | BAS70H,115 | Nexperia |  | Schottky Diodes & Rectifiers DIODE SCHOTTKY TAPE-7 | RoHS Compliant |  | 1 | 0,28 € | 0,28 €
30 | 749-SM0605TCRGB | SM0605RGB | BIVAR |  | Standard LEDs - SMD SMDTri-Color 0605LED RGB 630,523,468nm | RoHS Compliant |  | 1 | 1,13 € | 1,13 €
31 | 863-MMUN2133LT1G | MMUN2133LT1G | onsemi |  | Bipolar Transistors - Pre-Biased 100mA 50V BRT PNP | RoHS Compliant |  | 1 | 0,131 € | 0,13 €
32 | 71-TNPU08052K00AWEN | TNPU08052K00AWEN00 | Vishay |  | Thin Film Resistors - SMD 1/8watt 2Kohms 0.05% 2ppm | RoHS Compliant | New At Mouser | 1 | 4,17 € | 4,17 €
33 | 71-CRCW0603270KFKEAC | CRCW0603270KFKEAC | Vishay |  | Thick Film Resistors - SMD 1/10Watt 270Kohms 1% Commercial Use | RoHS Compliant By Exemption |  | 1 | 0,14 € | 0,14 €
34 | 603-RC0603FR-071M87L | RC0603FR-071M87L | YAGEO |  | Thick Film Resistors - SMD 1.87 MOhms 100 mW 0603 1% | RoHS Compliant By Exemption |  | 1 | 0,088 € | 0,09 €
35 | 579-MCP73871-2AAI/ML | MCP73871-2AAI/ML | Microchip |  | Battery Management USB/AC Battery Charger | RoHS Compliant |  | 1 | 1,93 € | 1,93 €
36 | 595-TPS61032RSAR | TPS61032RSAR | Texas Instruments |  | Switching Voltage Regulators 5-V Output 1-A Boost Converter | RoHS Compliant |  | 1 | 2,74 € | 2,74 €
37 | 667-ERJ-UP3F1003V | ERJ-UP3F1003V | Panasonic |  | Thick Film Resistors - SMD 0603 Anti-sulfurated anti-surge resistor | RoHS Compliant By Exemption | New Product | 1 | 0,228 € | 0,23 €
38 | 667-ERJ-UP3F2001V | ERJ-UP3F2001V | Panasonic |  | Thick Film Resistors - SMD 0603 0.25W 1% 2Kohm AEC-Q200 | RoHS Compliant By Exemption | New Product | 1 | 0,228 € | 0,23 €
39 | 798-U.FL-R-SMT10 | U.FL-R-SMT(10) | Hirose Electric |  | RF Connectors / Coaxial Connectors U.FL RECEPTACLE SMT GLD M CONT REEL | RoHS Compliant |  | 1 | 1,10 € | 1,10 €
40 | 667-ERA-6VEB4701V | ERA-6VEB4701V | Panasonic |  | Thin Film Resistors - SMD 0805 0.1% 4.7Kohm 25ppm SMD | RoHS Compliant | New Product | 1 | 0,613 € | 0,61 €
41 | 187-CL21A226MAYNNNE | CL21A226MAYNNNE | Samsung Electro-Mechanics |  | Multilayer Ceramic Capacitors MLCC - SMD/SMT 22uF+/-20% 25V X5R 2012 | RoHS Compliant | New At Mouser | 1 | 0,298 € | 0,30 €
42 | 755-RSB6.8SMFHT2N | RSB6.8SMFHT2N | ROHM Semiconductor |  | Zener Diodes 5.78-7.82V 1mA SOD-523; EMD2 | RoHS Compliant | NRND | 1 | 0,376 € | 0,38 €
43 | 667-ERA-6VEB1002V | ERA-6VEB1002V | Panasonic |  | Thin Film Resistors - SMD 0805 0.1% 10Kohm 25ppm SMD | RoHS Compliant | New Product | 1 | 0,674 € | 0,67 €
44 | 71-CRCW0805-50 | CRCW080550R0FKTA | Vishay |  | Thick Film Resistors - SMD 1/8watt 50ohms 1% Non Std Qt Req'd | No |  | 1 | 0,578 € | 0,58 €
45 | 815-AIML-0603-82NKT | AIML-0603-82NK-T | ABRACON |  | Fixed Inductors FIXED IND 82NH 50MA 300 MOHM SMD | RoHS Compliant By Exemption |  | 1 | 0,149 € | 0,15 €
46 | 603-RC0805FR-1356KL | RC0805FR-1356KL | YAGEO |  | Thick Film Resistors - SMD 56 kOhms 250 mW 0805 1% | RoHS Compliant By Exemption |  | 1 | 0,114 € | 0,11 €
47 | 791-MR06X1004FTL | MR06X1004FTL | Walsin |  | Thick Film Resistors - SMD 0603 1M00 1% Lead Free | RoHS Compliant | New Product | 1 | 0,108 € | 0,11 €
48 | 667-ERJ-H3ED1002V | ERJ-H3ED1002V | Panasonic |  | Thick Film Resistors - SMD 0603 10KOhm 0.5% AEC-Q200 | RoHS Compliant | New At Mouser | 1 | 0,263 € | 0,26 €
49 | 755-TCSM1C106M8R | TCSM1C106M8R | ROHM Semiconductor |  | Tantalum Capacitors - Solid SMD Tantalum Capacitors (Bottom surface electrode : Extra large capacitance type), Case=M, Size=1608, Height=0.8+0.2/-0.0mm, Capacitance (IEC code) =10(106)uF, Rated voltage=16V, Impedance=6?, ESR=6000m?, Series=TCS | RoHS Compliant | New Product | 1 | 0,84 € | 0,84 €
50 | 851-CDRH104RNP-7R0NC | CDRH104RNP-7R0NC | Sumida |  | Fixed Inductors 7uH 4.5A | RoHS Compliant |  | 1 | 1,64 € | 1,64 €
By submitting your order you agree to these terms and conditions. (https://www.mouser.de/saleterms) |  |  |  |  |  |  |  |  | Merchandise: | 68,85 €
Prices are reflected at the date and time shown. |  |  |  |  |  |  |  |  | Delivery Charge: | 0,00 €
 |  |  |  |  |  |  |  |  | Back-order Delivery: | 0,00 €
