enggsajjad/scooter/pcb/PCB0/PCBV1 Basket20.10.2020 020312.xls

PCBV1 BASKET:20.10.2020 02:03:12
Mouser No | Mfr. No | Manufacturer | Customer No | Description | RoHS | Lifecycle | Order Qty. | Price (EUR) | Ext.: (EUR)
511-LD1117S33 | LD1117S33TR | STMicroelectronics |  | LDO Voltage Regulators 3.3V 0.8A Positive | RoHS Compliant By Exemption |  | 1 | 0,481 € | 0,48 €
603-CC805KRX7R9BB104 | CC0805KRX7R9BB104 | YAGEO |  | Multilayer Ceramic Capacitors MLCC - SMD/SMT 50V 0.1uF X7R 0805 10% | RoHS Compliant |  | 2 | 0,105 € | 0,21 €
755-RSB6.8SMFHT2N | RSB6.8SMFHT2N | ROHM Semiconductor |  | Zener Diodes 5.78-7.82V 1mA SOD-523; EMD2 | RoHS Compliant | NRND | 3 | 0,376 € | 1,13 €
187-CL21A226MAQNNNE | CL21A226MAQNNNE | Samsung Electro-Mechanics |  | Multilayer Ceramic Capacitors MLCC - SMD/SMT 22uF+/-20% 25V X5R 2012 | RoHS Compliant | New At Mouser | 4 | 0,289 € | 1,16 €
667-ERA-6VEB4701V | ERA-6VEB4701V | Panasonic |  | Thin Film Resistors - SMD 0805 0.1% 4.7Kohm 25ppm SMD | RoHS Compliant | New Product | 2 | 0,613 € | 1,23 €
667-ERA-6VEB1002V | ERA-6VEB1002V | Panasonic |  | Thin Film Resistors - SMD 0805 0.1% 10Kohm 25ppm SMD | RoHS Compliant | New Product | 4 | 0,613 € | 2,45 €
667-ERA-6ARB2212V | ERA-6ARB2212V | Panasonic |  | Thin Film Resistors - SMD 0805 Thin film chip resistor | RoHS Compliant By Exemption |  | 1 | 1,10 € | 1,10 €
652-CHP0805AFX-5600L | CHP0805AFX-5600ELF | Bourns |  | Thick Film Resistors - SMD ResHighPowerA 0805 560R 1% 1/2W TC100 AEC-Q200 | RoHS Compliant | New Product | 1 | 0,569 € | 0,57 €
815-AIML-0603-82NKT | AIML-0603-82NK-T | ABRACON |  | Fixed Inductors FIXED IND 82NH 50MA 300 MOHM SMD | RoHS Compliant By Exemption |  | 1 | 0,149 € | 0,15 €
649-10118194-0011LF | 10118194-0011LF | FCI / Amphenol |  | USB Connectors MICRO USD B-TYPE | RoHS Compliant |  | 1 | 0,464 € | 0,46 €
604-APTD2012LZGCK | APTD2012LZGCK | Kingbright |  | Standard LEDs - SMD 0805 Dome Lens LED Green- 525nm | RoHS Compliant |  | 1 | 0,586 € | 0,59 €
756-WCR0805-2K7FI | WCR0805-2K7FI | TT Electronics |  | Thick Film Resistors - SMD 2.7K ohm 1% 150V General Purpose SMT | RoHS Compliant By Exemption |  | 1 | 0,088 € | 0,09 €
652-CR0805FX-56R0ELF | CR0805-FX-56R0ELF | Bourns |  | Thick Film Resistors - SMD 56ohm 1% | RoHS Compliant |  | 1 | 0,088 € | 0,09 €
612-TL1107 | TL1107AF180WQ | E-Switch |  | Tactile Switches 6.0X4.3MM 180G | RoHS Compliant |  | 3 | 0,263 € | 0,79 €
667-ERJ-P06F3303V | ERJ-P06F3303V | Panasonic |  | Thick Film Resistors - SMD 0805 330Kohms 0.5W 1% AEC-Q200 | RoHS Compliant By Exemption |  | 1 | 0,175 € | 0,18 €
652-CVH201205-2R2M | CVH201205-2R2M | Bourns |  | Fixed Inductors Ind,2x1.25x.5mm,2.2uH20%,0.6A,Shd,SMD | RoHS Compliant |  | 1 | 0,254 € | 0,25 €
80-C0805X104M5RACTU | C0805X104M5RACTU | KEMET |  | Multilayer Ceramic Capacitors MLCC - SMD/SMT 50V 0.1uF X7R 0805 20% Flex Soft | RoHS Compliant | New Product | 3 | 0,455 € | 1,37 €
262-BME680 | BME680 | Bosch |  | Air Quality Sensors MEMS gas, humidity, pressure and temperature sensor | RoHS Compliant |  | 1 | 10,91 € | 10,91 €
80-C0805C829C1HAUTO | C0805C829C1HACAUTO | KEMET |  | Multilayer Ceramic Capacitors MLCC - SMD/SMT 100V 8.2pF X8R 0805 0.25pF AEC-Q200 | RoHS Compliant |  | 1 | 0,149 € | 0,15 €
621-BAT760-7 | BAT760-7 | Diodes Incorporated |  | Schottky Diodes & Rectifiers 0.5A 30V LF | RoHS Compliant |  | 1 | 0,499 € | 0,50 €
80-C0805C475K3RACTU | C0805C475K3RACTU | KEMET |  | Multilayer Ceramic Capacitors MLCC - SMD/SMT 25V 4.7uF X7R 0805 10% | RoHS Compliant |  | 1 | 0,525 € | 0,53 €
750-SS8050-G | SS8050-G | Comchip Technology |  | Bipolar Transistors - BJT NPN TRANSISTOR 1.5A 40V | RoHS Compliant |  | 2 | 0,228 € | 0,46 €
571-171825-5 | 171825-5 | TE Connectivity |  | Headers & Wire Housings 5 POS EIS POST HDR | RoHS Compliant |  | 1 | 0,324 € | 0,32 €
667-ERJ-6ENF4752V | ERJ-6ENF4752V | Panasonic |  | Thick Film Resistors - SMD 0805 47.5Kohms 1% AEC-Q200 | RoHS Compliant By Exemption |  | 1 | 0,096 € | 0,10 €
667-ERJ-B3BFR51V | ERJ-B3BFR51V | Panasonic |  | Current Sense Resistors - SMD 0508 0.51ohms 1% Tol AEC-Q200 | RoHS Compliant By Exemption |  | 3 | 0,674 € | 2,02 €
667-ERA-6VEB1001V | ERA-6VEB1001V | Panasonic |  | Thin Film Resistors - SMD 0805 0.1% 1Kohm 25ppm SMD | RoHS Compliant | New Product | 1 | 0,595 € | 0,60 €
80-T489A106K10ATA2K2 | T489A106K010ATA2K2 | KEMET |  | Tantalum Capacitors - Solid SMD 10V 10uF 1206 10% | RoHS Compliant | New Product | 1 | 0,761 € | 0,76 €
71-CRCW08056K20FKEAC | CRCW08056K20FKEAC | Vishay |  | Thick Film Resistors - SMD 1/8Watt 6.2Kohms 1% Commercial Use | RoHS Compliant By Exemption |  | 1 | 0,14 € | 0,14 €
634-CP2102NA02GQFN28 | CP2102N-A02-GQFN28 | Silicon Laboratories |  | USB Interface IC USBXpress - USB to UART Bridge QFN28 | RoHS Compliant |  | 1 | 1,70 € | 1,70 €
490-UJ2-MIBH-4-MSMT | UJ2-MIBH-4-MSMT-TR | CUI Devices |  | USB Connectors USB 2.0 micro B jack 5 pin HZ mid-mnt SM | RoHS Compliant |  | 1 | 0,919 € | 0,92 €
