enggsajjad/scooter/pcb/PCB1/Basket_Mar13_1251PM.xls

SHOPPING BASKET
This is not an invoice
13-Mar-21 12:51:16
 | Mouser No | Mfr. No | Manufacturer | Customer No | Description | RoHS | Lifecycle | Order Qty. | Price (EUR) | Ext.: (EUR)
1 | 875-TYS50406R8M-10 | TYS50406R8M-10 | Laird Performance Materials |  | Fixed Inductors 6.8uH 20% -40C +125C | RoHS Compliant |  | 1 | 0,203 € | 0,20 €
2 | 798-U.FL-R-SMT10 | U.FL-R-SMT(10) | Hirose Electric |  | RF Connectors / Coaxial Connectors U.FL RECEPTACLE SMT GLD M CONT REEL | RoHS Compliant |  | 2 | 1,07 € | 2,14 €
3 | 511-LD1117S33 | LD1117S33TR | STMicroelectronics |  | LDO Voltage Regulators 3.3V 0.8A Positive | RoHS Compliant |  | 1 | 0,483 € | 0,48 €
4 | 603-CC805KRX7R9BB104 | CC0805KRX7R9BB104 | Yageo |  | Multilayer Ceramic Capacitors MLCC - SMD/SMT 100nF 50V X7R 10% | RoHS Compliant |  | 7 | 0,102 € | 0,71 €
5 | 80-C603C104K5RAC3121 | C0603C104K5RAC3121 | KEMET |  | Multilayer Ceramic Capacitors MLCC - SMD/SMT 50V .1uF X7R 0603 10% AEC-Q200 | RoHS Compliant | New Product | 1 | 0,237 € | 0,24 €
6 | 187-CL21A226MAQNNNE | CL21A226MAQNNNE | Samsung Electro-Mechanics |  | Multilayer Ceramic Capacitors MLCC - SMD/SMT 22uF+/-20% 25V X5R 2012 | RoHS Compliant | New At Mouser | 4 | 0,254 € | 1,02 €
7 | 667-ERA-6VEB4701V | ERA-6VEB4701V | Panasonic |  | Thin Film Resistors - SMD 0805 0.1% 4.7Kohm 25ppm SMD | RoHS Compliant | New Product | 2 | 0,593 € | 1,19 €
8 | 667-ERA-6VEB1002V | ERA-6VEB1002V | Panasonic |  | Thin Film Resistors - SMD 0805 0.1% 10Kohm 25ppm SMD | RoHS Compliant | New Product | 6 | 0,593 € | 3,56 €
9 | 667-ERA-6ARB2212V | ERA-6ARB2212V | Panasonic |  | Thin Film Resistors - SMD 0805 Thin film chip resistor | RoHS Compliant |  | 1 | 1,07 € | 1,07 €
10 | 815-AIML-0603-82NKT | AIML-0603-82NK-T | ABRACON |  | Fixed Inductors FIXED IND 82NH 50MA 300 MOHM SMD | RoHS Compliant By Exemption |  | 1 | 0,085 € | 0,09 €
11 | 604-APTD2012LZGCK | APTD2012LZGCK | Kingbright |  | Standard LEDs - SMD 0805 Dome Lens LED Green- 525nm | RoHS Compliant |  | 5 | 0,559 € | 2,80 €
12 | 71-CRCW080549R9FKEAC | CRCW080549R9FKEAC | Vishay |  | Thick Film Resistors - SMD 1/8Watt 49.9ohms 1% Commercial Use | RoHS Compliant By Exemption |  | 10 | 0,05 € | 0,50 €
13 | 71-CRCW08050000Z0EAC | CRCW08050000Z0EAC | Vishay |  | Thick Film Resistors - SMD 1/8Watt 0ohms Commercial Use | RoHS Compliant By Exemption |  | 5 | 0,085 € | 0,43 €
14 | 612-TL1107 | TL1107AF180WQ | E-Switch |  | Tactile Switches 6.0X4.3MM 180G | RoHS Compliant |  | 3 | 0,237 € | 0,71 €
15 | 667-ERJ-P06F3303V | ERJ-P06F3303V | Panasonic |  | Thick Film Resistors - SMD 0805 330Kohms 0.5W 1% AEC-Q200 | RoHS Compliant By Exemption |  | 1 | 0,144 € | 0,14 €
16 | 356-ES32WROOM32D16MB | ESP32-WROOM-32D(M113DH2800PH3Q0) | Espressif |  | WiFi Modules (802.11) SMD Module, ESP32-D0WD, 128Mbits SPI flash, UART mode, PCB antenna |  |  | 1 | 3,81 € | 3,81 €
17 | 652-CVH201205-2R2M | CVH201205-2R2M | Bourns |  | Fixed Inductors Ind,2x1.25x.5mm,2.2uH 20%,0.6A,Shd,SMD | RoHS Compliant | New Product | 1 | 0,136 € | 0,14 €
18 | 80-C0805C829C1HAUTO | C0805C829C1HACAUTO | KEMET |  | Multilayer Ceramic Capacitors MLCC - SMD/SMT 100V 8.2pF X8R 0805 0.25pF AEC-Q200 | RoHS Compliant |  | 1 | 0,144 € | 0,14 €
19 | 621-BAT760-7 | BAT760-7 | Diodes Incorporated |  | Schottky Diodes & Rectifiers 0.5A 30V LF | RoHS Compliant |  | 3 | 0,44 € | 1,32 €
20 | 80-C0805C475K3RACTU | C0805C475K3RACTU | KEMET |  | Multilayer Ceramic Capacitors MLCC - SMD/SMT 25V 4.7uF X7R 0805 10% | RoHS Compliant | New Product | 2 | 0,508 € | 1,02 €
21 | 750-SS8050-G | SS8050-G | Comchip Technology |  | Bipolar Transistors - BJT NPN TRANSISTOR 1.5A 40V | RoHS Compliant |  | 2 | 0,195 € | 0,39 €
22 | 667-ERJ-6ENF4752V | ERJ-6ENF4752V | Panasonic |  | Thick Film Resistors - SMD 0805 47.5Kohms 1% AEC-Q200 | RoHS Compliant By Exemption |  | 1 | 0,085 € | 0,09 €
23 | 667-ERA-6VEB1001V | ERA-6VEB1001V | Panasonic |  | Thin Film Resistors - SMD 0805 0.1% 1Kohm 25ppm SMD | RoHS Compliant | New Product | 6 | 0,593 € | 3,56 €
24 | 667-ERA-1AEB102C | ERA-1AEB102C | Panasonic |  | Thin Film Resistors - SMD 0201 1Kohm 0.1% 25ppm | RoHS Compliant |  | 5 | 0,364 € | 1,82 €
25 | 80-T489A106K10ATA2K2 | T489A106K010ATA2K2 | KEMET |  | Tantalum Capacitors - Solid SMD 10V 10uF 1206 10% | RoHS Compliant | New Product | 1 | 0,949 € | 0,95 €
26 | 74-TM8R106K010UBA | TM8R106K010UBA | Vishay |  | Tantalum Capacitors - Solid SMD 10uF 10volts 10% R case MAP Hi-Rel | RoHS Compliant |  | 1 | 8,02 € | 8,02 €
27 | 74-298D106X9010M2T | 298D106X9010M2T | Vishay |  | Tantalum Capacitors - Solid SMD 10uF 10volts 10% M case MAP | RoHS Compliant |  | 4 | 1,05 € | 4,20 €
28 | 634-CP2102NA02GQFN28 | CP2102N-A02-GQFN28 | Silicon Laboratories |  | USB Interface IC USBXpress - USB to UART Bridge QFN28 | RoHS Compliant | New Product | 1 | 1,19 € | 1,19 €
29 | 649-10118194-0011LF | 10118194-0011LF | FCI / Amphenol |  | USB Connectors MICRO USD B-TYPE | RoHS Compliant |  | 1 | 0,407 € | 0,41 €
30 | 598-381LL472M063A032 | 381LL472M063A032 | Cornell Dubilier |  | Aluminium Electrolytic Capacitors - Snap In 4700uF 63V 20% 8K hours | RoHS Compliant | New Product | 1 | 9,49 € | 9,49 €
31 | 80-ESK478M050AQ3AA | ESK478M050AQ3AA | KEMET |  | Aluminium Electrolytic Capacitors - Radial Leaded 50V 4700uF 85C 2k Hour Radial | RoHS Compliant |  | 1 | 2,80 € | 2,80 €
32 | 581-F381E225MMA | F381E225MMA | AVX |  | Tantalum Capacitors - Polymer 25V 2.2uF 20% 0603 ESR=500mOhms | RoHS Compliant | New Product | 1 | 3,62 € | 3,62 €
33 | 581-TPSC107K010T0200 | TPSC107K010T0200 | AVX |  | Tantalum Capacitors - Solid SMD 10V 100uF 10% 2312 ESR=.7Ohm AEC-Q200 | RoHS Compliant |  | 2 | 0,517 € | 1,03 €
34 | 771-BAS70H-T/R | BAS70H,115 | Nexperia |  | Schottky Diodes & Rectifiers DIODE SCHOTTKY TAPE-7 | RoHS Compliant |  | 2 | 0,212 € | 0,42 €
35 | 80-L0805C2R2MPWST | L0805C2R2MPWST | KEMET |  | Fixed Inductors 0805 2.2uH 20% 240mA | RoHS Compliant |  | 1 | 0,22 € | 0,22 €
36 | 749-SM0605TCRGB | SM0605RGB | BIVAR |  | Standard LEDs - SMD SMDTri-Color 0605LED RGB 630,523,468nm | RoHS Compliant |  | 2 | 1,06 € | 2,12 €
37 | 863-MMUN2133LT1G | MMUN2133LT1G | ON Semiconductor |  | Bipolar Transistors - Pre-Biased 100mA 50V BRT PNP | RoHS Compliant |  | 1 | 0,102 € | 0,10 €
38 | 71-TNPU08052K00AWEN | TNPU08052K00AWEN00 | Vishay |  | Thin Film Resistors - SMD 1/8watt 2Kohms 0.05% 2ppm |  | New Product | 2 | 4,57 € | 9,14 €
39 | 71-CRCW0805-47.5K | CRCW080547K5FKTA | Vishay |  | Thick Film Resistors - SMD 1/8watt 47.5Kohms 1% 100ppm | No |  | 1 | 0,119 € | 0,12 €
40 | 71-CRCW0603270KFKEAC | CRCW0603270KFKEAC | Vishay |  | Thick Film Resistors - SMD 1/10Watt 270Kohms 1% Commercial Use | RoHS Compliant By Exemption |  | 1 | 0,136 € | 0,14 €
41 | 71-CRCW0201100KFKED | CRCW0201100KFKED | Vishay |  | Thick Film Resistors - SMD 1/20watt 100Kohms 1% 100ppm | RoHS Compliant By Exemption |  | 2 | 0,237 € | 0,47 €
42 | 667-ERA-1AEB202C | ERA-1AEB202C | Panasonic |  | Thin Film Resistors - SMD 0201 2Kohm 0.1% 25ppm | RoHS Compliant |  | 1 | 0,381 € | 0,38 €
43 | 603-RC0603FR-071M87L | RC0603FR-071M87L | Yageo |  | Thick Film Resistors - SMD 1.87M OHM 1% | RoHS Compliant By Exemption |  | 2 | 0,085 € | 0,17 €
44 | 603-RE0201BRE07200KL | RE0201BRE07200KL | Yageo |  | Thick Film Resistors - SMD 200kOhms 50PPM 50mW 0603 0.1% | RoHS Compliant By Exemption |  | 2 | 0,483 € | 0,97 €
45 | 603-RC0201FR-07340KL | RC0201FR-07340KL | Yageo |  | Thick Film Resistors - SMD 340K OHM 1% | RoHS Compliant By Exemption |  | 1 | 0,102 € | 0,10 €
46 | 71-RCS080556K0FKEA | RCS080556K0FKEA | Vishay |  | Thick Film Resistors - SMD 0.4watt 56Kohms 1% 100ppm | RoHS Compliant By Exemption | New Product | 1 | 0,212 € | 0,21 €
47 | 579-MCP73871-2AAI/ML | MCP73871-2AAI/ML | Microchip |  | Battery Management USB/AC Battery Charger | RoHS Compliant |  | 1 | 1,59 € | 1,59 €
48 | 595-TPS61030RSAR | TPS61030RSAR | Texas Instruments |  | Switching Voltage Regulators 1Adj 1-A 96% Eff Boost Converter | RoHS Compliant |  | 1 | 2,41 € | 2,41 €
49 | 667-ERJ-1GNF1503C | ERJ-1GNF1503C | Panasonic |  | Thick Film Resistors - SMD 0201 150Kohm 1% HalogenFree AEC-Q200 | RoHS Compliant By Exemption |  | 1 | 0,085 € | 0,09 €
50 | 603-RE0201BRE0710KL | RE0201BRE0710KL | Yageo |  | Thick Film Resistors - SMD 10K ohm 0.1% 50 ppm Thick Film-Precision | RoHS Compliant By Exemption |  | 1 | 0,483 € | 0,48 €
By submitting your order you agree to these terms and conditions. (https://www.mouser.de/saleterms) |  |  |  |  |  |  |  |  | Merchandise: | 78,41 €
Prices are reflected at the date and time shown. |  |  |  |  |  |  |  |  | Delivery Charge: | 0,00 €
 |  |  |  |  |  |  |  |  | Back-order Delivery: | 0,00 €
