enggsajjad/scooter/pcb/PCB2/LCSC_Exported_20210524_083139.xlsx

LCSC Part Number | Manufacture Part Number | Manufacturer | Package | Customer # | Description | RoHS | Order Qty. | Min\Mult Order Qty. | Unit Price | Order Price | Product Link
C409615 | SIM-002-A6 | SOFNG | SMD |  | SMD Card Sockets Connectors RoHS | yes | 1 | 1 | 0.5897 | 0.59 | lcsc.com/product-detail/Card-Sockets-Connectors_SOFNG-SIM-002-A6_C409615.html
C78988 | SY8089AAAC | Silergy Corp | SOT-23-5 |  | 5.5V 2A SOT-23-5 DC-DC Converters RoHS | yes | 5 | 5 | 0.1478 | 0.74 | lcsc.com/product-detail/DC-DC-Converters_Silergy-Corp-SY8089AAAC_C78988.html
C133738 | A9G | Ai-Thinker | Module |  | Module 2G/3G/4G/5G Modules RoHS | yes | 1 | 1 | 8.2969 | 8.3 | lcsc.com/product-detail/2G-3G-4G-5G-Modules_Ai-Thinker-A9G_C133738.html
