enggsajjad/scooter/pcb/PCB3/PCBV3_Basket532021 125923.xls

PCBV3_BASKET:5/3/2021 12:59:23
Mouser No | Mfr. No | Manufacturer | Customer No | Description | RoHS | Lifecycle | Order Qty. | Price (EUR) | Ext.: (EUR)
511-LD1117S33 | LD1117S33TR | STMicroelectronics |  | LDO Voltage Regulators 3.3V 0.8A Positive | RoHS Compliant By Exemption |  | 1 | 0,481 € | 0,48 €
634-CP2102NA02GQFN28 | CP2102N-A02-GQFN28 | Silicon Laboratories |  | USB Interface IC USBXpress - USB to UART Bridge QFN28 | RoHS Compliant |  | 1 | 1,70 € | 1,70 €
750-SS8050-G | SS8050-G | Comchip Technology |  | Bipolar Transistors - BJT NPN TRANSISTOR 1.5A 40V | RoHS Compliant |  | 2 | 0,228 € | 0,46 €
80-T489A106K10ATA2K2 | T489A106K010ATA2K2 | KEMET |  | Tantalum Capacitors - Solid SMD 10V 10uF 1206 10% | RoHS Compliant | New Product | 2 | 0,761 € | 1,52 €
667-ERA-6VEB1001V | ERA-6VEB1001V | Panasonic |  | Thin Film Resistors - SMD 0805 0.1% 1Kohm 25ppm SMD | RoHS Compliant | New Product | 8 | 0,595 € | 4,76 €
667-ERJ-6ENF4752V | ERJ-6ENF4752V | Panasonic |  | Thick Film Resistors - SMD 0805 47.5Kohms 1% AEC-Q200 | RoHS Compliant By Exemption |  | 1 | 0,096 € | 0,10 €
200-TLW10201GSRA | TLW-102-01-G-S-RA | Samtec |  | Headers & Wire Housings .100 Low Profile Terminal Strip | RoHS Compliant |  | 3 | 0,665 € | 2,00 €
200-HTSW10605FS | HTSW-106-05-F-S | Samtec |  | Headers & Wire Housings High Temperature PCB Header Strips, 0.100 pitch | RoHS Compliant |  | 1 | 0,744 € | 0,74 €
200-TSW10224TD | TSW-102-24-T-D | Samtec |  | Headers & Wire Housings Classic PCB Header Strips, 0.100 pitch | RoHS Compliant |  | 2 | 0,368 € | 0,74 €
80-C0805C475K3RACTU | C0805C475K3RACTU | KEMET |  | Multilayer Ceramic Capacitors MLCC - SMD/SMT 25V 4.7uF X7R 0805 10% | RoHS Compliant |  | 1 | 0,525 € | 0,53 €
621-BAT760-7 | BAT760-7 | Diodes Incorporated |  | Schottky Diodes & Rectifiers 0.5A 30V LF | RoHS Compliant |  | 5 | 0,499 € | 2,50 €
80-C0805C829C1HAUTO | C0805C829C1HACAUTO | KEMET |  | Multilayer Ceramic Capacitors MLCC - SMD/SMT 100V 8.2pF X8R 0805 0.25pF AEC-Q200 | RoHS Compliant |  | 1 | 0,149 € | 0,15 €
262-BME680 | BME680 | Bosch |  | Air Quality Sensors MEMS gas, humidity, pressure and temperature sensor | RoHS Compliant |  | 1 | 10,91 € | 10,91 €
80-C0805X104M5RACTU | C0805X104M5RACTU | KEMET |  | Multilayer Ceramic Capacitors MLCC - SMD/SMT 50V 0.1uF X7R 0805 20% Flex Soft | RoHS Compliant | New Product | 7 | 0,455 € | 3,19 €
652-CVH201205-2R2M | CVH201205-2R2M | Bourns |  | Fixed Inductors Ind,2x1.25x.5mm,2.2uH20%,0.6A,Shd,SMD | RoHS Compliant |  | 1 | 0,254 € | 0,25 €
667-ERJ-P06F3303V | ERJ-P06F3303V | Panasonic |  | Thick Film Resistors - SMD 0805 330Kohms 0.5W 1% AEC-Q200 | RoHS Compliant By Exemption |  | 1 | 0,175 € | 0,18 €
612-TL1107 | TL1107AF180WQ | E-Switch |  | Tactile Switches 6.0X4.3MM 180G | RoHS Compliant |  | 3 | 0,263 € | 0,79 €
187-CL10B104JB8NNNC | CL10B104JB8NNNC | Samsung Electro-Mechanics |  | Multilayer Ceramic Capacitors MLCC - SMD/SMT 100nF+/-5% 50V X7R 1608 | RoHS Compliant | New At Mouser | 7 | 0,088 € | 0,62 €
604-APTD2012LZGCK | APTD2012LZGCK | Kingbright |  | Standard LEDs - SMD 0805 Dome Lens LED Green- 525nm | RoHS Compliant |  | 5 | 0,586 € | 2,93 €
649-10118194-0011LF | 10118194-0011LF | FCI / Amphenol |  | USB Connectors MICRO USD B-TYPE | RoHS Compliant |  | 1 | 0,464 € | 0,46 €
815-AIML-0603-82NKT | AIML-0603-82NK-T | ABRACON |  | Fixed Inductors FIXED IND 82NH 50MA 300 MOHM SMD | RoHS Compliant By Exemption |  | 1 | 0,149 € | 0,15 €
667-ERA-6ARB2212V | ERA-6ARB2212V | Panasonic |  | Thin Film Resistors - SMD 0805 Thin film chip resistor | RoHS Compliant By Exemption |  | 1 | 1,10 € | 1,10 €
667-ERA-6VEB1002V | ERA-6VEB1002V | Panasonic |  | Thin Film Resistors - SMD 0805 0.1% 10Kohm 25ppm SMD | RoHS Compliant | New Product | 7 | 0,613 € | 4,29 €
667-ERA-6VEB4701V | ERA-6VEB4701V | Panasonic |  | Thin Film Resistors - SMD 0805 0.1% 4.7Kohm 25ppm SMD | RoHS Compliant | New Product | 2 | 0,613 € | 1,23 €
187-CL21A226MAQNNNE | CL21A226MAQNNNE | Samsung Electro-Mechanics |  | Multilayer Ceramic Capacitors MLCC - SMD/SMT 22uF+/-20% 25V X5R 2012 | RoHS Compliant | New At Mouser | 4 | 0,289 € | 1,16 €
755-RSB6.8SMFHT2N | RSB6.8SMFHT2N | ROHM Semiconductor |  | Zener Diodes 5.78-7.82V 1mA SOD-523; EMD2 | RoHS Compliant | NRND | 5 | 0,376 € | 1,88 €
875-TYS50406R8M-10 | TYS50406R8M-10 | Laird Performance Materials |  | Fixed Inductors 6.8uH 20% -40C +125C | RoHS Compliant |  | 1 | 0,385 € | 0,39 €
798-U.FL-R-SMT10 | U.FL-R-SMT(10) | Hirose Electric |  | RF Connectors / Coaxial Connectors U.FL RECEPTACLE SMT GLD M CONT REEL | RoHS Compliant |  | 2 | 1,10 € | 2,20 €
80-C603C104K5RAC3121 | C0603C104K5RAC3121 | KEMET |  | Multilayer Ceramic Capacitors MLCC - SMD/SMT 50V 0.1uF X7R 0603 10% AEC-Q200 | RoHS Compliant |  | 5 | 0,131 € | 0,66 €
71-CRCW080549R9FKEAC | CRCW080549R9FKEAC | Vishay |  | Thick Film Resistors - SMD 1/8Watt 49.9ohms 1% Commercial Use | RoHS Compliant By Exemption |  | 12 | 0,055 € | 0,66 €
71-CRCW08050000Z0EAC | CRCW08050000Z0EAC | Vishay |  | Thick Film Resistors - SMD 1/8Watt 0ohms Commercial Use | RoHS Compliant |  | 15 | 0,037 € | 0,56 €
356-ES32WROOM32D16MB | ESP32-WROOM-32D(M113DH2800PH3Q0) | Espressif |  | WiFi Modules - 802.11 SMD Module, ESP32-D0WD, 128Mbits SPI flash, UART mode, PCB antenna |  |  | 1 | 3,94 € | 3,94 €
74-TM8R106K010UBA | TM8R106K010UBA | Vishay |  | Tantalum Capacitors - Solid SMD 10uF 10volts 10% R case MAP Hi-Rel | RoHS Compliant |  | 2 | 10,06 € | 20,12 €
755-TCSM1C106M8R | TCSM1C106M8R | ROHM Semiconductor |  | Tantalum Capacitors - Solid SMD Tantalum Capacitors (Bottom surface electrode : Extra large capacitance type), Case=M, Size=1608, Height=0.8+0.2/-0.0mm, Capacitance (IEC code) =10(106)uF, Rated voltage=16V, Impedance=6?, ESR=6000m?, Series=TCS | RoHS Compliant | New Product | 9 | 0,84 € | 7,56 €
581-F381E225MMA | F381E225MMA | Kyocera AVX |  | Tantalum Capacitors - Polymer 25V 2.2uF 20% 0603 ESR=500mOhms | RoHS Compliant | New Product | 1 | 4,23 € | 4,23 €
581-TPSC107K010T0200 | TPSC107K010T0200 | Kyocera AVX |  | Tantalum Capacitors - Solid SMD 10V 100uF 10% 2312 ESR=.7Ohm AEC-Q200 | RoHS Compliant |  | 2 | 0,858 € | 1,72 €
771-BAS70H-T/R | BAS70H,115 | Nexperia |  | Schottky Diodes & Rectifiers DIODE SCHOTTKY TAPE-7 | RoHS Compliant |  | 5 | 0,245 € | 1,23 €
749-SM0605TCRGB | SM0605RGB | BIVAR |  | Standard LEDs - SMD SMDTri-Color 0605LED RGB 630,523,468nm | RoHS Compliant |  | 2 | 1,13 € | 2,26 €
863-MMUN2133LT1G | MMUN2133LT1G | onsemi |  | Bipolar Transistors - Pre-Biased 100mA 50V BRT PNP | RoHS Compliant |  | 2 | 0,131 € | 0,26 €
71-TNPU08052K00AWEN | TNPU08052K00AWEN00 | Vishay |  | Thin Film Resistors - SMD 1/8watt 2Kohms 0.05% 2ppm | RoHS Compliant | New Product | 2 | 4,17 € | 8,34 €
71-CRCW0603270KFKEAC | CRCW0603270KFKEAC | Vishay |  | Thick Film Resistors - SMD 1/10Watt 270Kohms 1% Commercial Use | RoHS Compliant By Exemption |  | 1 | 0,14 € | 0,14 €
603-RC0603FR-071M87L | RC0603FR-071M87L | YAGEO |  | Thick Film Resistors - SMD 1.87 MOhms 100 mW 0603 1% | RoHS Compliant By Exemption |  | 2 | 0,088 € | 0,18 €
579-MCP73871-2AAI/ML | MCP73871-2AAI/ML | Microchip |  | Battery Management USB/AC Battery Charger | RoHS Compliant |  | 1 | 1,93 € | 1,93 €
595-TPS61030RSAR | TPS61030RSAR | Texas Instruments |  | Switching Voltage Regulators 1Adj 1-A 96% Eff Boost Converter | RoHS Compliant |  | 1 | 2,74 € | 2,74 €
667-ERJ-UP3F1003V | ERJ-UP3F1003V | Panasonic |  | Thick Film Resistors - SMD 0603 Anti-sulfurated anti-surge resistor | RoHS Compliant By Exemption | New Product | 2 | 0,228 € | 0,46 €
667-ERJ-UP3F2001V | ERJ-UP3F2001V | Panasonic |  | Thick Film Resistors - SMD 0603 0.25W 1% 2Kohm AEC-Q200 | RoHS Compliant By Exemption | New Product | 1 | 0,228 € | 0,23 €
667-ERJ-UP3F2003V | ERJ-UP3F2003V | Panasonic |  | Thick Film Resistors - SMD 0603 Anti-sulfurated anti-surge resistor | RoHS Compliant By Exemption | New Product | 2 | 0,228 € | 0,46 €
667-ERJ-3EKF3403V | ERJ-3EKF3403V | Panasonic |  | Thick Film Resistors - SMD 0603 340Kohms 1% AEC-Q200 | RoHS Compliant By Exemption |  | 1 | 0,088 € | 0,09 €
667-ERJ-UP3F1503V | ERJ-UP3F1503V | Panasonic |  | Thick Film Resistors - SMD 0603 Anti-sulfurated anti-surge resistor | RoHS Compliant | New Product | 1 | 0,219 € | 0,22 €
80-T494A106M020 | T494A106M020AT | KEMET |  | Tantalum Capacitors - Solid SMD 20V 10uF 1206 20% ESR=3ohms | RoHS Compliant |  | 3 | 0,761 € | 2,28 €
667-ERA-3VEB1001V | ERA-3VEB1001V | Panasonic |  | Thin Film Resistors - SMD 0603 0.1% 1Kohm 25ppm SMD | RoHS Compliant | New Product | 5 | 0,508 € | 2,54 €
910-SMD291 | SMD291 | Chip Quik |  | Soldering Flux Tack Flux No-clean 10cc w/Plunger & Tip | RoHS Compliant |  | 1 | 12,86 € | 12,86 €
538-206640-0001 | 206640-0001 | Molex |  | Antennas GNSS Activ Patch Ant Low-Noise Amplifier | RoHS Compliant By Exemption |  | 1 | 6,46 € | 6,46 €
712-ANT-LPC-FPC-100 | ANT-LPC-FPC-100 | Linx Technologies |  | Antennas Cellular Multiband Dipole Flexible Patch, U.FL-type Plug | RoHS Compliant |  | 1 | 3,93 € | 3,93 €
