enggsajjad/scooter/parts/gprs/HW0SerialMasterSlaveExample/screenshot.JPG

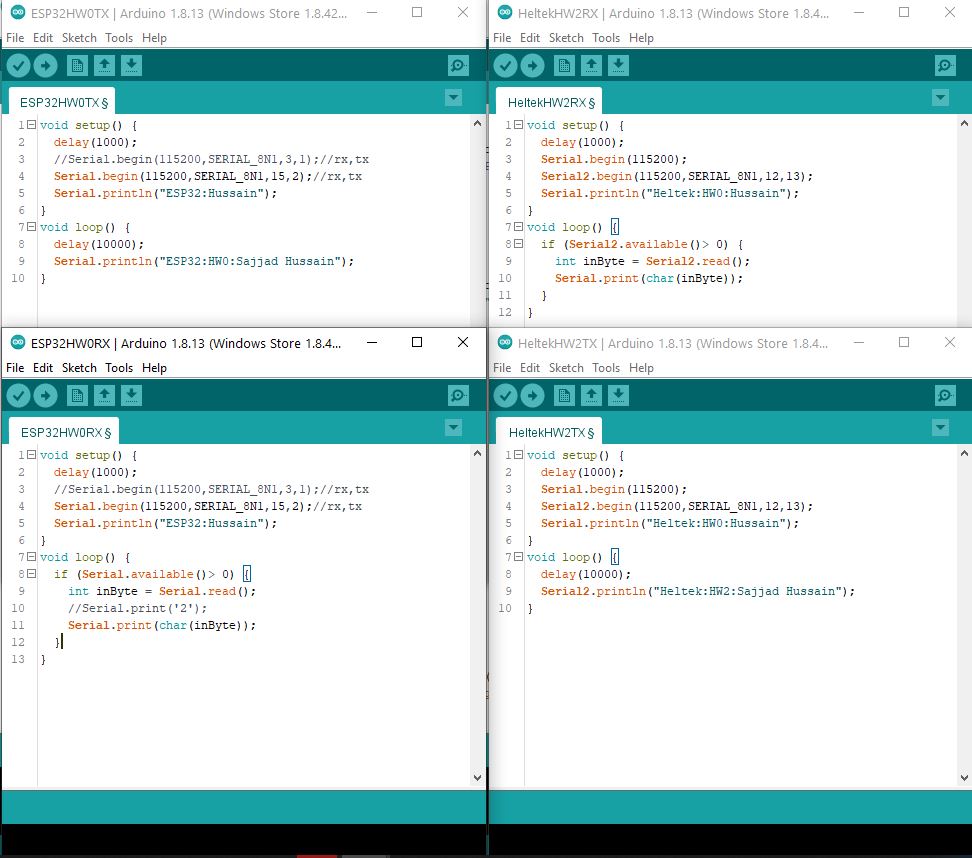
parts/gprs/HW0SerialMasterSlaveExample/screenshot.JPG
