enggsajjad/scooter/test/testPCBRev1/esp32scooter/Readme.md

# SMARTAQNET SCOOTER (ReadMe)
 
<p align="center">
    
</p>
 
The **SMARTAQNET** project is aimed at development of a close-meshed network of local fine-dust data, which can be fed and used well by general public.
This project uses a ESP32 Board, a SDS011 particulate matter sensor, a BME280 sensor or a DHT22 sensor and a GPRS/GPS Module A9G or A7. Further details can be checked at:
[smartaq.net](http://www.smartaq.net "SMARTAQNET Website")
 
## How to use this repository
The repository can be used with Arduino IDE with ESP32 board and some pre-requisit libraries installed on it. The details can be looked at: "./src/Latex/refman.pdf".
 
## Contributors
This repository was constructed by [TECO-KIT](https://www.teco.edu/ "TECO-KIT").
 
## Licence
This code belongs to [TECO-KIT](https://www.teco.edu/ "TECO-KIT") and must be reffered when used. BSD license, all used library's Licences 
must be included in any redistribution.
