enggsajjad/scooter/logs/20211208 2115 Test1 Thingspeak feed.csv

created_at | entry_id | field1 | field2 | field3 | field4 | field5 | field6 | latitude | longitude | elevation | status
2021-12-08T20:58:27+01:00 | 1 | 30.89 | 24.21 | 987.97 | 6.50 | 9.00 | $GNGGA,000108.263,4900.5241,N,00825.4800,E,0,0,,102.1,M,47.9,M,,*57
2021-12-08T20:58:51+01:00 | 2 | 30.74 | 23.65 | 987.96 | 7.10 | 9.60 | $GNGGA,000131.263,4900.5241,N,00825.4800,E,0,0,,102.1,M,47.9,M,,*5D
2021-12-08T20:59:33+01:00 | 3 | 30.63 | 23.57 | 987.97 | 6.50 | 8.50 | $GNGGA,000214.263,4900.5241,N,00825.4800,E,0,0,,102.1,M,47.9,M,,*59
2021-12-08T21:03:56+01:00 | 4 | 30.89 | 24.23 | 988.00 | 6.70 | 8.80 | $GNGGA,000057.263,4900.5241,N,00825.4800,E,0,0,,102.1,M,47.9,M,,*5C
2021-12-08T21:04:19+01:00 | 5 | 30.68 | 23.97 | 988.01 | 6.10 | 6.50 | $GNGGA,000120.263,4900.5241,N,00825.4800,E,0,0,,102.1,M,47.9,M,,*5D
2021-12-08T21:05:03+01:00 | 6 | 30.55 | 23.79 | 988.02 | 5.80 | 6.20 | $GNGGA,000143.263,4900.5241,N,00825.4800,E,0,0,,102.1,M,47.9,M,,*58
2021-12-08T21:06:16+01:00 | 7 | 30.34 | 25.91 | 988.04 | 5.70 | 7.80 | $GNGGA,000045.263,4900.5241,N,00825.4800,E,0,0,,102.1,M,47.9,M,,*5F
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
