enggsajjad/scooter/logs/20211209 1400 Test2 Thingspeak feed.csv

created_at | entry_id | field1 | field2 | field3 | field4 | field5 | field6 | latitude | longitude | elevation | status
2021-12-09T13:56:19+01:00 | 1 | 24.61 | 31.25 | 993.27 | 5.70 | 7.90 | $GNGGA,000048.263,4900.5241,N,00825.4800,E,0,0,,102.1,M,47.9,M,,*52
2021-12-09T13:57:01+01:00 | 2 | 24.62 | 24.55 | 993.29 | 5.80 | 10.10 | $GNGGA,000130.263,4900.5241,N,00825.4800,E,0,0,,102.1,M,47.9,M,,*5C
2021-12-09T13:57:24+01:00 | 3 | 24.51 | 23.52 | 993.29 | 4.40 | 8.80 | $GNGGA,000153.263,4900.5241,N,00825.4800,E,0,0,,102.1,M,47.9,M,,*59
2021-12-09T13:57:47+01:00 | 4 | 24.38 | 23.50 | 993.31 | 4.80 | 8.50 | $GNGGA,000216.263,4900.5241,N,00825.4800,E,0,0,,102.1,M,47.9,M,,*5B
2021-12-09T13:58:10+01:00 | 5 | 24.17 | 23.43 | 993.30 | 5.50 | 9.60 | $GNGGA,000239.263,4900.5241,N,00825.4800,E,0,0,,102.1,M,47.9,M,,*56
2021-12-09T13:58:33+01:00 | 6 | 23.91 | 23.47 | 993.29 | 6.50 | 12.40 | $GNGGA,000302.263,4900.5241,N,00825.4800,E,0,0,,102.1,M,47.9,M,,*5F
2021-12-09T13:58:56+01:00 | 7 | 23.62 | 24.48 | 993.29 | 5.90 | 10.40 | $GNGGA,000325.263,4900.5241,N,00825.4800,E,0,0,,102.1,M,47.9,M,,*5A
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
