enggsajjad/scooter/logs/20211209 1540 Test3 Thingspeak feed.csv

created_at | entry_id | field1 | field2 | field3 | field4 | field5 | field6 | latitude | longitude | elevation | status
2021-12-09T15:40:32+01:00 | 1 | 26.04 | 21.94 | 993.20 | 5.10 | 10.20 | $GNGGA,144027.000,4900.5206,N,00825.4558,E,1,4,3.15,143.0,M,47.9,M,,*46
2021-12-09T15:40:55+01:00 | 2 | 25.85 | 21.93 | 993.21 | 4.60 | 8.80 | $GNGGA,144050.000,4900.5095,N,00825.4234,E,1,4,3.15,144.6,M,47.9,M,,*42
2021-12-09T15:41:18+01:00 | 3 | 25.78 | 21.81 | 993.22 | 4.50 | 7.40 | $GNGGA,144113.000,4900.4976,N,00825.3563,E,1,4,3.16,123.8,M,47.9,M,,*4F
2021-12-09T15:41:41+01:00 | 4 | 25.75 | 21.22 | 993.23 | 3.90 | 7.10 | $GNGGA,144136.000,4900.4993,N,00825.3518,E,1,4,3.16,113.5,M,47.9,M,,*41
2021-12-09T15:42:04+01:00 | 5 | 25.77 | 21.47 | 993.23 | 4.80 | 9.20 | $GNGGA,144159.000,4900.5123,N,00825.3968,E,1,4,3.16,119.0,M,47.9,M,,*4E
2021-12-09T15:42:27+01:00 | 6 | 25.84 | 21.21 | 993.24 | 4.90 | 9.00 | $GNGGA,144222.000,4900.5127,N,00825.4232,E,1,4,3.17,125.1,M,47.9,M,,*49
2021-12-09T15:42:50+01:00 | 7 | 25.89 | 20.81 | 993.25 | 5.50 | 10.40 | $GNGGA,144245.000,4900.5216,N,00825.4537,E,1,4,3.45,131.5,M,47.9,M,,*4D
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
