enggsajjad/scooter/logs/20211209 2232 Test5&6 Thingspeak feed.csv

created_at | entry_id | field1 | field2 | field3 | field4 | field5 | field6 | latitude | longitude | elevation | status
2021-12-09T22:33:27+01:00 | 1 | 29.68 | 25.77 | 992.14 | 7.50 | 11.20 | $GNGGA,000045.264,4900.5200,N,00825.4584,E,0,0,,145.7,M,47.9,M,,*59
2021-12-09T22:33:50+01:00 | 2 | 29.50 | 25.68 | 992.14 | 7.90 | 10.30 | $GNGGA,000108.264,4900.5200,N,00825.4584,E,0,0,,145.7,M,47.9,M,,*51
2021-12-09T22:34:13+01:00 | 3 | 29.40 | 25.49 | 992.14 | 7.30 | 9.80 | $GNGGA,000131.264,4900.5200,N,00825.4584,E,0,0,,145.7,M,47.9,M,,*5B
2021-12-09T22:34:36+01:00 | 4 | 29.35 | 25.35 | 992.14 | 6.60 | 11.60 | $GNGGA,000154.264,4900.5200,N,00825.4584,E,0,0,,145.7,M,47.9,M,,*58
2021-12-09T22:34:59+01:00 | 5 | 29.34 | 25.27 | 992.13 | 6.00 | 10.40 | $GNGGA,000217.264,4900.5200,N,00825.4584,E,0,0,,145.7,M,47.9,M,,*5C
2021-12-09T22:35:22+01:00 | 6 | 29.35 | 25.27 | 992.13 | 7.00 | 11.40 | $GNGGA,000240.264,4900.5200,N,00825.4584,E,0,0,,145.7,M,47.9,M,,*5E
2021-12-09T22:35:45+01:00 | 7 | 29.37 | 25.20 | 992.12 | 7.40 | 13.90 | $GNGGA,000303.264,4900.5200,N,00825.4584,E,0,0,,145.7,M,47.9,M,,*58
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
