enggsajjad/scooter/logs/20211213221805 Test with longer runs to see if there is any missing values at thingspeak.csv

created_at | entry_id | field1 | field2 | field3 | field4 | field5 | field6 | latitude | longitude | elevation | status
2021-12-13T04:39:06+01:00 | 1 | 2.00 | 18.00 | 0.00 | 22.00 | 34.00 | $GNGGA,033902.092,4900.4539,N,00825.2107,E,0,1,,78.7,M,47.9,M,,*63
2021-12-13T04:39:27+01:00 | 2 | 8.00 | 18.00 | 1.00 | 24.00 | 31.00 | $GNGGA,033923.092,4900.5216,N,00825.4375,E,0,1,,78.7,M,47.9,M,,*6A
2021-12-13T04:39:47+01:00 | 3 | 6.00 | 14.00 | 2.00 | 20.00 | 31.00 | $GNGGA,033943.092,4900.5217,N,00825.4377,E,0,1,,78.7,M,47.9,M,,*6F
2021-12-13T04:40:07+01:00 | 4 | 4.00 | 19.00 | 3.00 | 23.00 | 34.00 | $GNGGA,034003.092,4900.5217,N,00825.4378,E,0,1,,78.7,M,47.9,M,,*6A
2021-12-13T04:40:27+01:00 | 5 | 6.00 | 10.00 | 4.00 | 21.00 | 33.00 | $GNGGA,034023.092,9000.0000,N,00000.0000,E,0,0,,137.0,M,13.0,M,,*5E
2021-12-13T04:40:47+01:00 | 6 | 3.00 | 16.00 | 5.00 | 23.00 | 34.00 | $GNGGA,034043.094,9000.0000,N,00000.0000,E,0,0,,137.0,M,13.0,M,,*5E
2021-12-13T21:14:46+01:00 | 7 | 7.00 | 12.00 | 0.00 | 20.00 | 30.00 | $GNGGA,201442.094,4900.5216,N,00825.4377,E,0,0,,78.7,M,47.9,M,,*66
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
