enggsajjad/scooter/logs/20211214001420 test long runs, but gives error of IP PROCESSING, but nothing missed.csv

created_at | entry_id | field1 | field2 | field3 | field4 | field5 | field6 | latitude | longitude | elevation | status
2021-12-13T23:58:01+01:00 | 328 | 4 | 18 | 0 | 21 | 33 | $GNGGA,000029.482,4900.5208,N,00825.4515,E,0,0,,102.1,M,47.9,M,,*58
2021-12-13T23:58:18+01:00 | 329 | 8 | 17 | 1 | 24 | 33 | $GNGGA,225814.094,4900.4935,N,00825.4760,E,0,2,,118.0,M,47.9,M,,*54
2021-12-13T23:58:35+01:00 | 330 | 8 | 11 | 2 | 23 | 33 | $GNGGA,225831.094,4900.5879,N,00825.3457,E,0,3,,142.8,M,47.9,M,,*5D
2021-12-13T23:58:52+01:00 | 331 | 6 | 16 | 3 | 24 | 30 | $GNGGA,225848.000,4900.5284,N,00825.4593,E,1,4,2.22,160.2,M,47.9,M,,*48
2021-12-13T23:59:09+01:00 | 332 | 3 | 19 | 4 | 20 | 30 | $GNGGA,225905.000,4900.5247,N,00825.4638,E,1,4,2.22,153.6,M,47.9,M,,*49
2021-12-13T23:59:26+01:00 | 333 | 8 | 19 | 5 | 23 | 31 | $GNGGA,225922.000,4900.5256,N,00825.4608,E,1,4,2.22,156.3,M,47.9,M,,*4F
2021-12-13T23:59:43+01:00 | 334 | 9 | 19 | 6 | 20 | 31 | $GNGGA,225939.000,4900.5272,N,00825.4499,E,1,4,2.22,155.7,M,47.9,M,,*4E
2021-12-14T00:00:01+01:00 | 335 | 4 | 17 | 7 | 22 | 33 | $GNGGA,225957.000,4900.5276,N,00825.4520,E,1,4,2.22,151.2,M,47.9,M,,*40
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
