enggsajjad/scooter/logs/20210302 Testing PCB with A9G Module.jpg

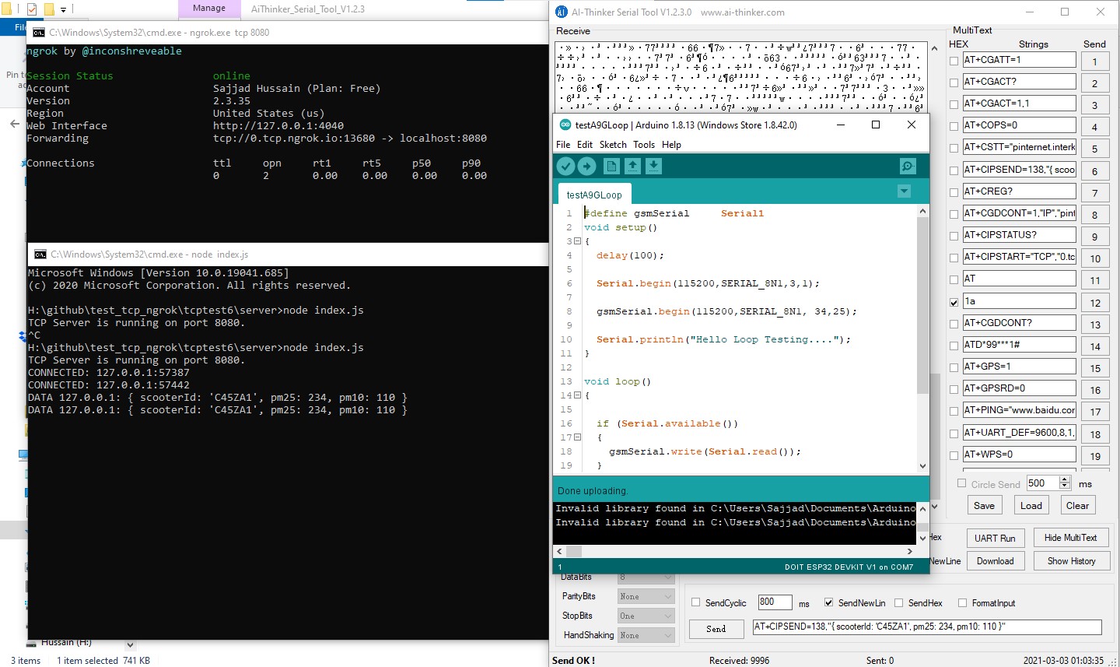
logs/20210302 Testing PCB with A9G Module.jpg
