enggsajjad/scooter/logs/20210728 Testing A9G GPS/20210728 Testing AT 3.jpg

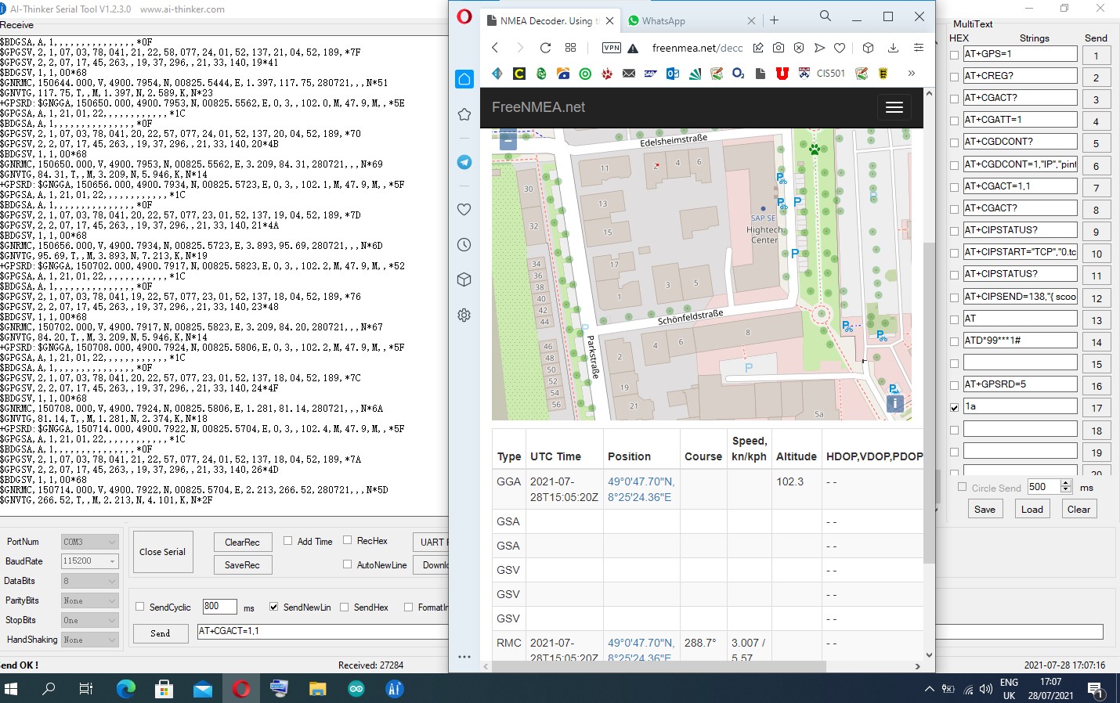
logs/20210728 Testing A9G GPS/20210728 Testing AT 3.jpg
