enggsajjad/scooter/logs/20211119 gps tests with case in the bag.png

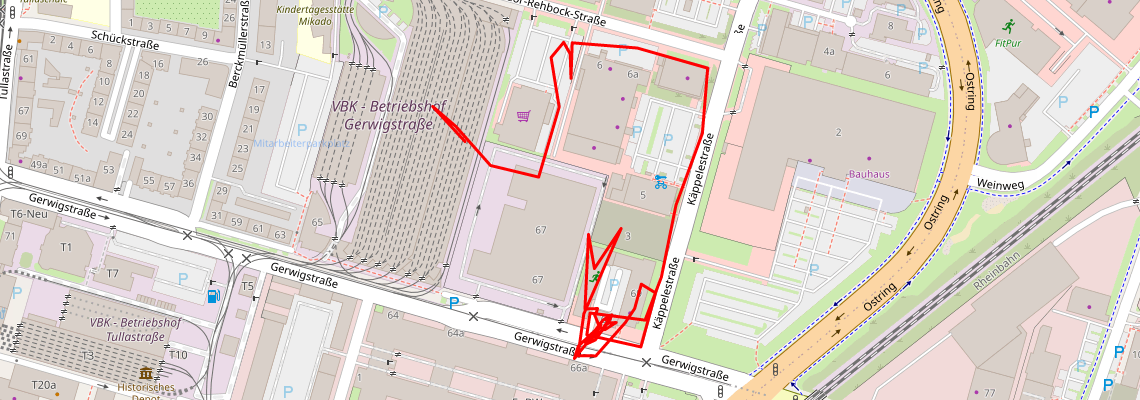
logs/20211119 gps tests with case in the bag.png
