enggsajjad/scooter/logs/20211209 1540 Test3 GPS location until it is hanged in the error state.jpg

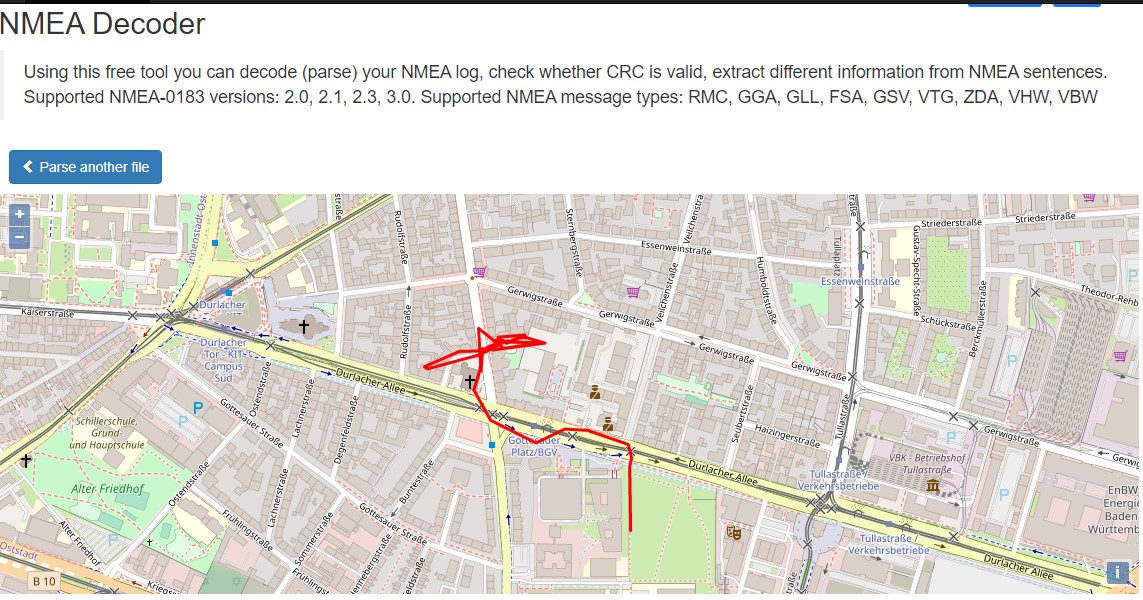
logs/20211209 1540 Test3 GPS location until it is hanged in the error state.jpg
