enggsajjad/scooter/logs/20220416 Tests Walking Maps.jpg

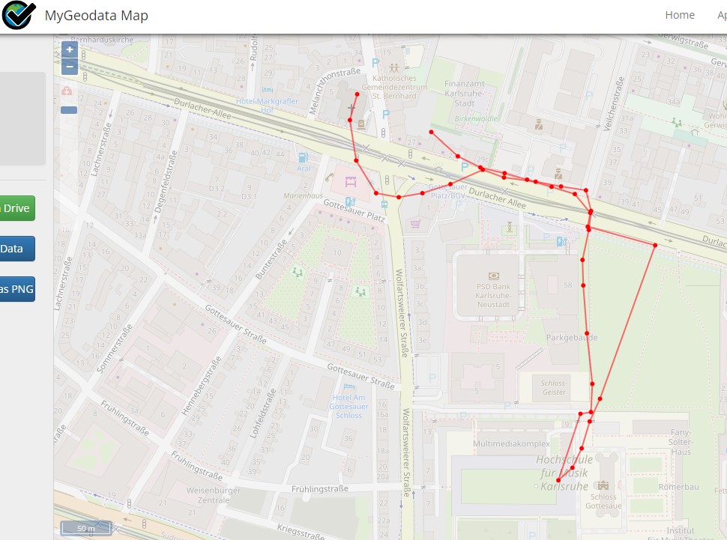
logs/20220416 Tests Walking Maps.jpg
