enggsajjad/scooter/logs/20220503 First Tests with Pink Case Map.jpg

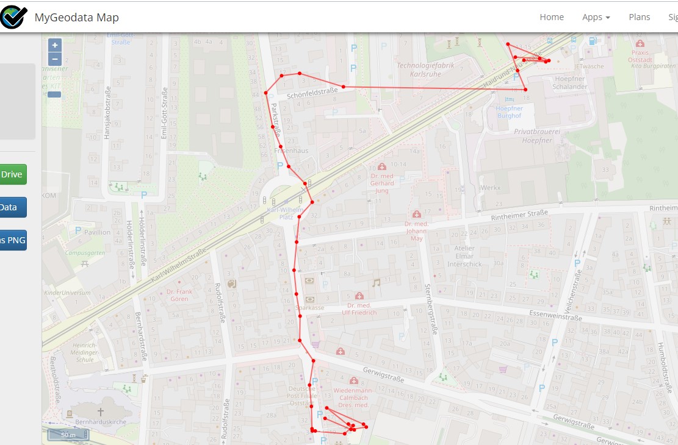
logs/20220503 First Tests with Pink Case Map.jpg
