enggsajjad/scooter/logs/20220503 First Tests with Pink Case Temperature.jpg

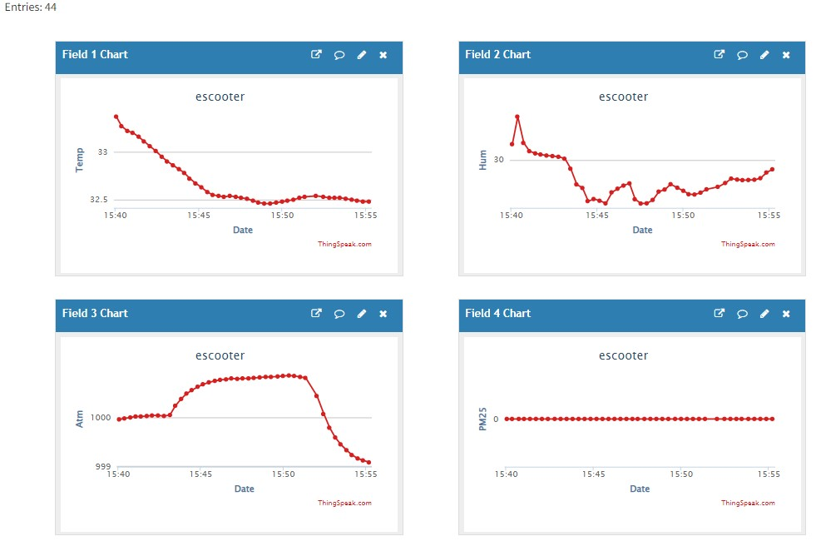
logs/20220503 First Tests with Pink Case Temperature.jpg
