enggsajjad/scooter/logs/20220507 Walk Test from Teco Map.jpg

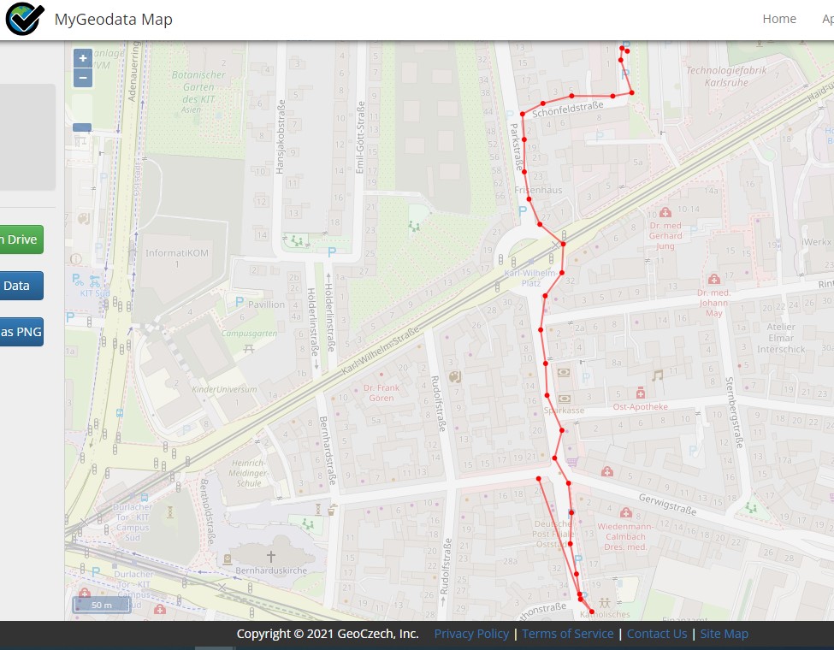
logs/20220507 Walk Test from Teco Map.jpg
