enggsajjad/scooter/logs/20220507 Walk Test from Teco Temperature.jpg

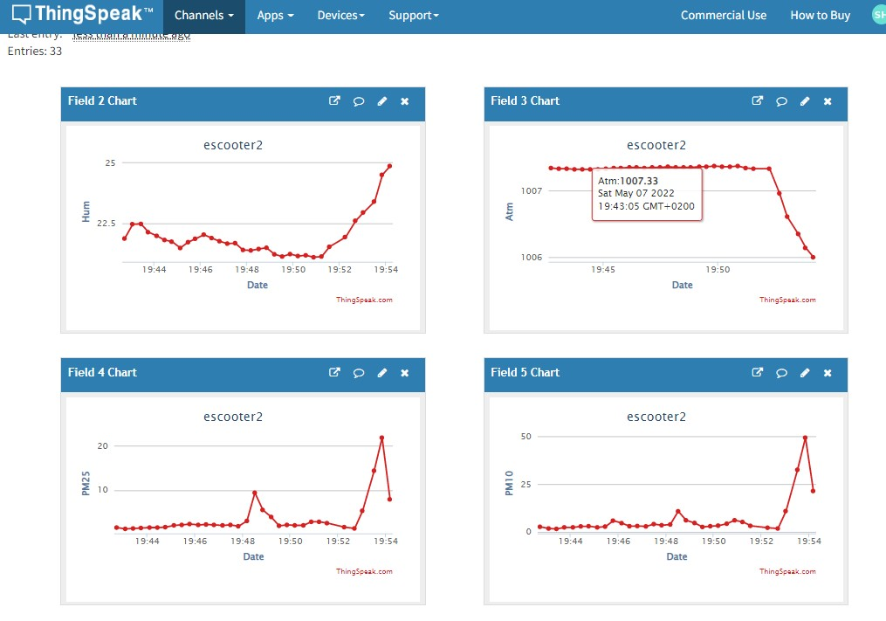
logs/20220507 Walk Test from Teco Temperature.jpg
