enggsajjad/scooter/logs/20220507 Walk Test Map.jpg

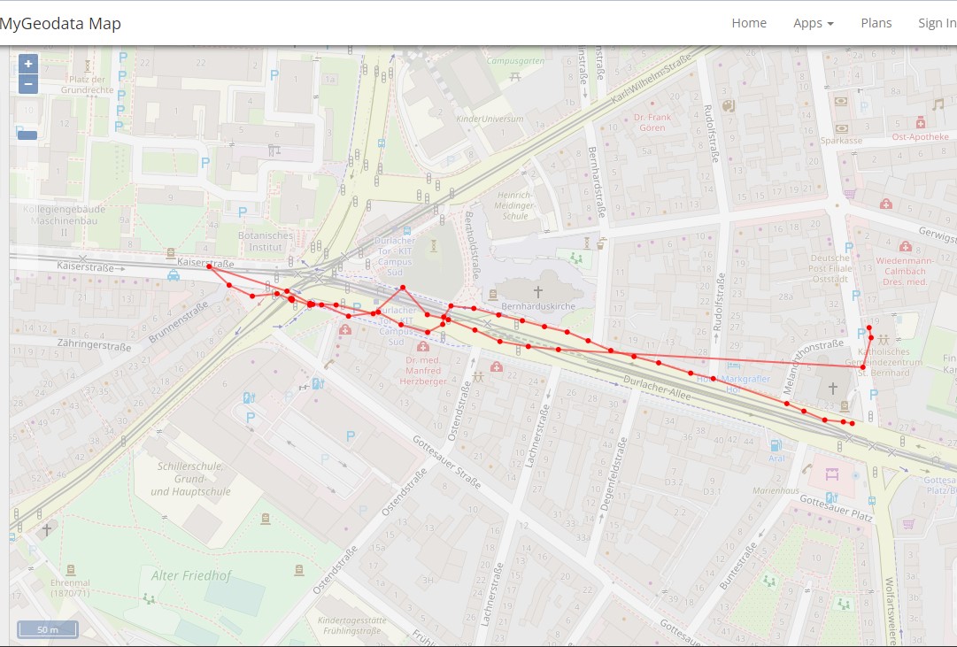
logs/20220507 Walk Test Map.jpg
