enggsajjad/scooter/logs/20220507 Walk Test Temperature.jpg

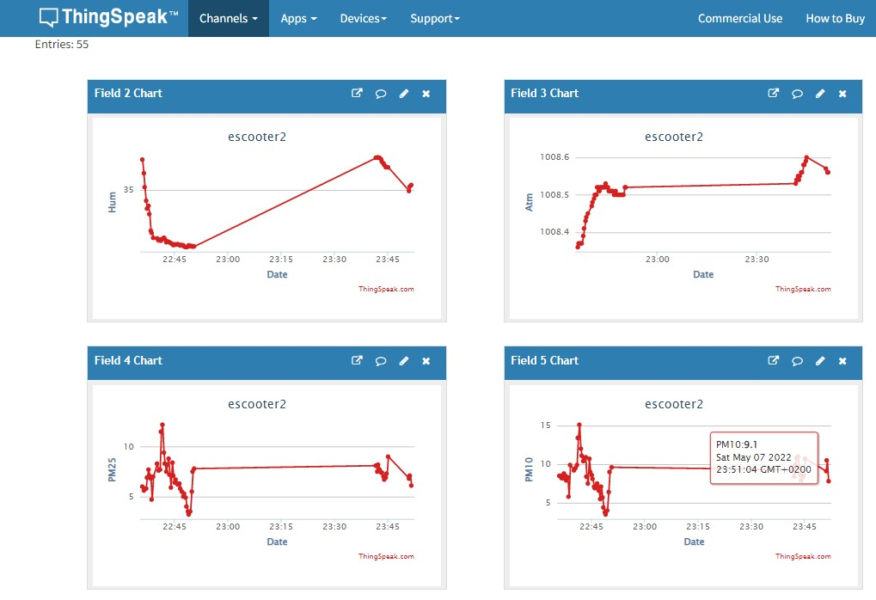
logs/20220507 Walk Test Temperature.jpg
