enggsajjad/scooter/logs/20220508 Tests Map.jpg

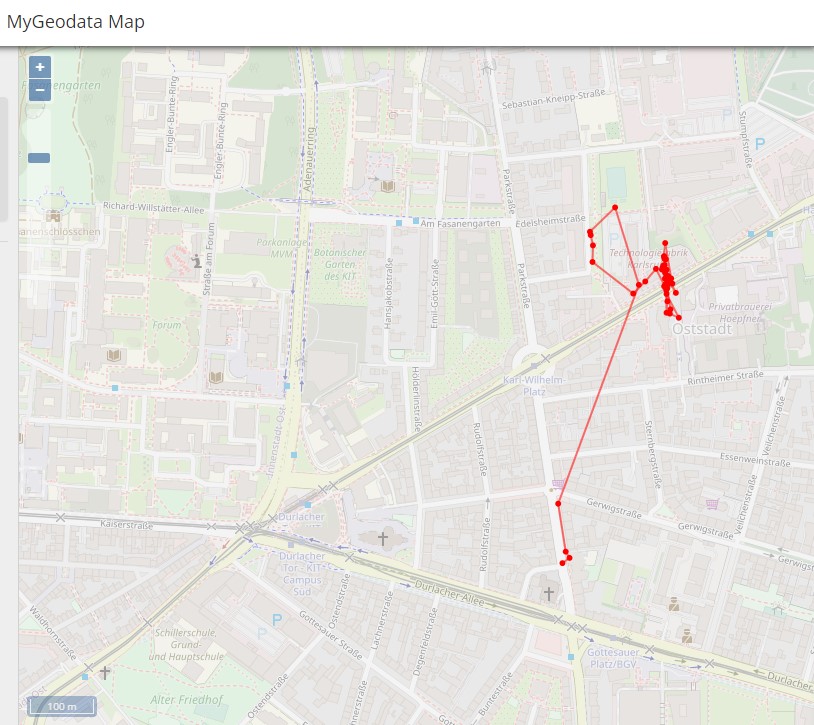
logs/20220508 Tests Map.jpg
