enggsajjad/scooter/logs/20220510 Test Walking escooter2 2130-2235.jpg

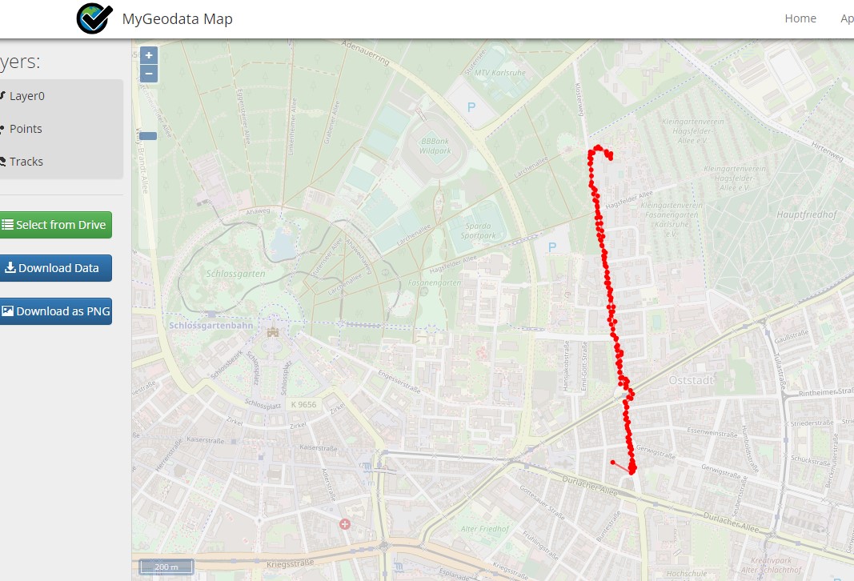
logs/20220510 Test Walking escooter2 2130-2235.jpg
