enggsajjad/scooter/logs/20220510 Test Walking escooter2 with charging full.jpg

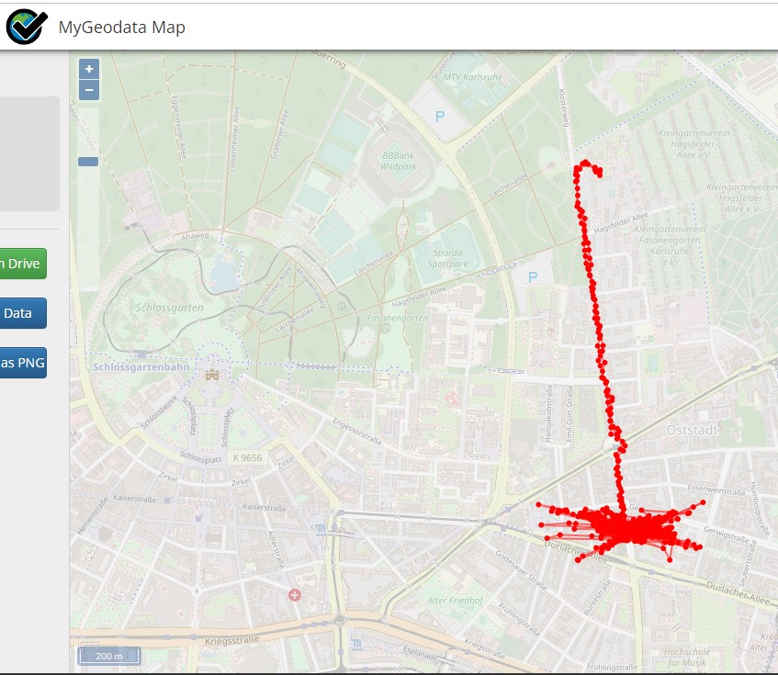
logs/20220510 Test Walking escooter2 with charging full.jpg
