enggsajjad/scooter/logs/20220510 Test Walking escooter3 2130-2235 but there is no data sent, green led on.jpg

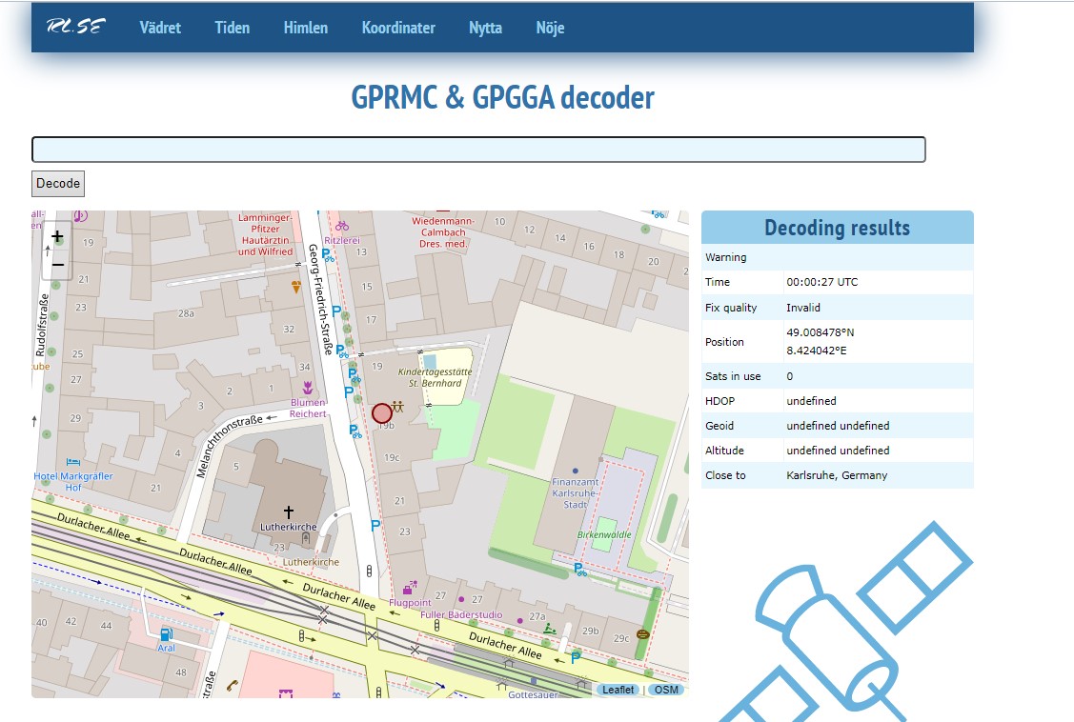
logs/20220510 Test Walking escooter3 2130-2235 but there is no data sent, green led on.jpg
