enggsajjad/scooter/logs/20220511 Walking Tests escooter2, while escooter3 is not initializing temperature.jpg

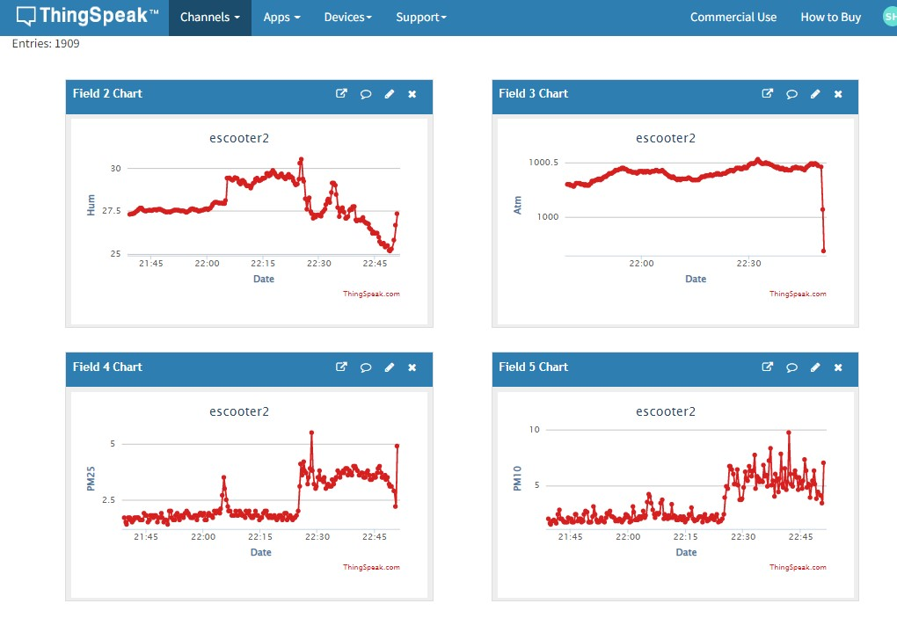
logs/20220511 Walking Tests escooter2, while escooter3 is not initializing temperature.jpg
