enggsajjad/scooter/logs/20220512 Walking Tests Map.jpg

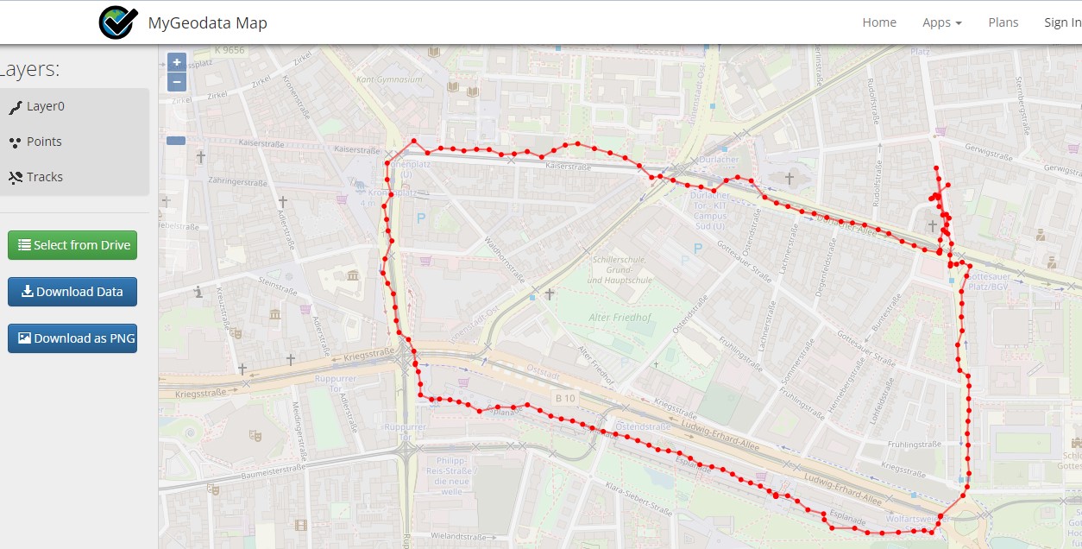
logs/20220512 Walking Tests Map.jpg
