enggsajjad/scooter/logs/20220512 Walking Tests Temperature.jpg

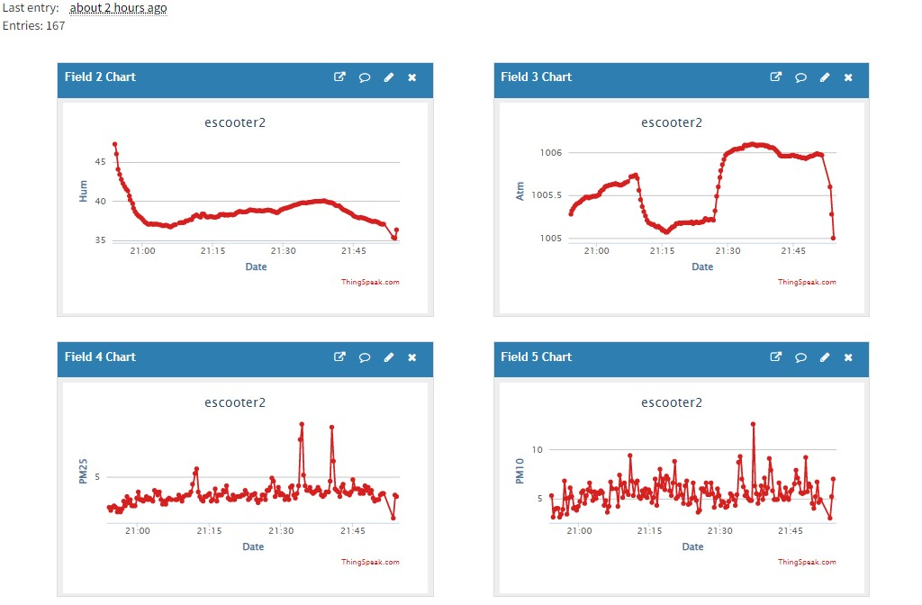
logs/20220512 Walking Tests Temperature.jpg
