enggsajjad/scooter/logs/20220516 Walk Test map.jpg

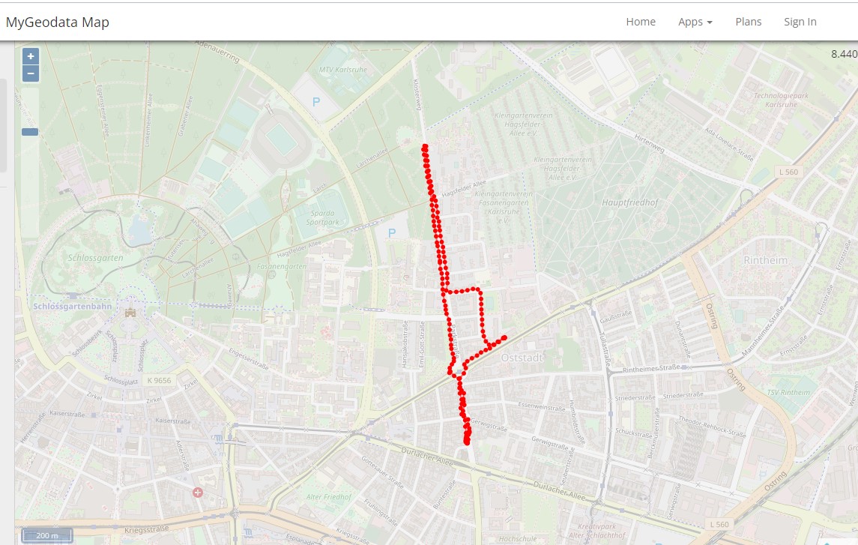
logs/20220516 Walk Test map.jpg
