enggsajjad/scooter/logs/20220516 Walk Test Temperature.jpg

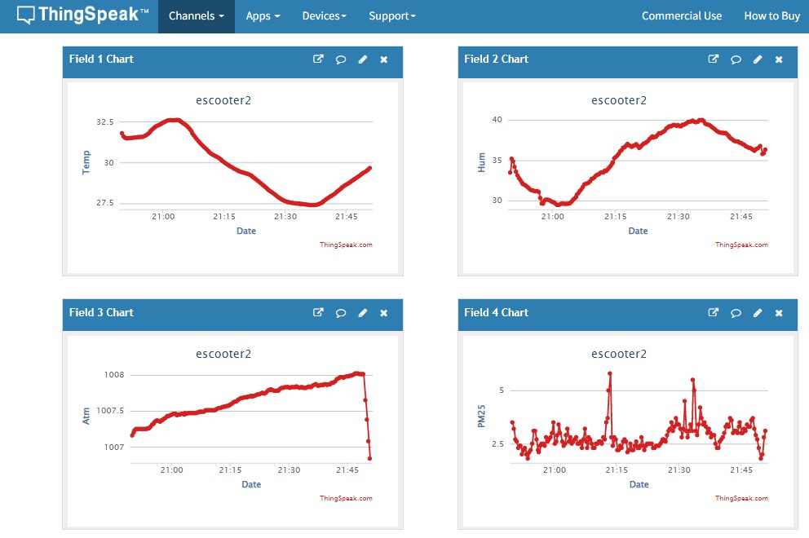
logs/20220516 Walk Test Temperature.jpg
