enggsajjad/scooter/logs/20220523 escooter2 walking test maps.jpg

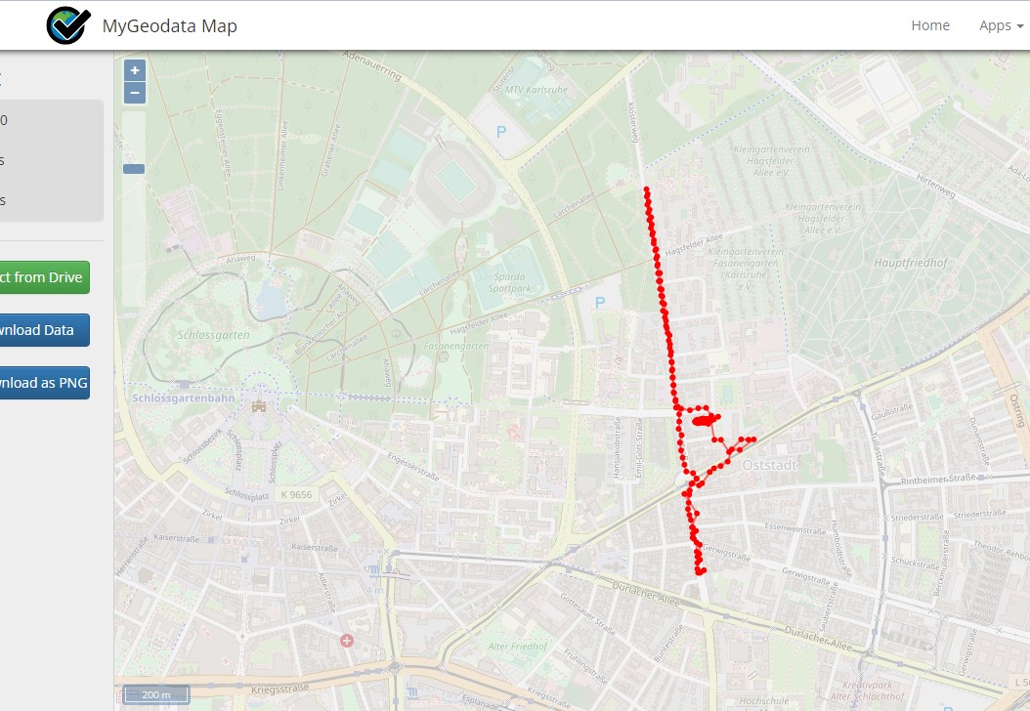
logs/20220523 escooter2 walking test maps.jpg
