enggsajjad/scooter/logs/20220523 escooter2 walking test Temperature.jpg

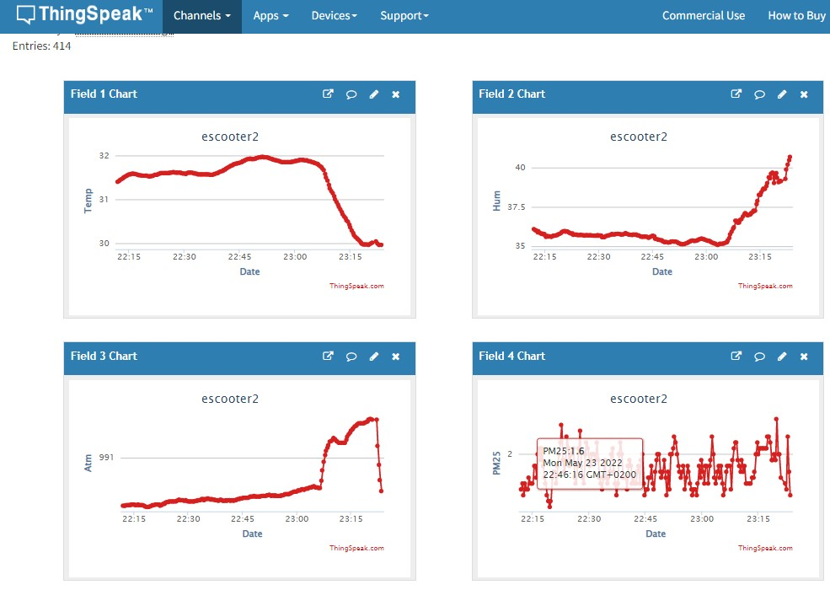
logs/20220523 escooter2 walking test Temperature.jpg
