enggsajjad/scooter/logs/20220523 escooter3 walking test maps.jpg

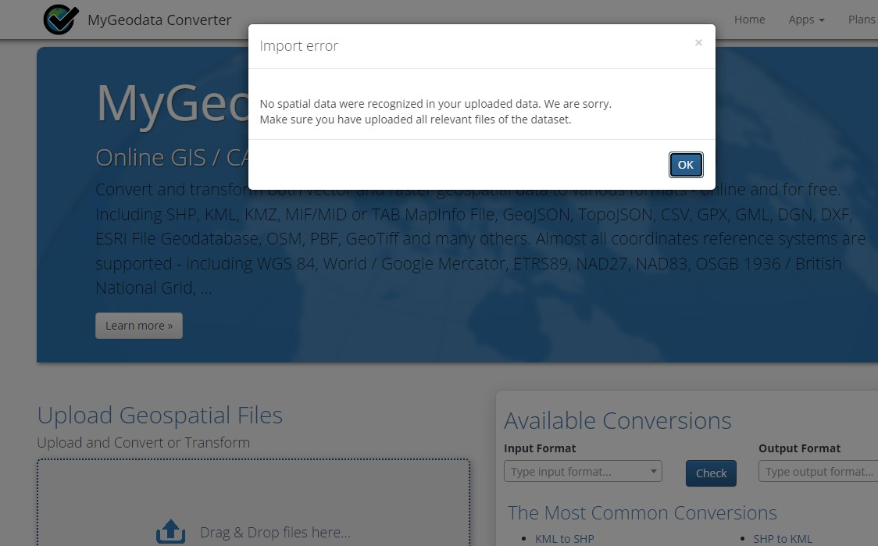
logs/20220523 escooter3 walking test maps.jpg
