enggsajjad/scooter/logs/20220523 escooter3 walking test Temperature.jpg

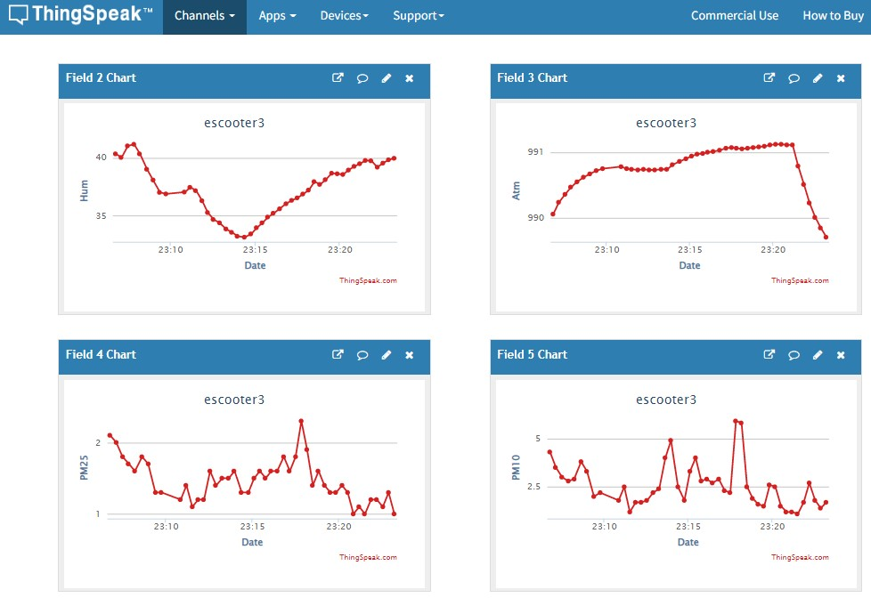
logs/20220523 escooter3 walking test Temperature.jpg
