enggsajjad/scooter/logs/202112201810 SIM1 ngrok Test Data, Stopped after some time.jpg

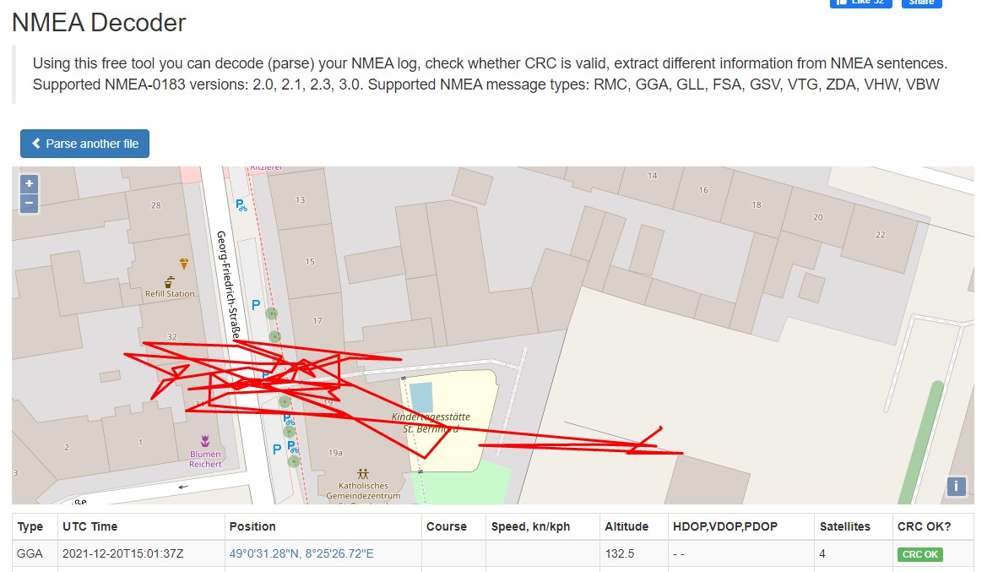
logs/202112201810 SIM1 ngrok Test Data, Stopped after some time.jpg
