enggsajjad/scooter/logs/202112201810 SIM2 thingspeak Test Data, Stopped after some time blackbox.jpg

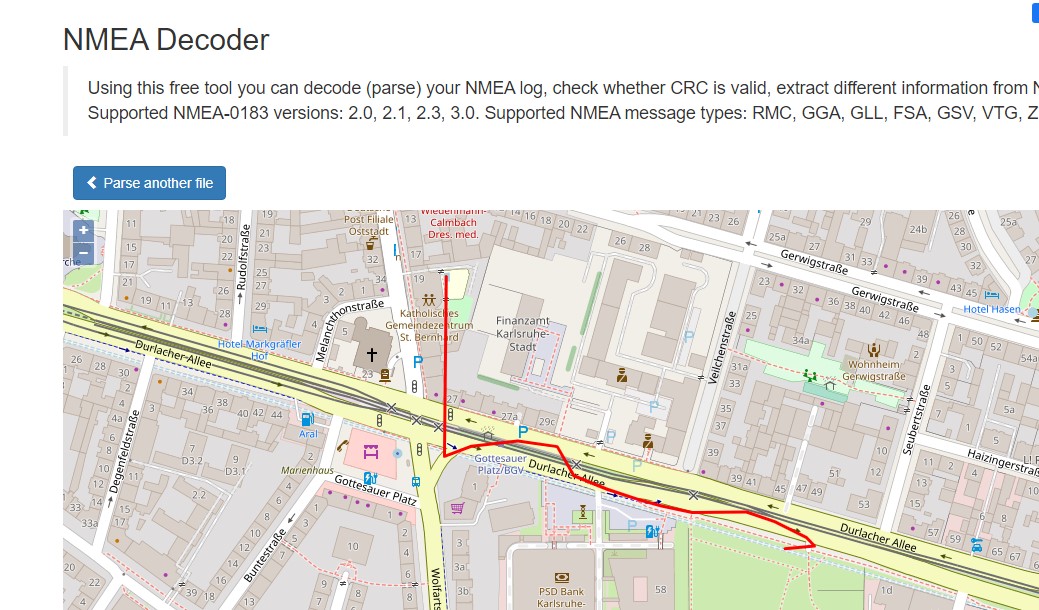
logs/202112201810 SIM2 thingspeak Test Data, Stopped after some time blackbox.jpg
