enggsajjad/scooter/logs/20211224155300 long test with test values PCB3 stopped while walking to TECO 47 values only WALK.jpg

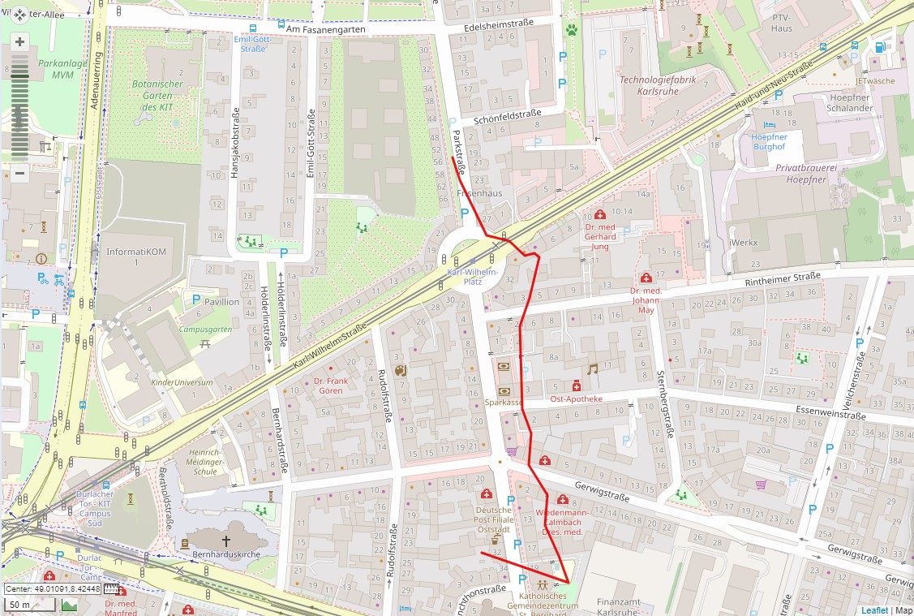
logs/20211224155300 long test with test values PCB3 stopped while walking to TECO 47 values only WALK.jpg
