enggsajjad/scooter/logs/20220107223447 Small Antenna Test.png

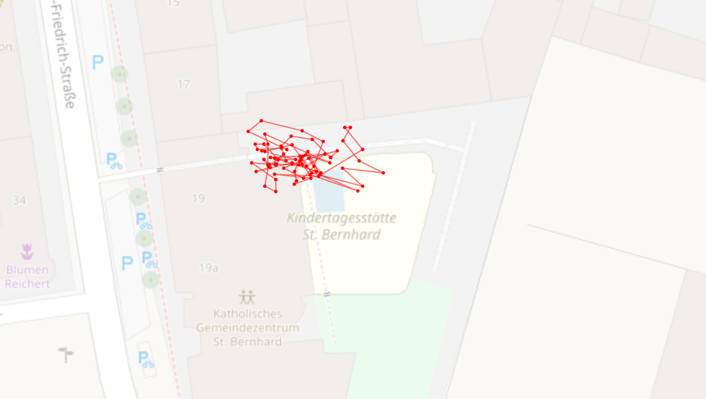
logs/20220107223447 Small Antenna Test.png
