enggsajjad/scooter/pcb/PCB5/Schematic_escooter_sajjad - rev7_2022-03-05.pdf

# IO12 14 GND 15

IO0 25 IO4 26 IO16 27 IO17 28 IO5 29 IO18 30 IO19 31 NC 32 IO21 33 RXD0 34 TXD0 35 IO22 36 IO23 37 GND 38

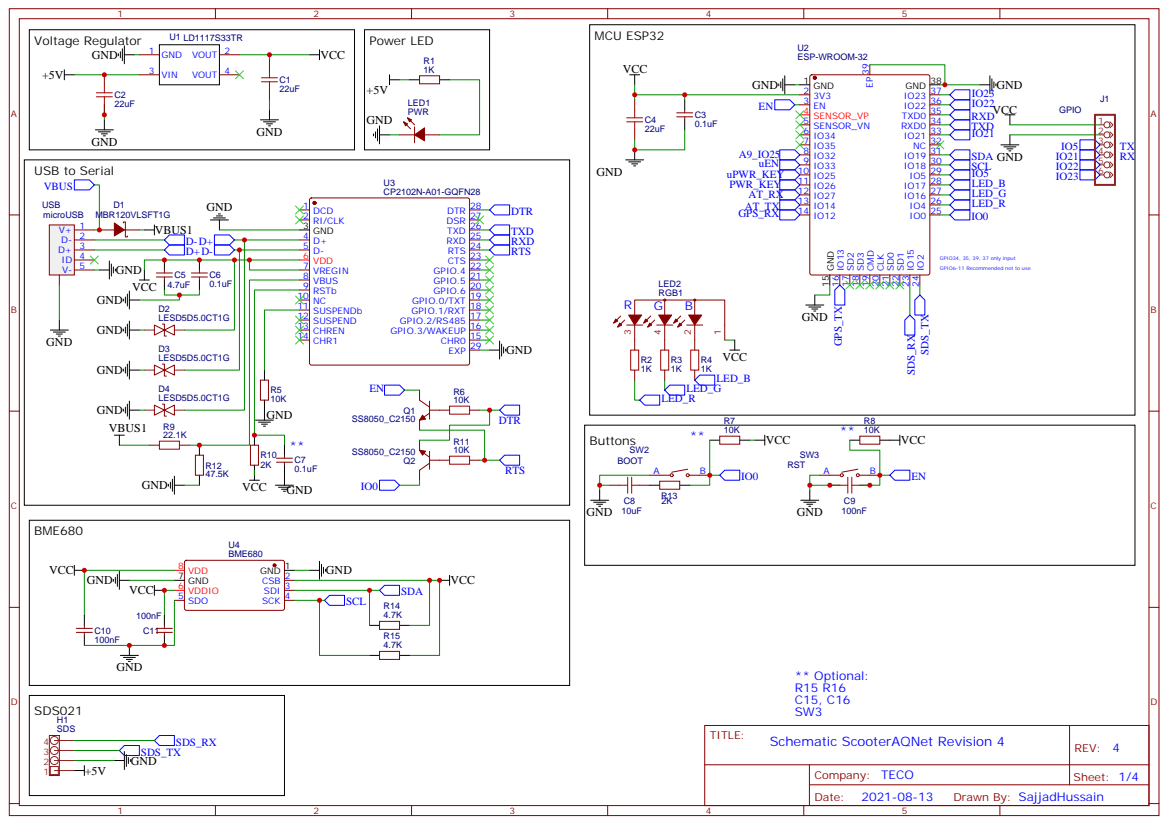
[picture p162: page 1]

GPIO34, 35, 39, 37 only input
GPIO6-11 Recommended not to use

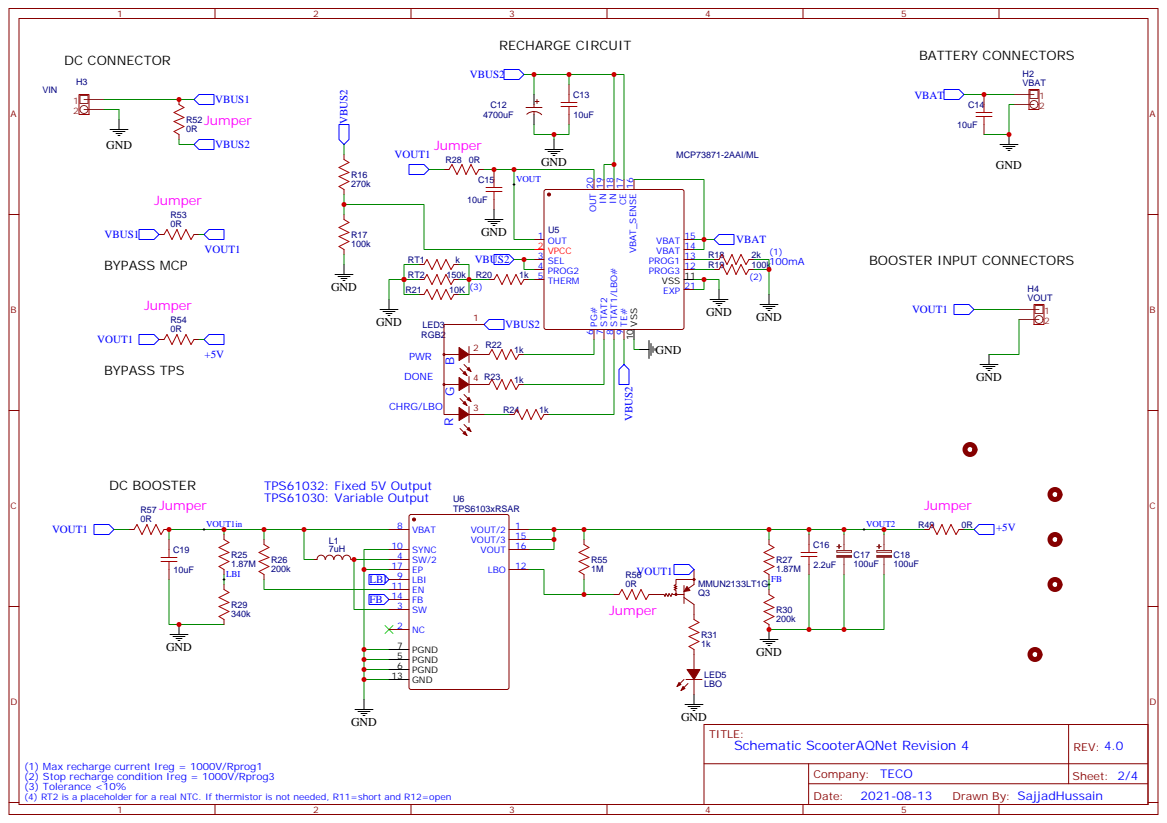
[picture p163: page 2]

(1) Max recharge current Ireg = 1000V/Rprog1
(2) Stop recharge condition Ireg = 1000V/Rprog3
(3) Tolerance <10%
(4) RT2 is a placeholder for a real NTC. If thermistor is not needed, R11=short and R12=open

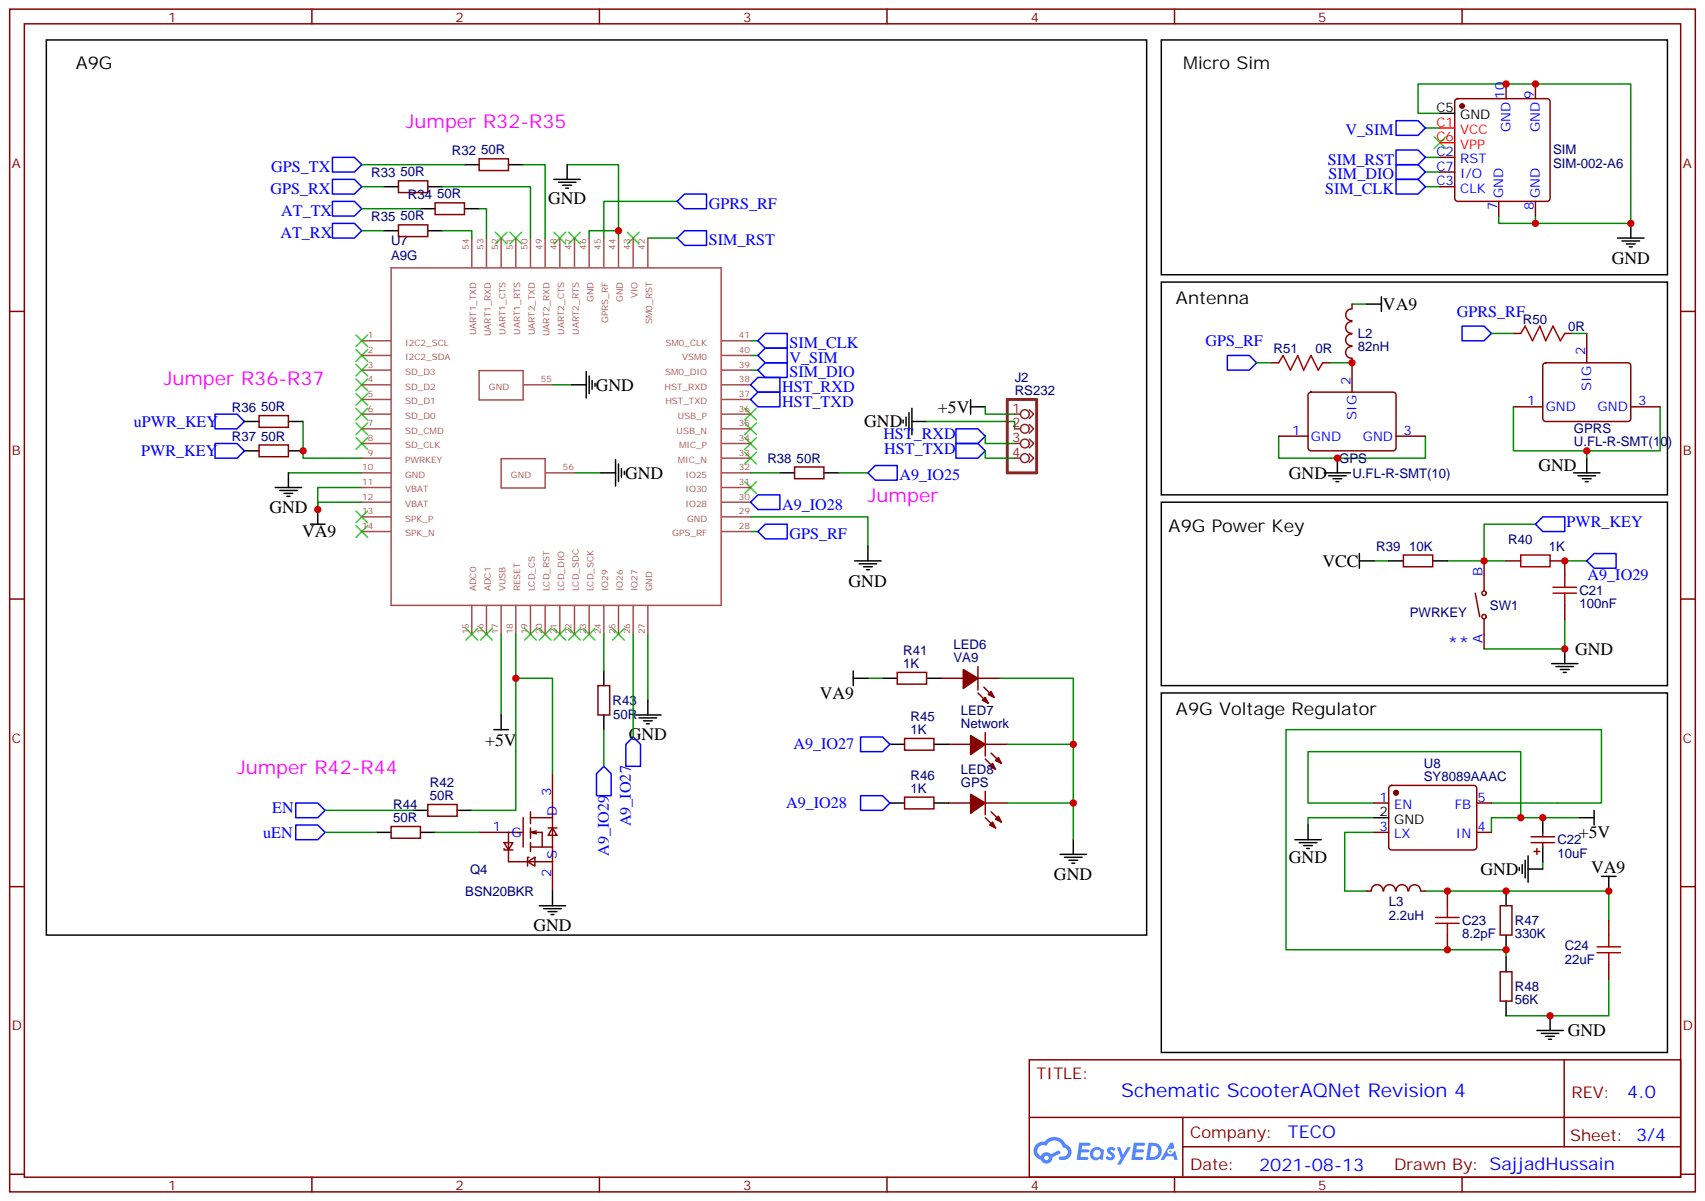
[picture p164: page 3]

## Jumpers/0-Ohm

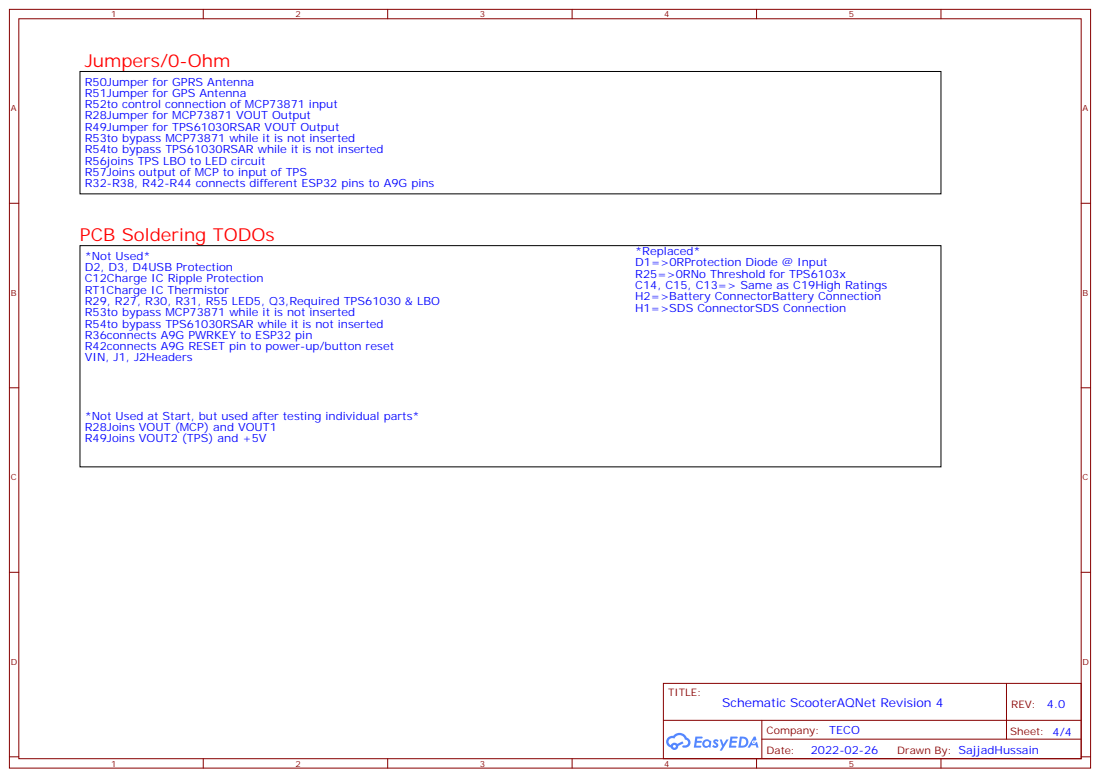
[picture p165: page 4]

R50Jumper for GPRS Antenna
R51Jumper for GPS Antenna
R52to control connection of MCP73871 input
R28Jumper for MCP73871 VOUT Output
R49Jumper for TPS61030RSAR VOUT Output
R53to bypass MCP73871 while it is not inserted
R54to bypass TPS61030RSAR while it is not inserted
R56joins TPS LBO to LED circuit
R57Joins output of MCP to input of TPS
R32-R38, R42-R44 connects different ESP32 pins to A9G pins

PCB Soldering TODOs
*Not Used*
D2, D3, D4USB Protection
C12Charge IC Ripple Protection
RT1Charge IC Thermistor
R29, R27, R30, R31, R55 LED5, Q3,Required TPS61030 & LBO
R36connects A9G PWRKEY to ESP32 pin
R42connects A9G RESET pin to power-up/button reset
VIN, J1, J2Headers

*Not Used at Start, but used after testing individual parts*
R28Joins VOUT (MCP) and VOUT1
R49Joins VOUT2 (TPS) and +5V
