enggsajjad/scooter/pcb/PCB1/Schematic_escooter_sajjad - rev3_2021-03-13.pdf

# IO12 14 GND 15

IO0 25 IO4 26 IO16 27 IO17 28 IO5 29 IO18 30 IO19 31 NC 32 IO21 33 RXD0 34 TXD0 35 IO22 36 IO23 37 GND 38

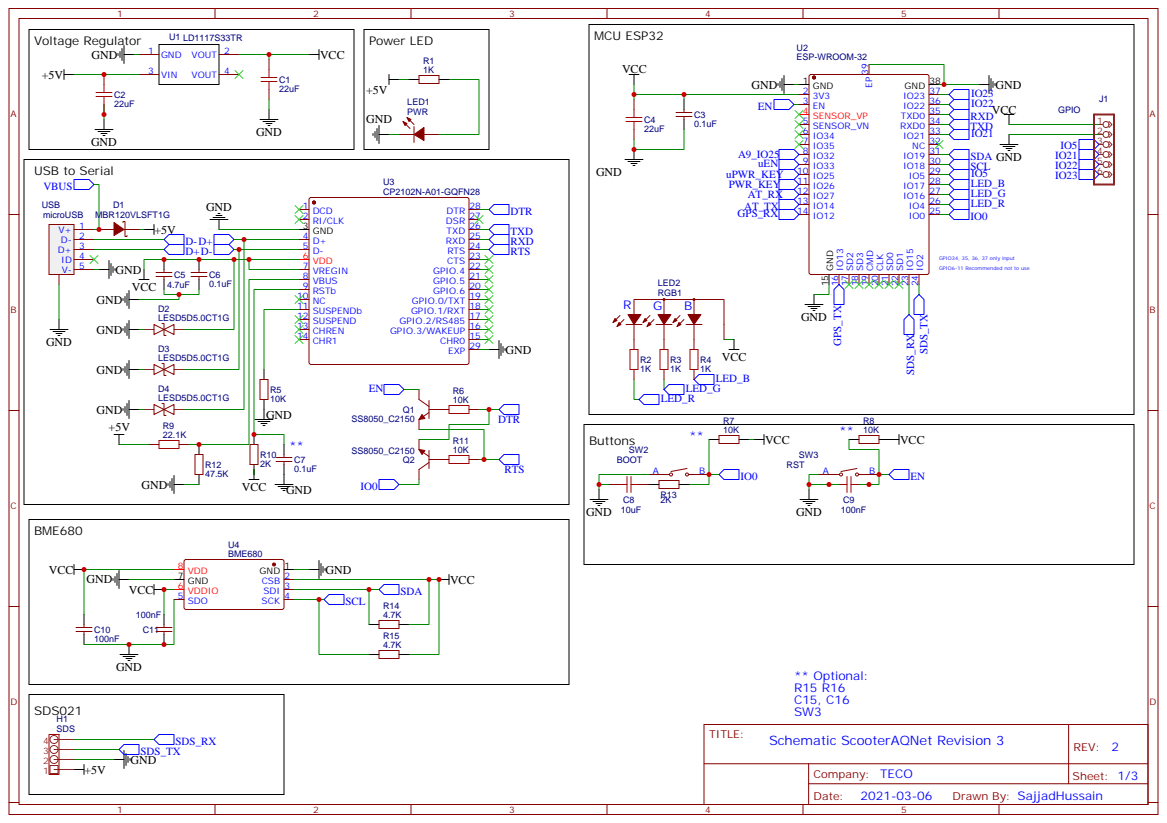
[picture p166: page 1]

GPIO34, 35, 36, 37 only input
GPIO6-11 Recommended not to use

## DC CONNECTOR

## BATTERY CONNECTORS

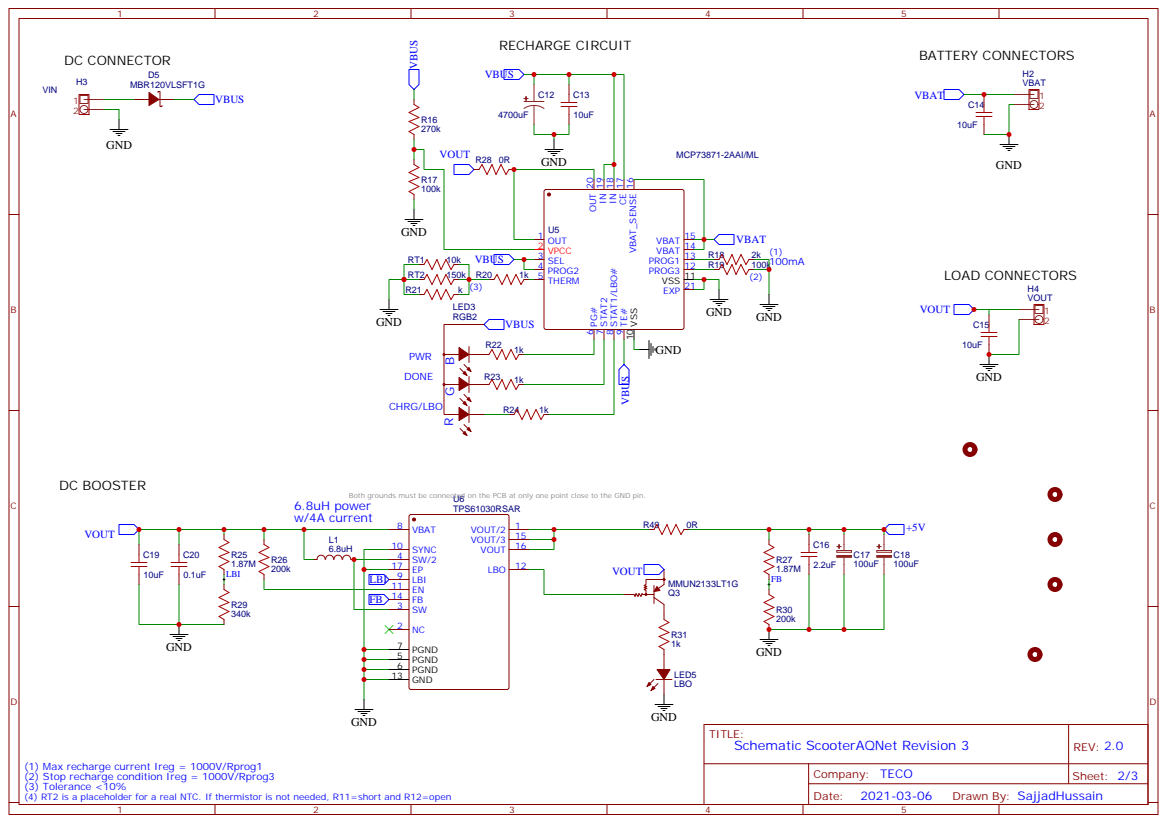
[picture p167: page 2]

Both grounds must be connected on the PCB at only one point close to the GND pin.

(1) Max recharge current Ireg = 1000V/Rprog1
(2) Stop recharge condition Ireg = 1000V/Rprog3
(3) Tolerance <10%
(4) RT2 is a placeholder for a real NTC. If thermistor is not needed, R11=short and R12=open

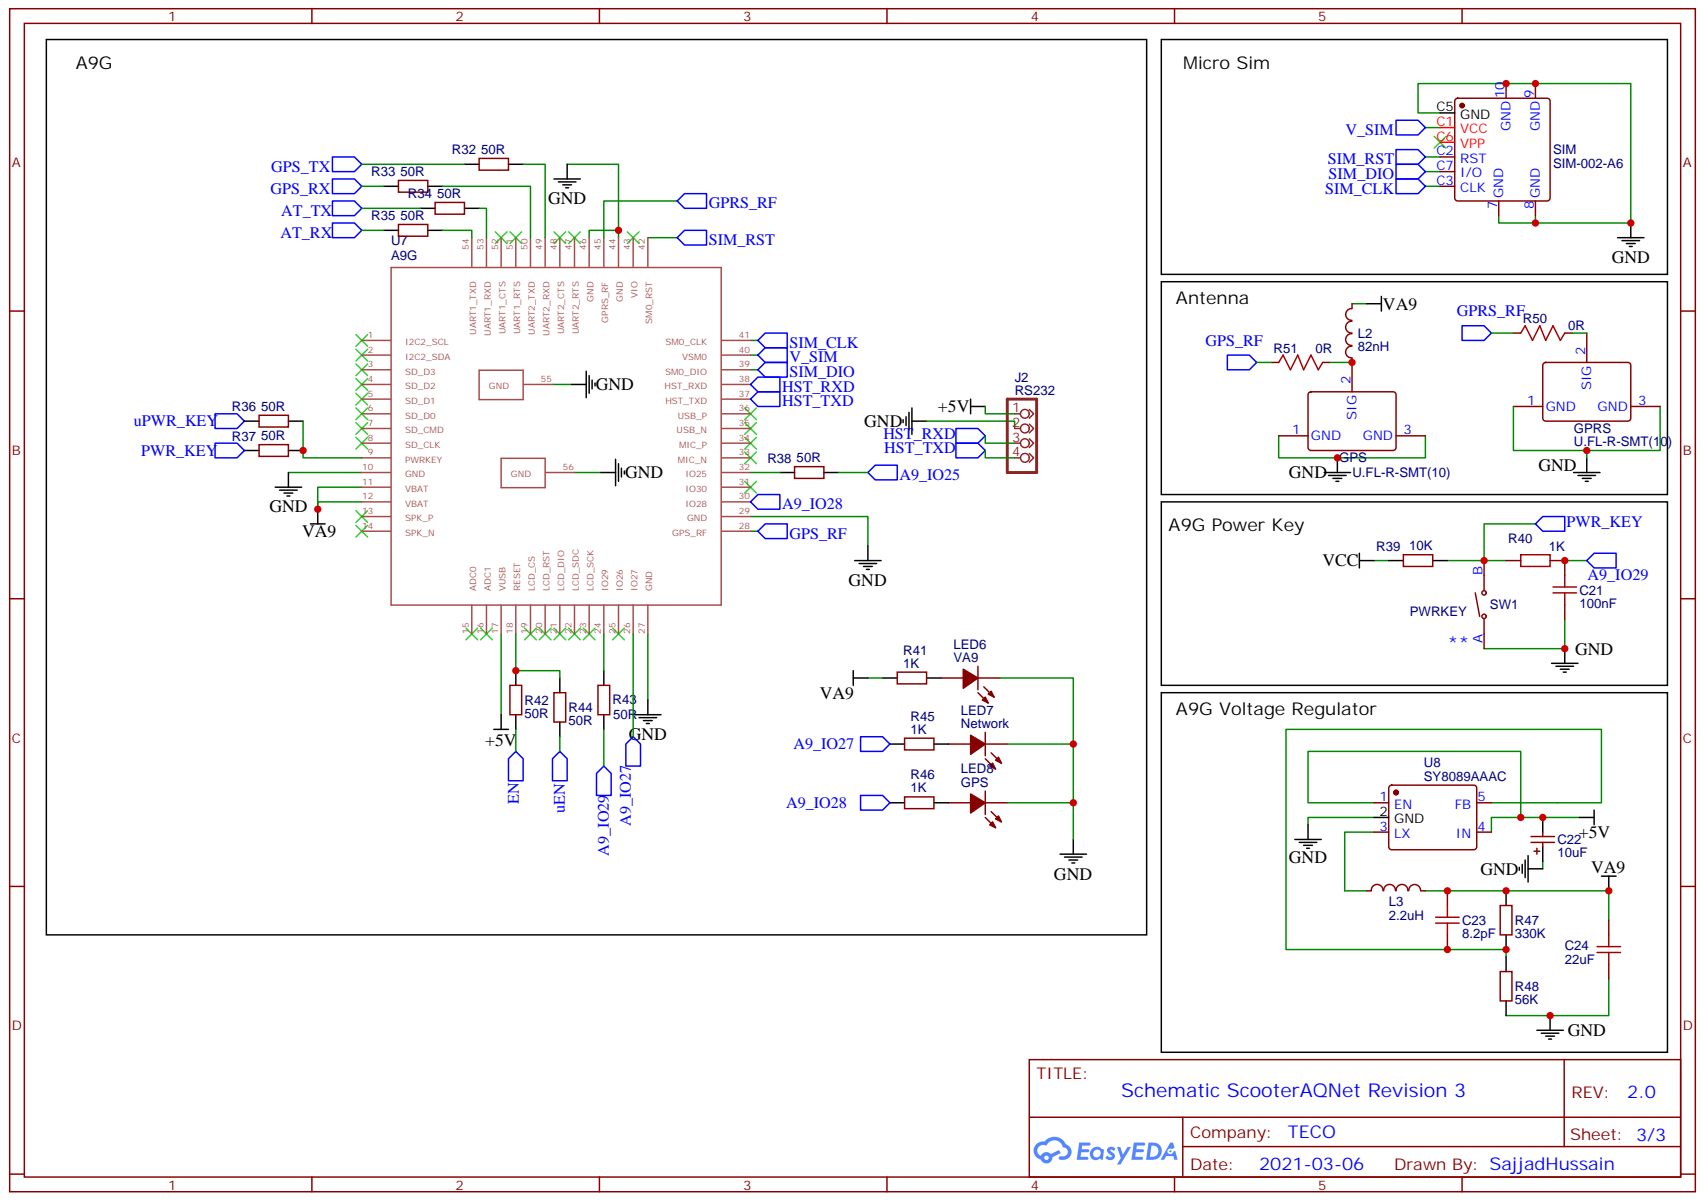
[picture p168: page 3]
