enggsajjad/scooter/esp32scooter/docs/Flowcharts/CreateEntitiesFlow.pdf

## February 19, 2020

# Create Entities Flow

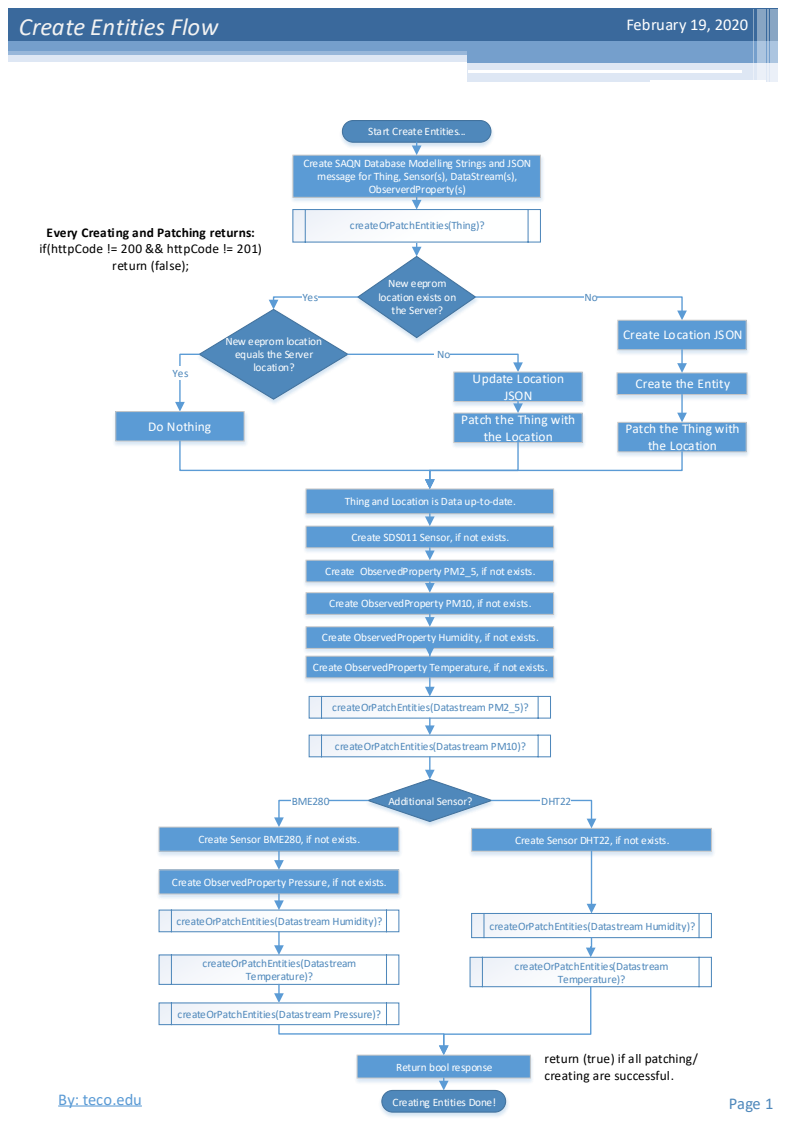
[picture p169: page 1]
ObserverdProperty(s); Yes; Additional Sensor?; BME280; DHT22; createOrPatchEntities(Thing)?; Do Nothing; Update Location JSON; createOrPatchEntities(Datastream PM2_5)?; createOrPatchEntities(Datastream PM10)?; createOrPatchEntities(Datastream Temperature)?; return (false);; Return bool response; return (true) if all patching/

Start Create Entities...

Create SAQN Database Modelling Strings and JSON
message for Thing, Sensor(s), DataStream(s),

Every Creating and Patching returns:
if(httpCode != 200 && httpCode != 201)

New eeprom
location exists on
the Server?

Create Location JSON

New eeprom location
equals the Server
location?

Create the Entity

Patch the Thing with
the Location

Thing and Location is Data up-to-date.

Create SDS011 Sensor, if not exists.

Create ObservedProperty PM2_5, if not exists.

Create ObservedProperty PM10, if not exists.

Create ObservedProperty Humidity, if not exists.

Create ObservedProperty Temperature, if not exists.

Create Sensor BME280, if not exists.

Create Sensor DHT22, if not exists.

Create ObservedProperty Pressure, if not exists.

createOrPatchEntities(Datastream Humidity)?

createOrPatchEntities(Datastream Pressure)?

creating are successful.

By: teco.edu

Creating Entities Done!

## February 19, 2020

# Create Entities Flow

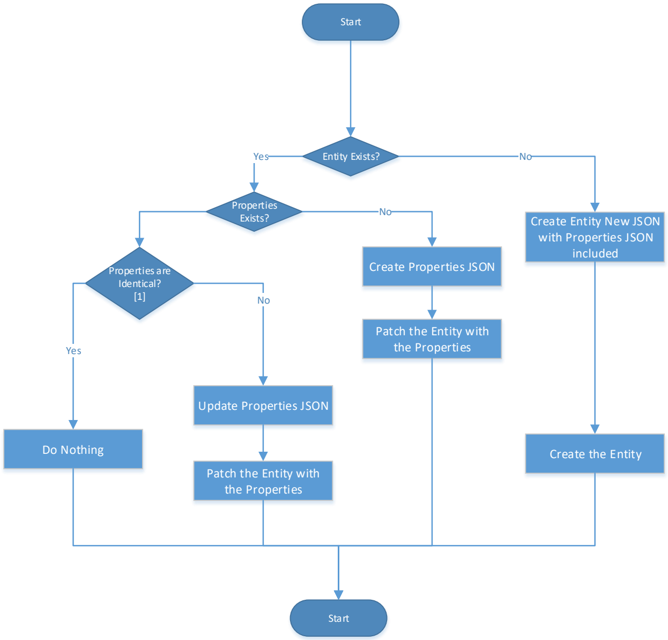
[picture p170: figure]
Entity Exists?; Properties are Identical? [1]; Yes; Do Nothing; Create Entity New JSON with Properties JSON included; Start; Create the Entity; Properties Exists?; Create Properties JSON; Patch the Entity with the Properties; Update Properties JSON

## By: teco.edu

# createOrPatchEntities() Sub-Process

### boolean createOrPatchEntities(String entity , String json, String iotId)

[1]. Finding Identical Properties and Patching them.

### 1. Sort the Software timestamps in ascending order

### 2. Get the Software Version at the recent timestamp

### 3. If this not identical with current firmware version, patch

software.version with new timestamp and version.
