enggsajjad/scooter/esp32scooter/docs/Flowcharts/modelling.pdf

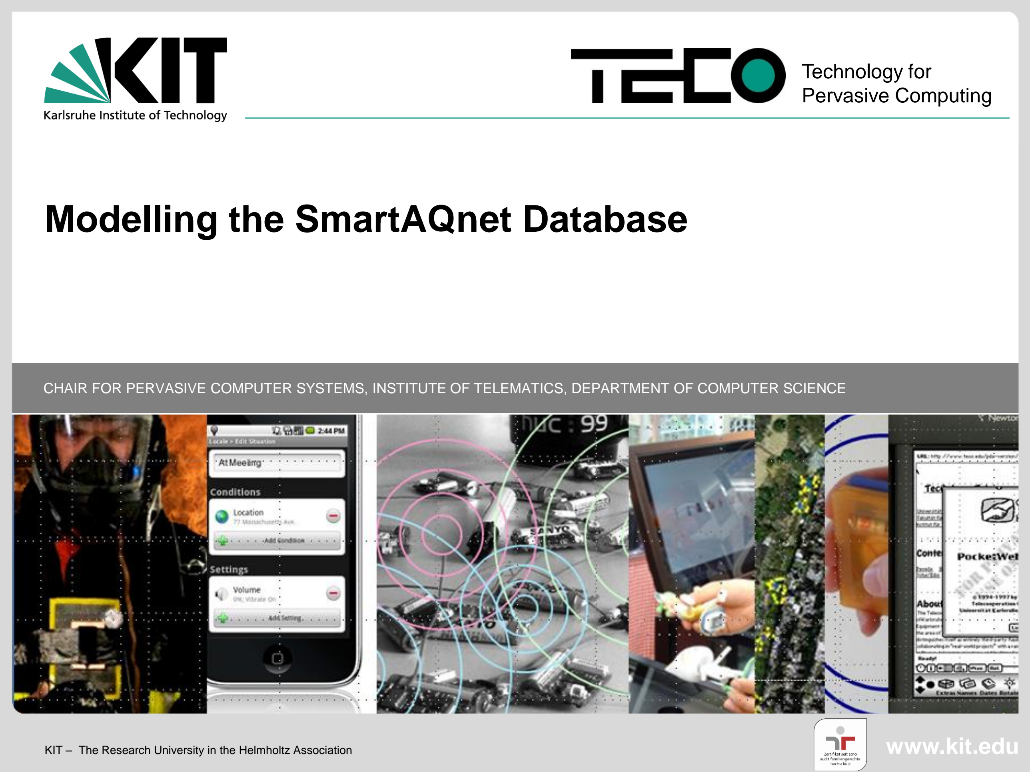
[picture p171: page 1]

KIT – The Research University in the Helmholtz Association

CHAIR FOR PERVASIVE COMPUTER SYSTEMS, INSTITUTE OF TELEMATICS, DEPARTMENT OF COMPUTER SCIENCE

www.kit.edu

Technology for
Pervasive Computing

## Modelling the SmartAQnet Database

## SAQN Database Modelling

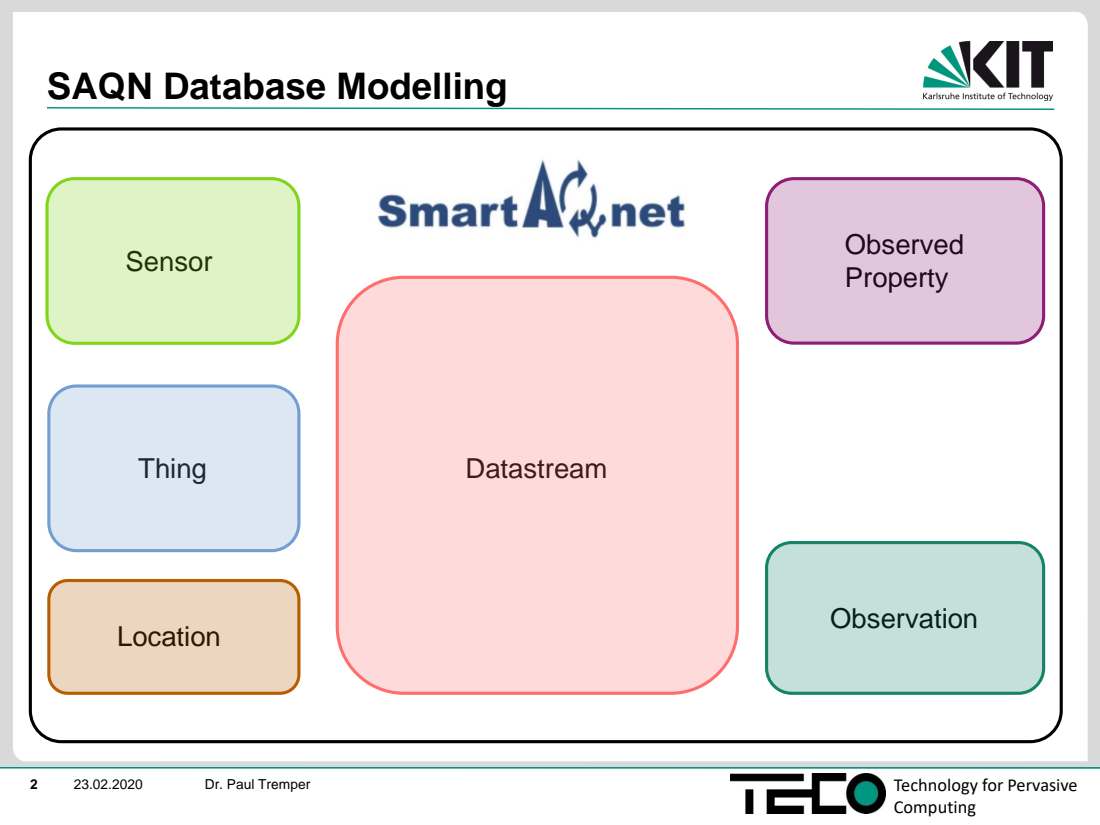
[picture p172: page 2]
Thing; Location; Observed Property; Observation; Datastream; Sensor

Dr. Paul Tremper

Technology for Pervasive
Computing

## SAQN Database Modelling - Locations

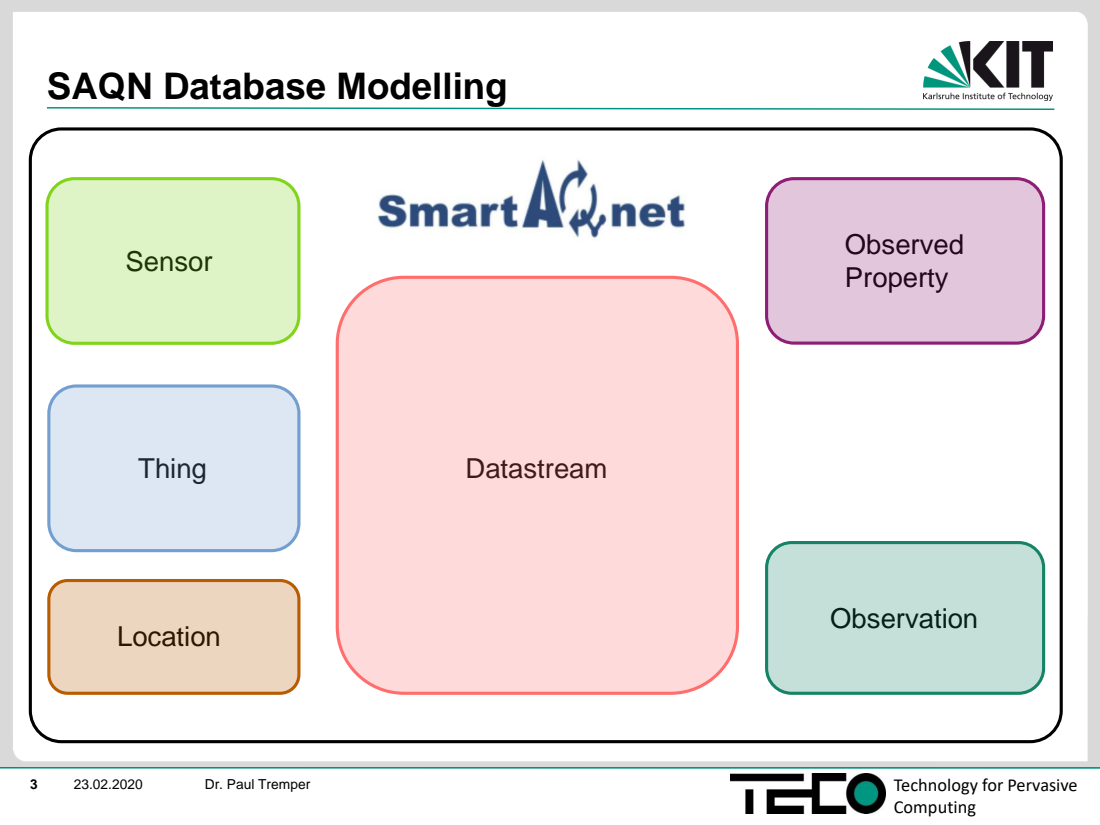
[picture p173: page 3]
Sensor; Thing; Location; Observed Property; Observation; Datastream

## SAQN Database Modelling: Locations

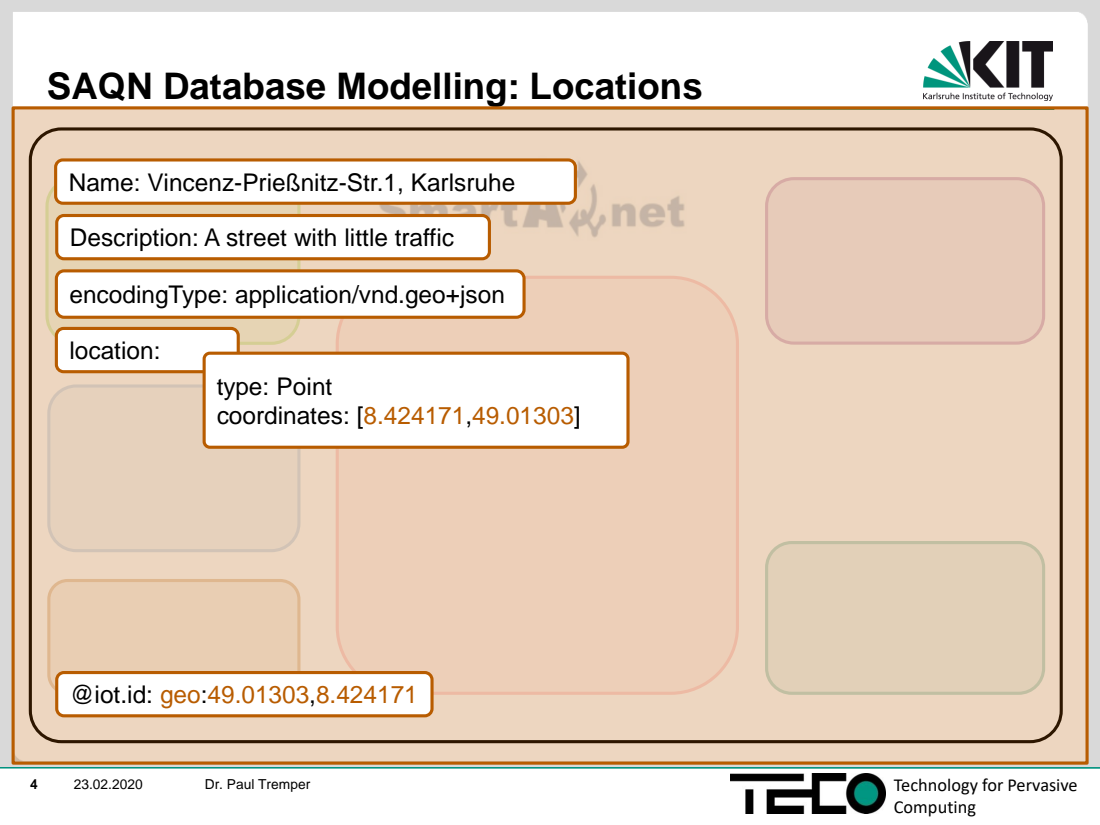
[picture p174: page 4]
location:; type: Point coordinates: [8.424171,49.01303]

Name: Vincenz-Prießnitz-Str.1, Karlsruhe

Description: A street with little traffic

encodingType: application/vnd.geo+json

@iot.id: geo:49.01303,8.424171

## SAQN Database Modelling

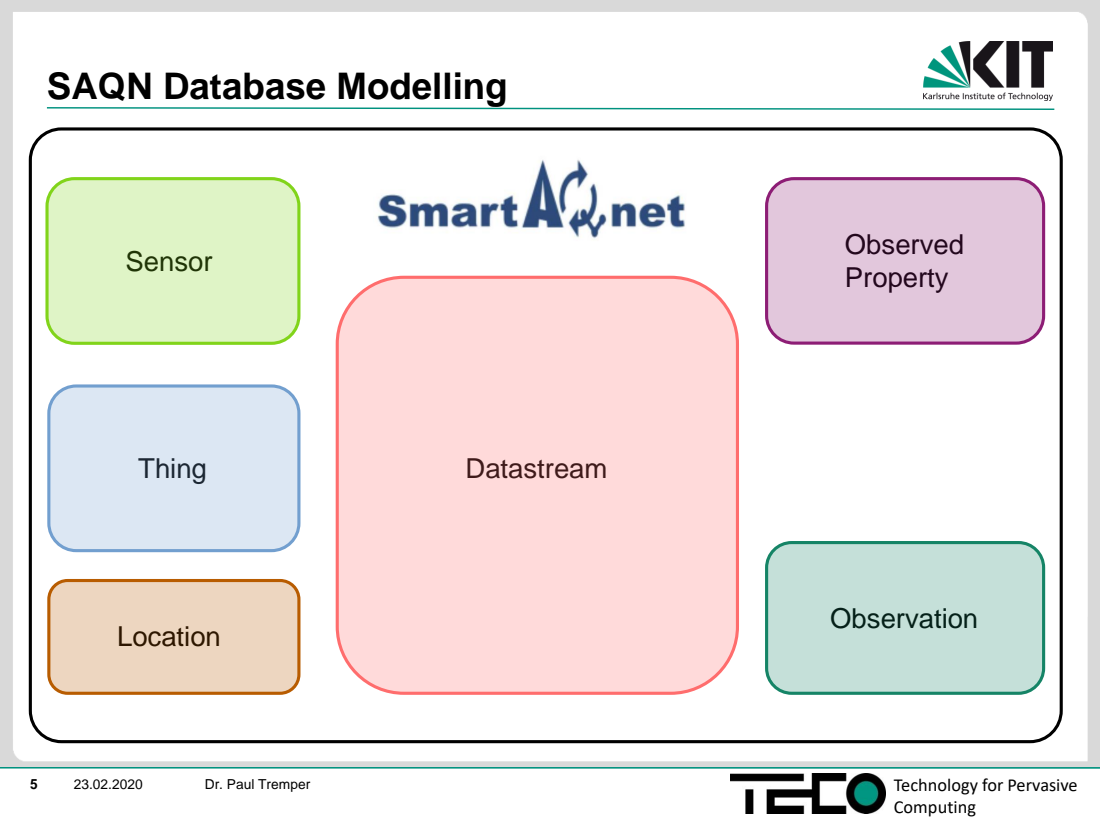
[picture p175: page 5]
Thing; Location; Observed Property; Observation; Datastream; Sensor

## SAQN Database Modelling - Things

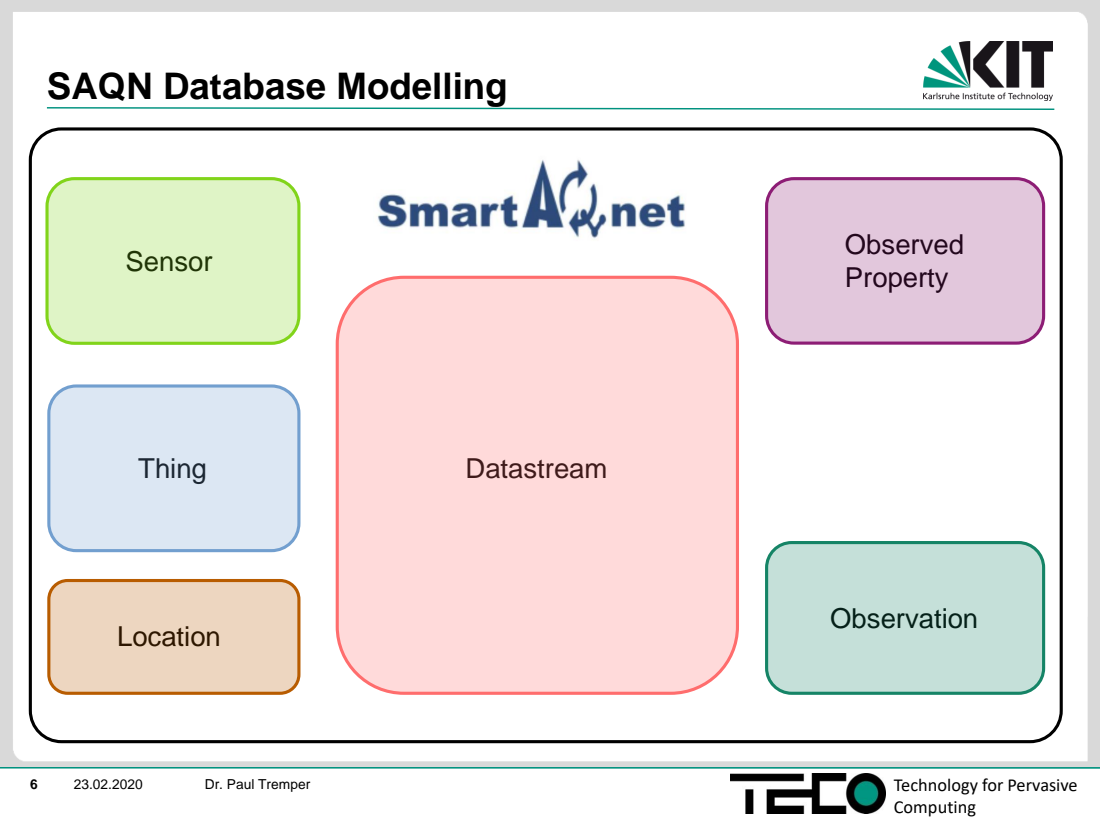
[picture p176: page 6]
Sensor; Thing; Location; Observed Property; Observation; Datastream

## SAQN Database Modelling: Things

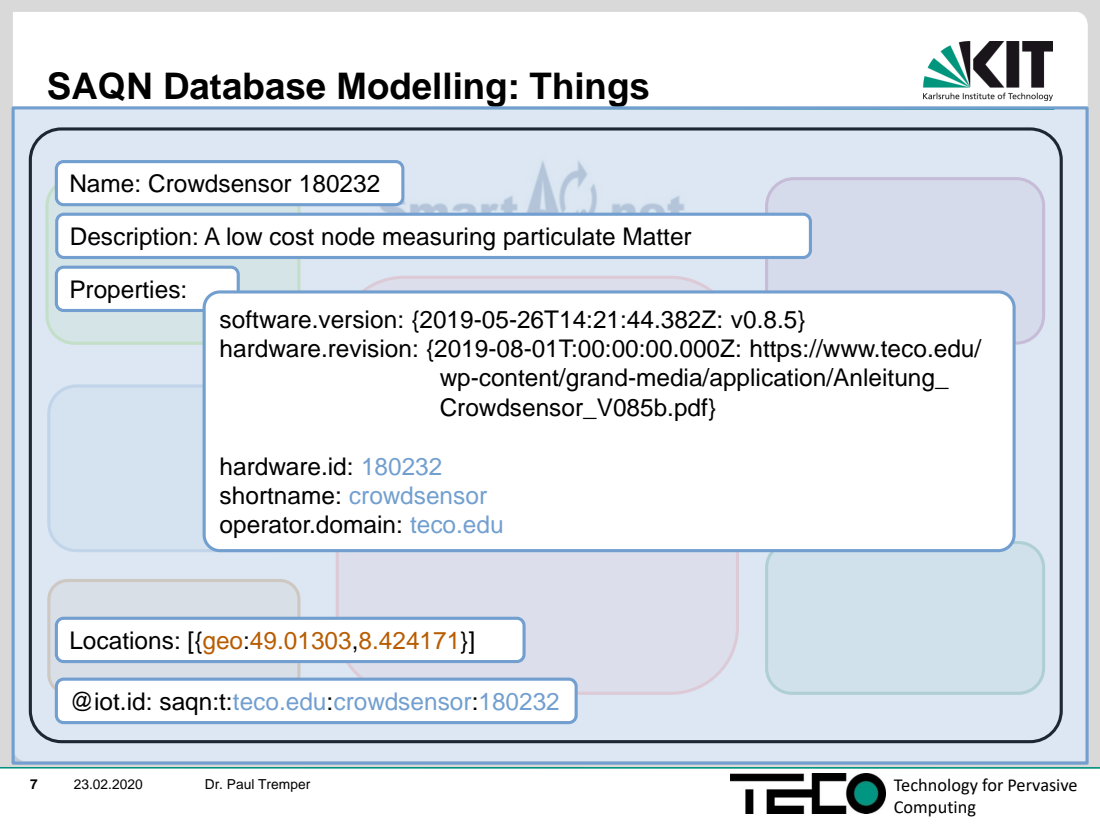
[picture p177: page 7]
Name: Crowdsensor 180232; Properties:; Locations: [{geo:49.01303,8.424171}]

Description: A low cost node measuring particulate Matter

software.version: {2019-05-26T14:21:44.382Z: v0.8.5}
hardware.revision: {2019-08-01T:00:00:00.000Z: https://www.teco.edu/

wp-content/grand-media/application/Anleitung_
Crowdsensor_V085b.pdf}

hardware.id: 180232
shortname: crowdsensor
operator.domain: teco.edu

@iot.id: saqn:t:teco.edu:crowdsensor:180232

## SAQN Database Modelling

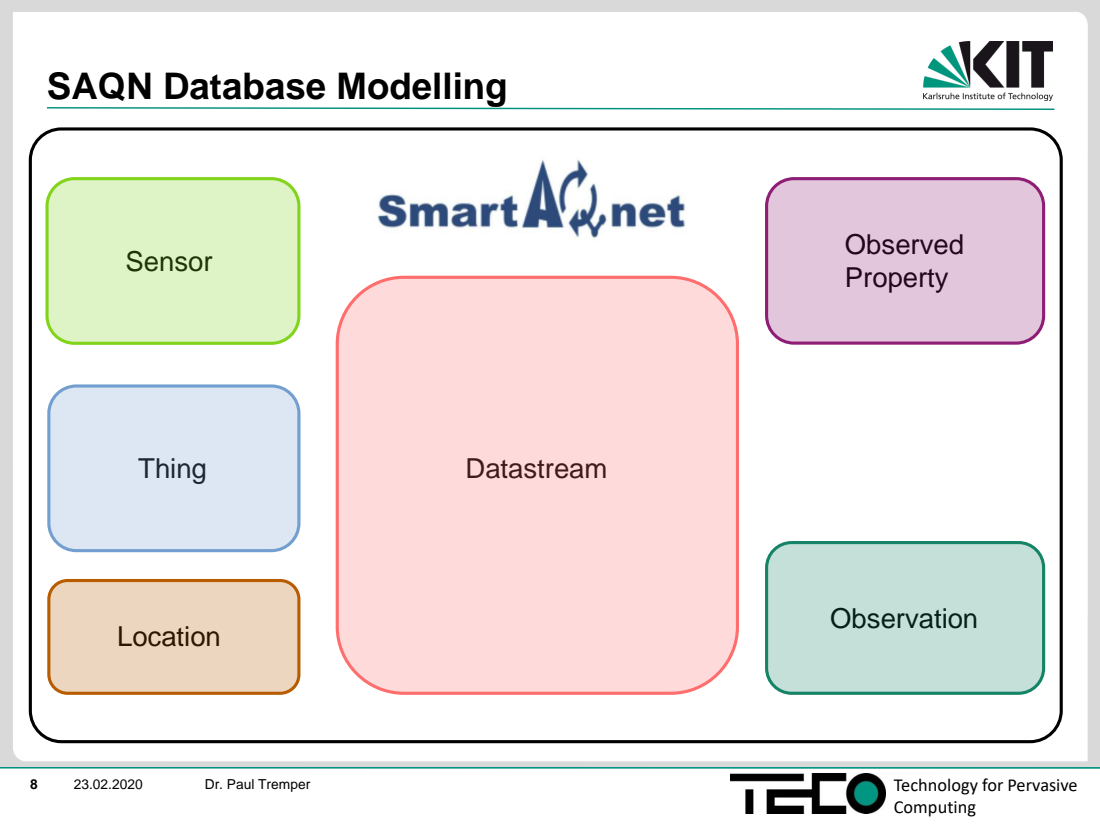
[picture p178: page 8]
Thing; Location; Observed Property; Observation; Datastream; Sensor

## SAQN Database Modelling - Sensors

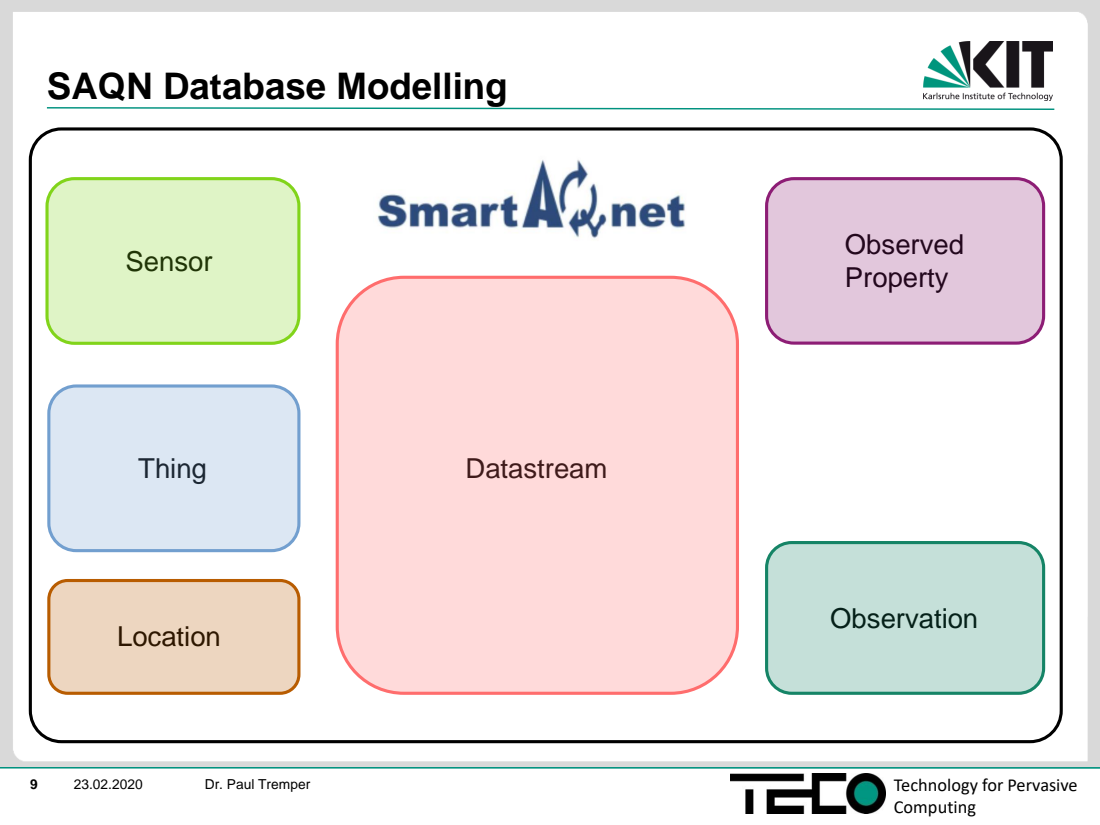
[picture p179: page 9]
Sensor; Thing; Location; Observed Property; Observation; Datastream

## SAQN Database Modelling: Sensors

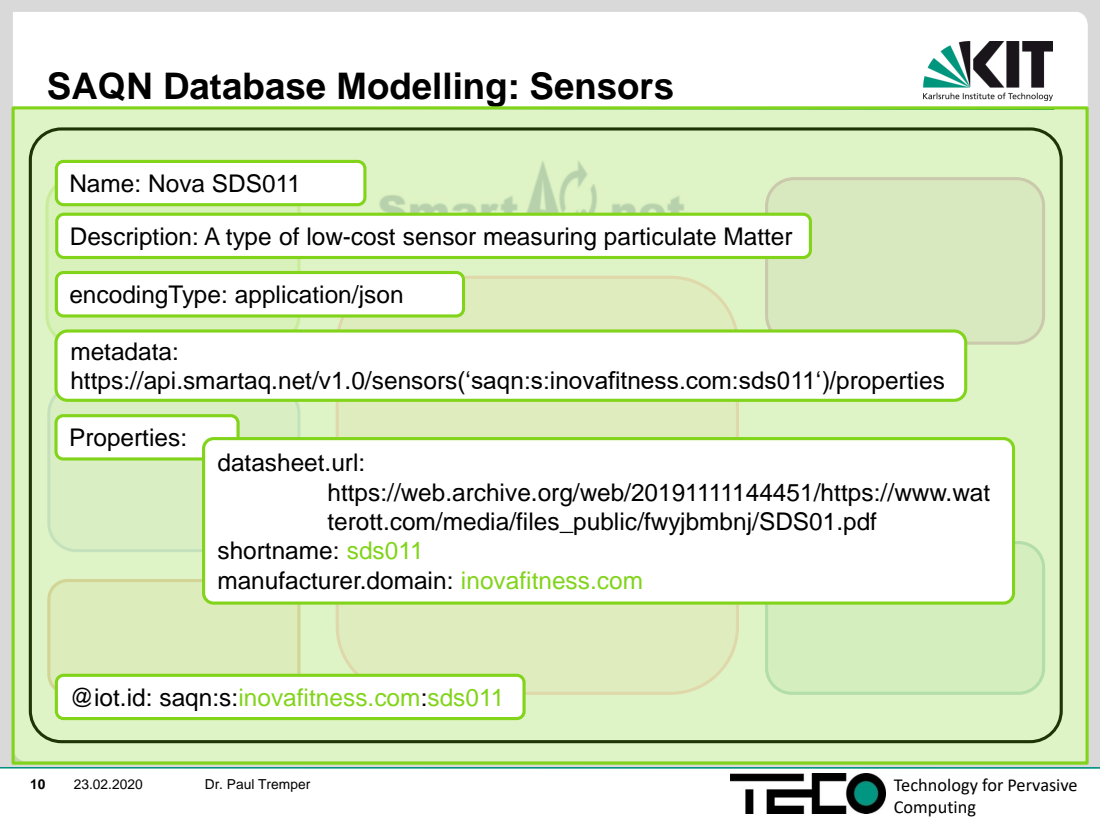
[picture p180: page 10]
Name: Nova SDS011; Properties:; datasheet.url:

Description: A type of low-cost sensor measuring particulate Matter

encodingType: application/json

metadata:
https://api.smartaq.net/v1.0/sensors(‘saqn:s:inovafitness.com:sds011‘)/properties

https://web.archive.org/web/20191111144451/https://www.wat
terott.com/media/files_public/fwyjbmbnj/SDS01.pdf

shortname: sds011
manufacturer.domain: inovafitness.com

@iot.id: saqn:s:inovafitness.com:sds011

## SAQN Database Modelling

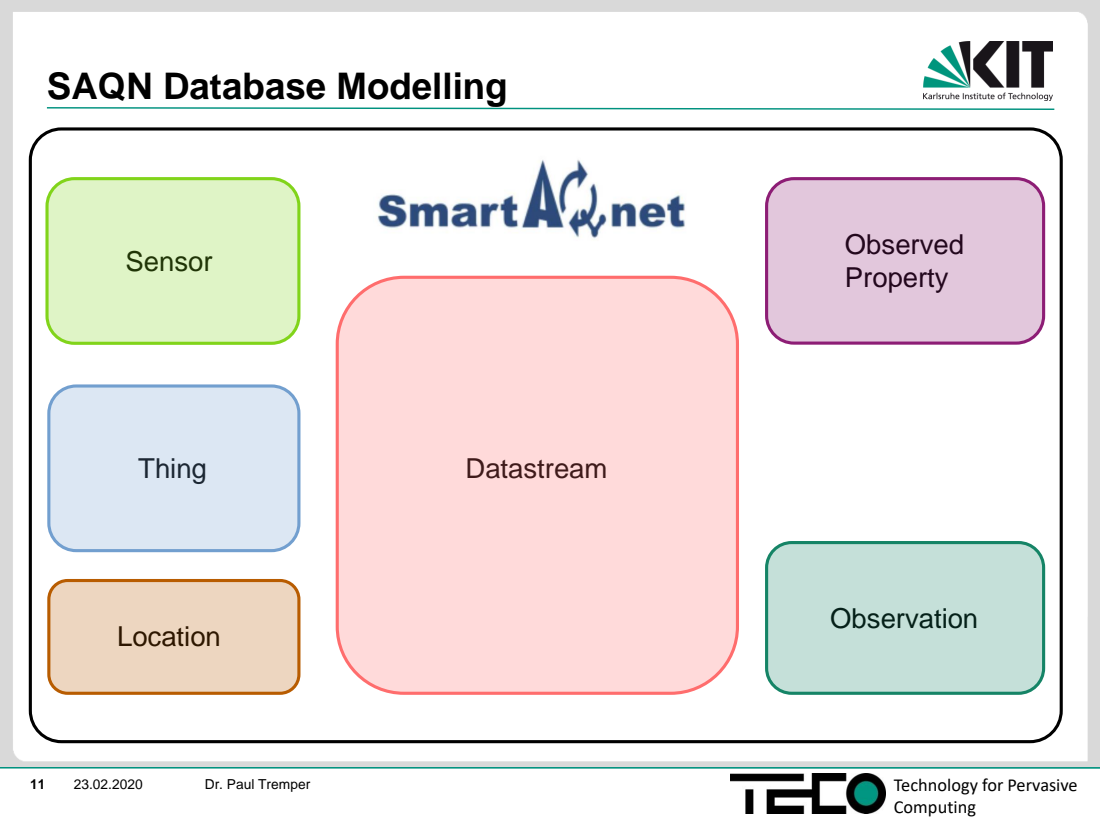
[picture p181: page 11]
Thing; Location; Observed Property; Observation; Datastream; Sensor

## SAQN Database Modelling - Op

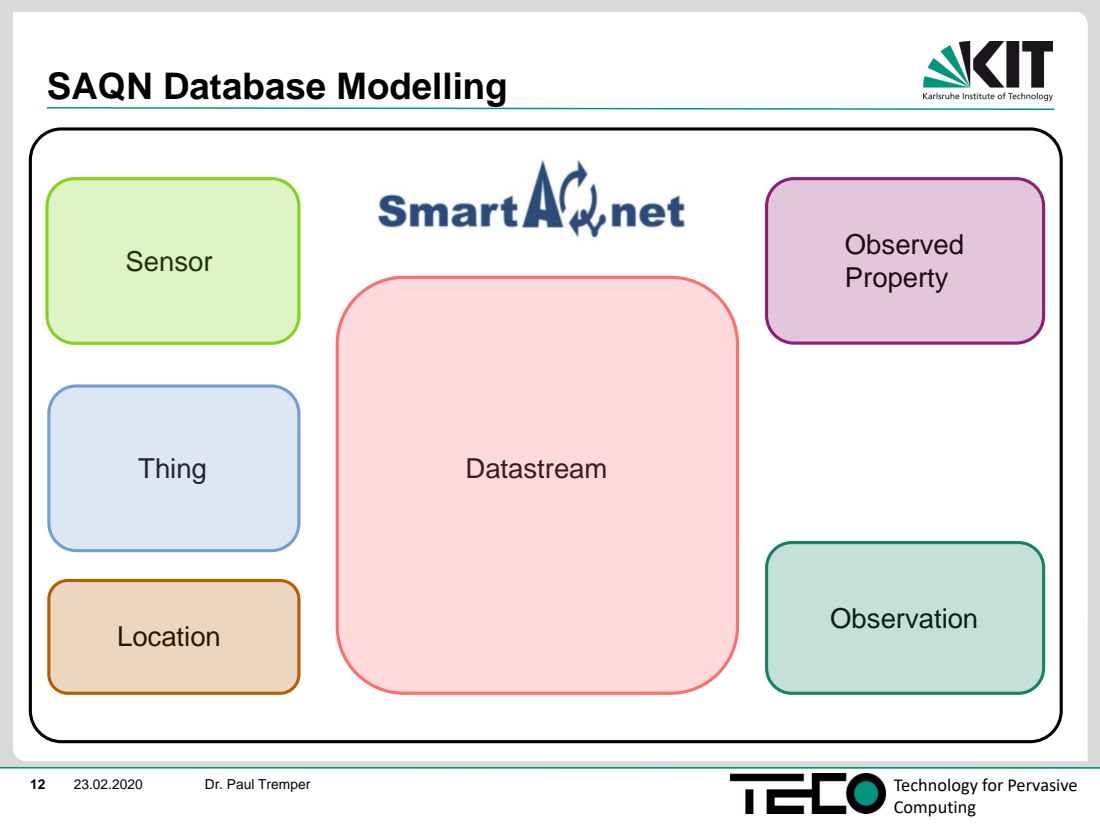
[picture p182: page 12]
Sensor; Thing; Location; Observed Property; Observation; Datastream

## SAQN Database Modelling: Observed Properties

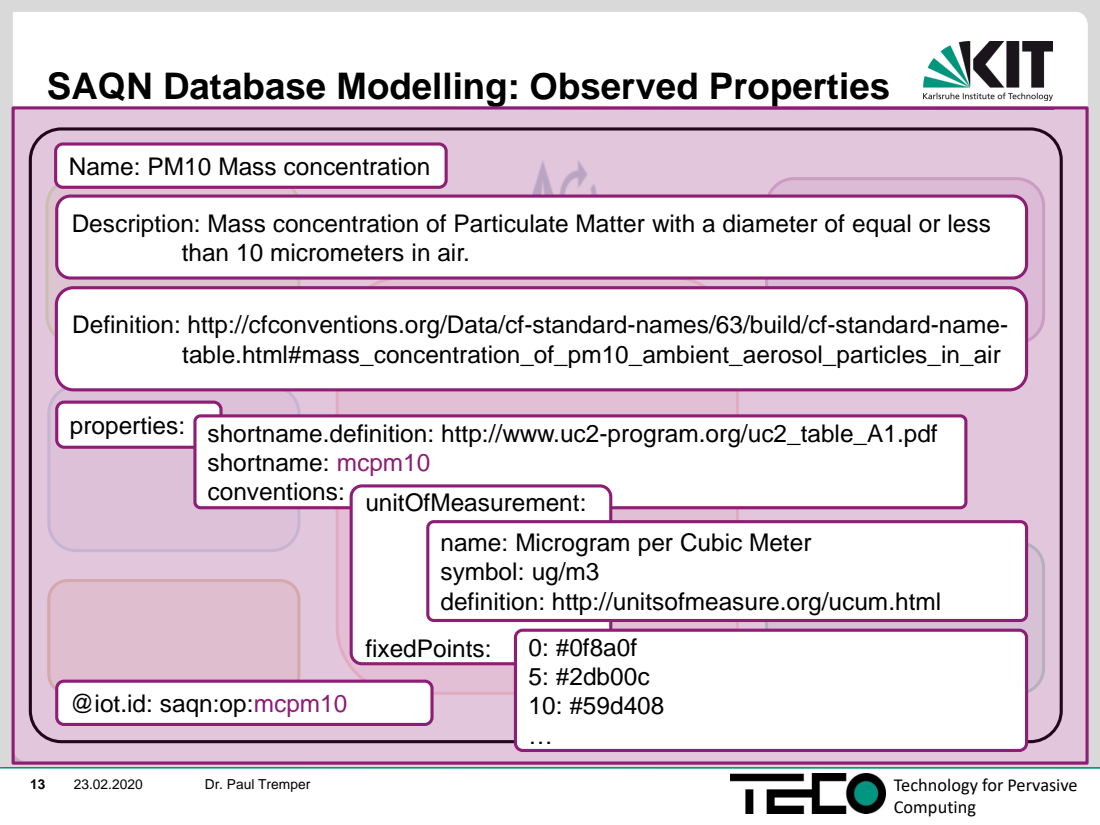
[picture p183: page 13]
table.html#mass_concentration_of_pm10_ambient_aerosol_particles_in_air; shortname: mcpm10 conventions: unitOfMeasurement:; fixedPoints:

Name: PM10 Mass concentration

Description: Mass concentration of Particulate Matter with a diameter of equal or less

than 10 micrometers in air.

Definition: http://cfconventions.org/Data/cf-standard-names/63/build/cf-standard-name-

properties: shortname.definition: http://www.uc2-program.org/uc2_table_A1.pdf

name: Microgram per Cubic Meter
symbol: ug/m3
definition: http://unitsofmeasure.org/ucum.html

@iot.id: saqn:op:mcpm10

## SAQN Database Modelling

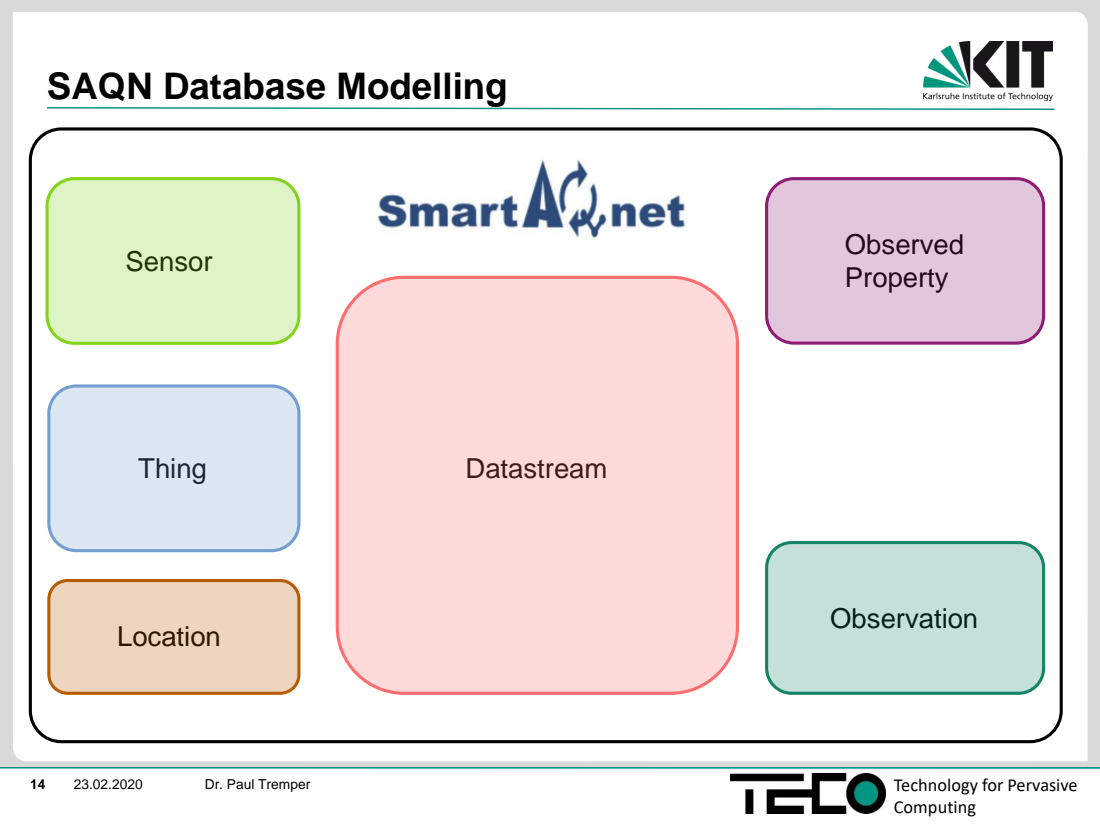
[picture p184: page 14]
Thing; Location; Observed Property; Observation; Datastream; Sensor

## SAQN Database Modelling - Datastreams

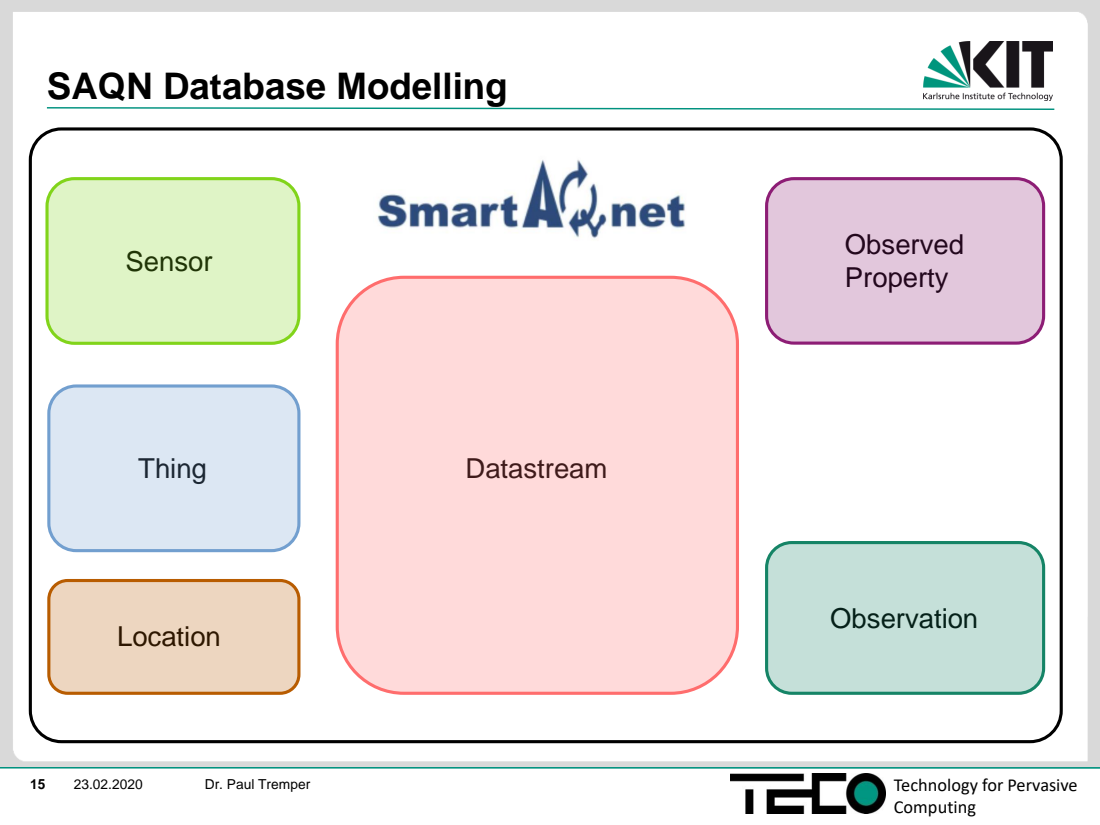
[picture p185: page 15]
Sensor; Thing; Location; Observed Property; Observation; Datastream

## SAQN Database Modelling: Datastreams

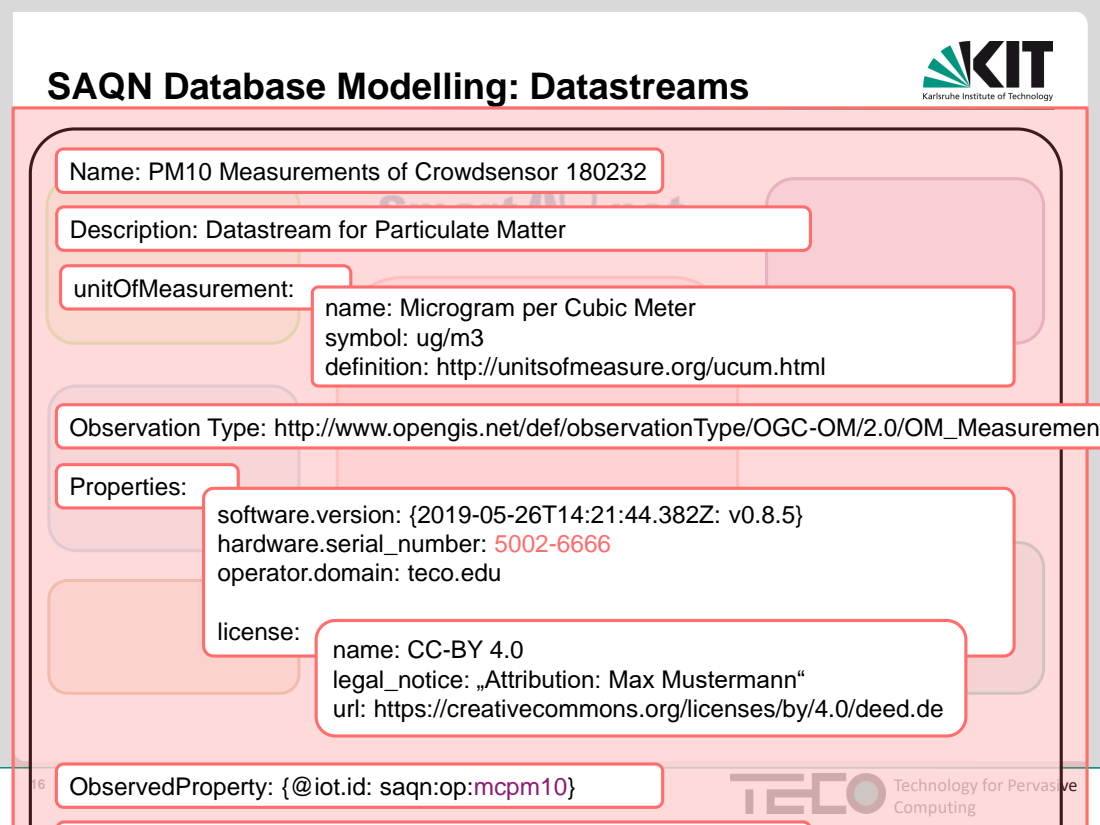
[picture p186: page 16]
unitOfMeasurement:; Properties:; license:

Name: PM10 Measurements of Crowdsensor 180232

Description: Datastream for Particulate Matter

name: Microgram per Cubic Meter
symbol: ug/m3
definition: http://unitsofmeasure.org/ucum.html

Observation Type: http://www.opengis.net/def/observationType/OGC-OM/2.0/OM_Measurement

software.version: {2019-05-26T14:21:44.382Z: v0.8.5}
hardware.serial_number: 5002-6666
operator.domain: teco.edu

name: CC-BY 4.0
legal_notice: „Attribution: Max Mustermann“
url: https://creativecommons.org/licenses/by/4.0/deed.de

ObservedProperty: {@iot.id: saqn:op:mcpm10}

## SAQN Database Modelling

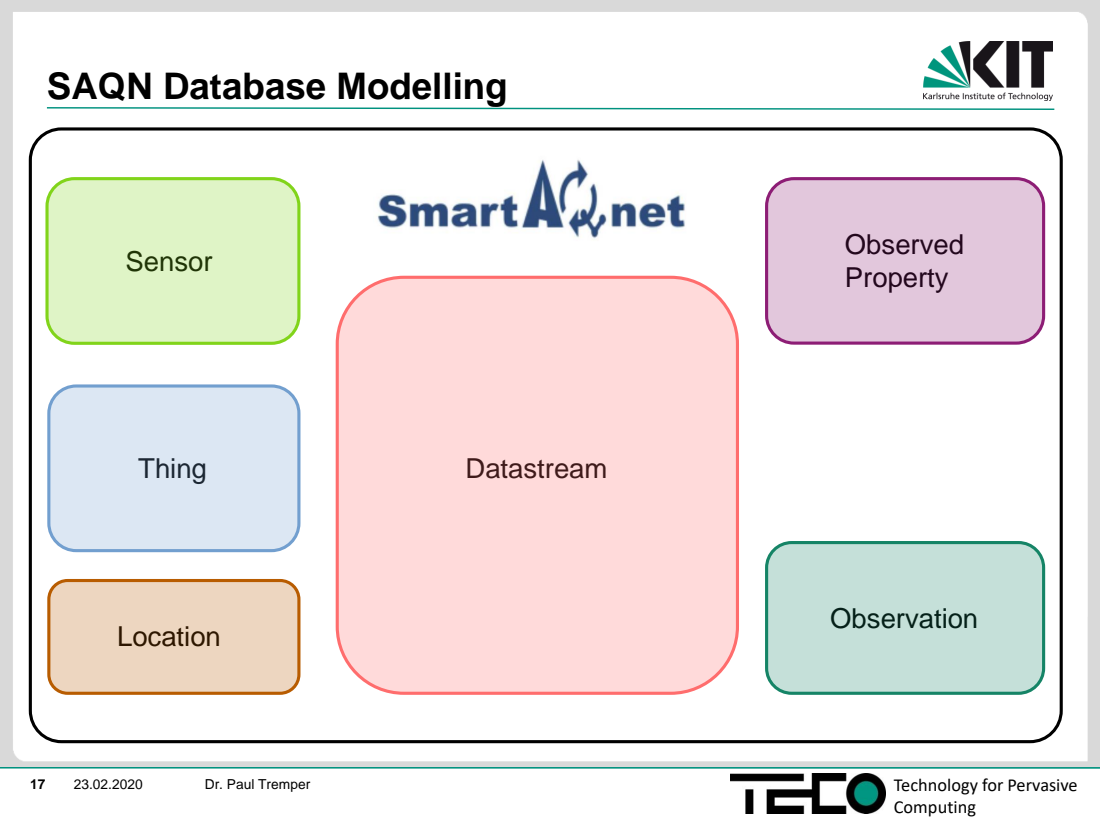
[picture p187: page 17]
Thing; Location; Observed Property; Observation; Datastream; Sensor

## SAQN Database Modelling - Observation

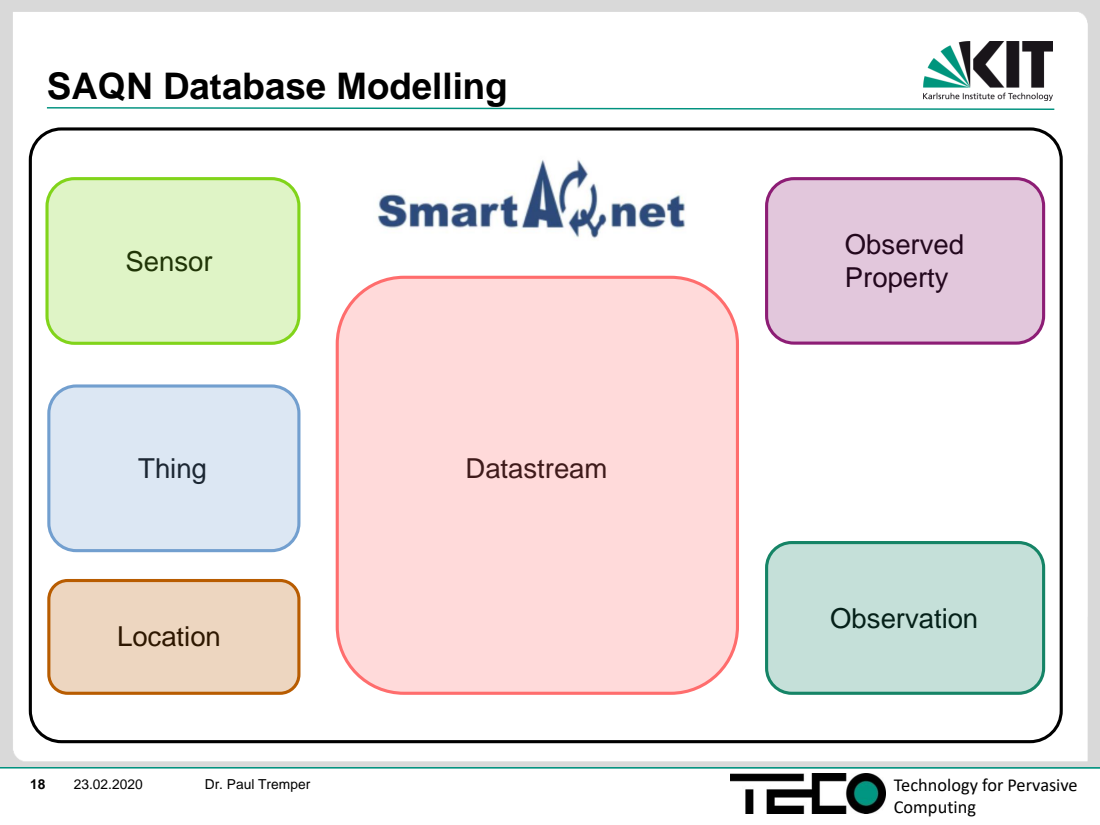
[picture p188: page 18]
Sensor; Thing; Location; Observed Property; Observation; Datastream

## SAQN Database Modelling: Observations

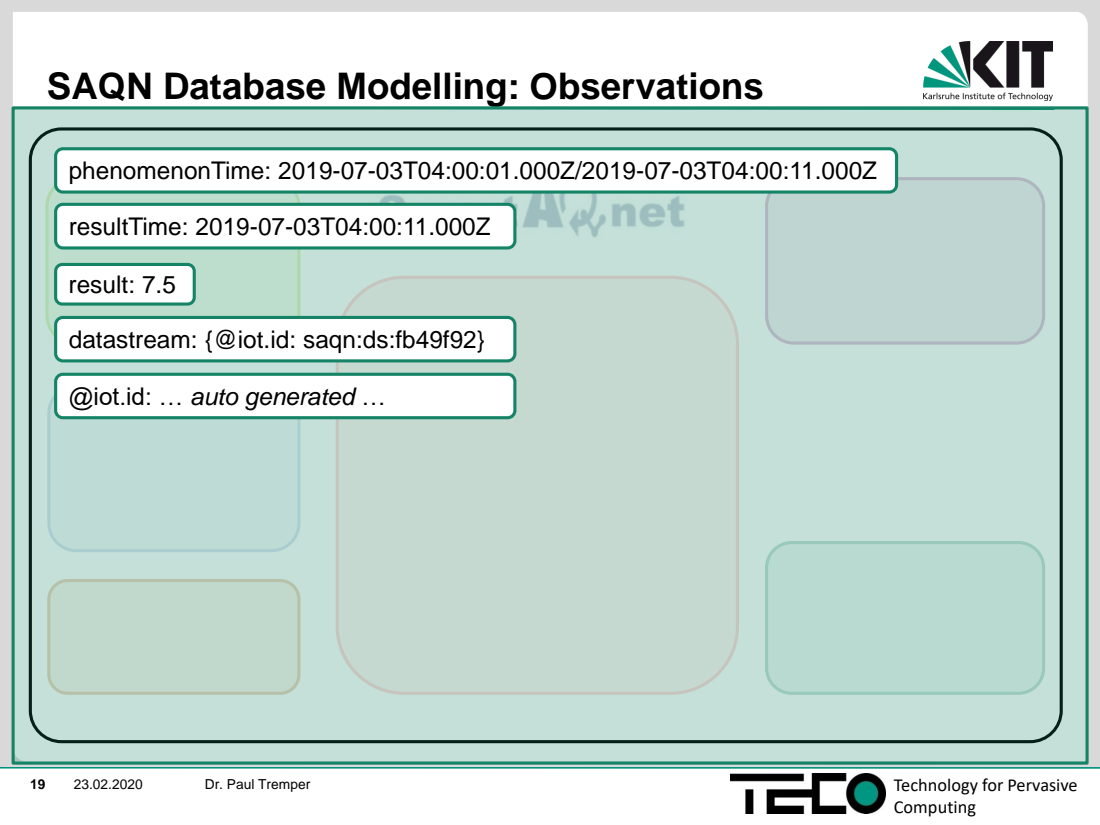
[picture p189: page 19]
phenomenonTime: 2019-07-03T04:00:01.000Z/2019-07-03T04:00:11.000Z; resultTime: 2019-07-03T04:00:11.000Z; result: 7.5

datastream: {@iot.id: saqn:ds:fb49f92}

@iot.id: … auto generated …

## SAQN Database Modelling

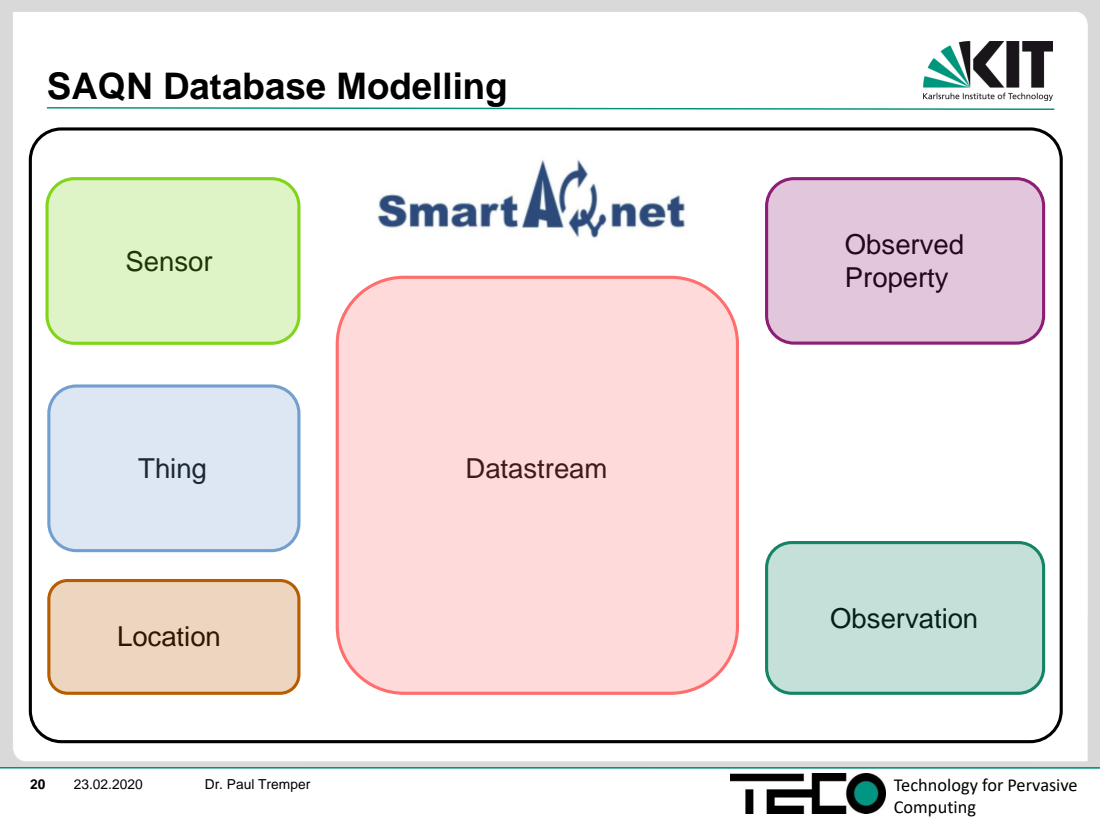
[picture p190: page 20]
Thing; Location; Observed Property; Observation; Datastream; Sensor

21 23.02.2020

### Vielen Dank für die Aufmerksamkeit

22 23.02.2020

## Zur Vollständigkeit

Im Vortrag ausgelassen:

- Feature of Interest ( = „Location der Messung“):
Ein Feature of Interest wird (falls nicht manuell erzeugt) für jede Observation automatisch angelegt zum Zeitpunkt der Messung, indem die aktuelle Location des Things kopiert wird.
- Historical Locations ( = „Log der Locations des Things“):
Jedes Thing hat eine Liste von Historical Locations mit dem Zeitstempel, wann das Thing an dieser Location war. Diese Liste wird automatisch erzeugt, indem jedes Mal wenn die Location eines Things geändert wird, die neue Location in die Liste der Historical Locations kopiert wird (zusammen mit dem aktuellen Zeitstempel).

Dokumentation der SenorThings API mit Beispielen http://developers.sensorup.com/docs/#sensorthingsAPISensing
