enggsajjad/scooter/pcb/PCB1/PCB_PCB_PNR_R11_2021-03-13.pdf

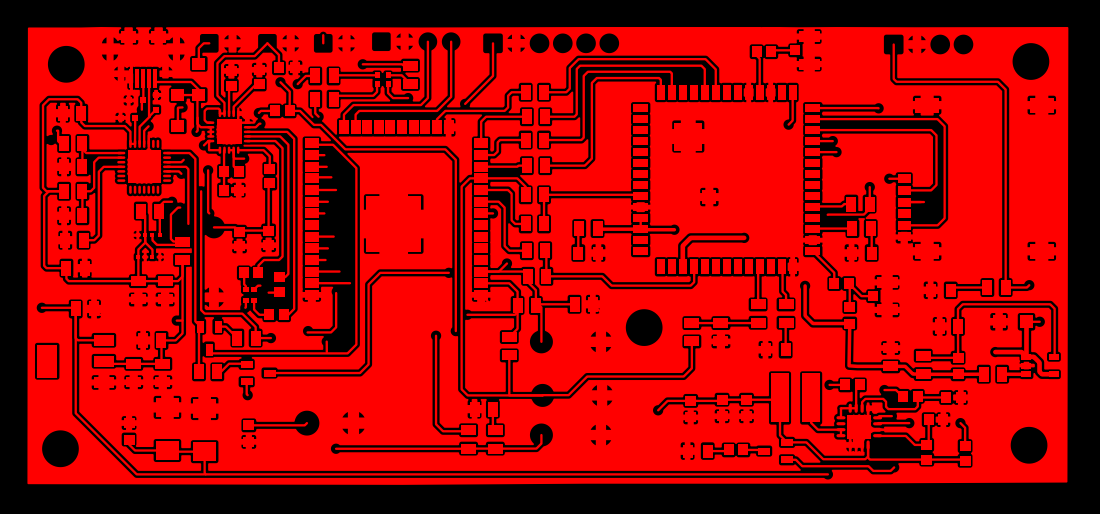
[picture p191: page 1]

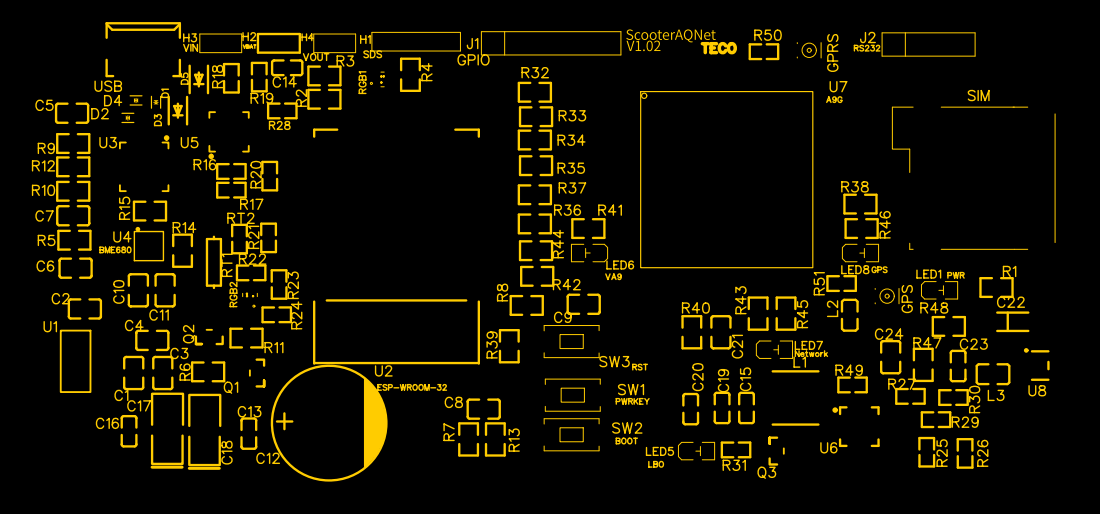
[picture p192: page 2]

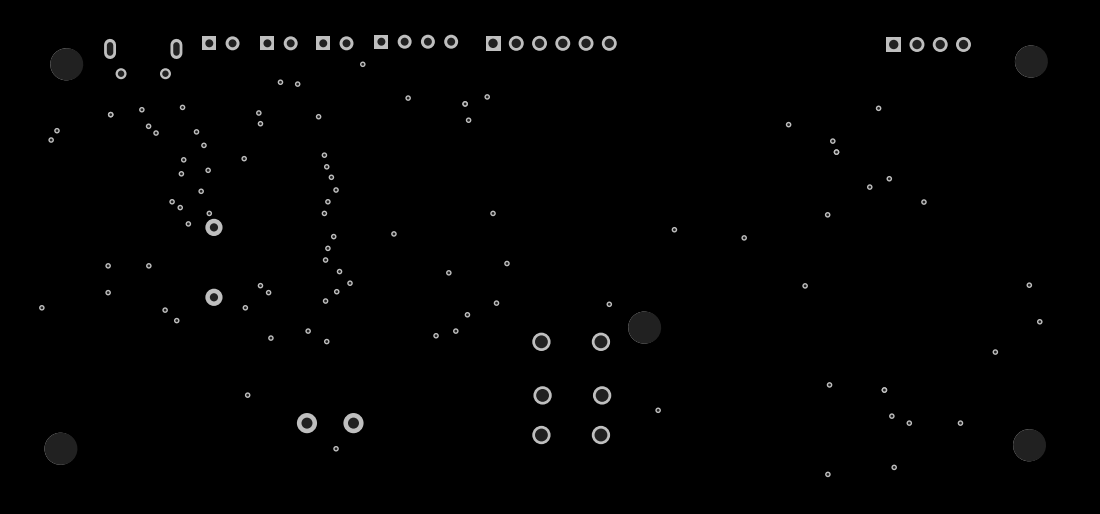
[picture p193: page 4]
