enggsajjad/scooter/(commit log)

2020-09-04 testing bme680 using i2c
2020-09-04 testing hardware uarts independantly for a7
2020-09-04 adding different sensors into the state machine code
2020-09-04 re-arranging the scooter code into esp32scooter
2020-09-07 refining the startup commands and other flow, las working code
2020-09-11 handling of continuous TCP data sending and adjusted a suitable delays and flow, fetch data from sensors and send to TCP in packets of 10, and then it tests GPS-TX and again GPS data using AT Command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
2021-03-01 added manufactured pcb files
2021-12-07 adding recent code and tests for PCB0,1,2,3,4
    [BOM All.xlsx, BOM_PCB_PNR_R11_2021-03-12.csv, BOM_escooter_sajjad - rev4_2021-05-23.csv, Basket_Mar13_1251PM.xls, LCSC_Exported_20210524_083139.xlsx, PCBV1 Basket20.10.2020 020312.xls, PCBV3_Basket532021 125923.xls, Project_Mar13_1246PM_shortlisted.xls]
2021-12-09 fixing errors, leds, IP Processing, increase timeout, initializations
    [esp32scooterR3.ino, main.h, sensor.h, testA9GLoopCustomPortR2.ino, thinker.h]
2021-12-13 improvements, debugging, reset, and power key caliberations, revision 4
    [esp32scooterR4.ino, main.h, sensor.h, testA9GLoopCustomPortR2.ino, thinker.h, timer.h]
2021-12-13 improvements, debugging, reset, and power key caliberations, revision 5
    [esp32scooter.ino, esp32scooterR5.ino]
2021-12-13 improvements, debugging, reset, and power key caliberations, revision 6
2021-12-13 improvements, debugging, reset, and power key caliberations, revision 7
    [esp32scooterR7.ino, main.h, thinker.h]
2021-12-13 improvements, debugging, reset, and power key caliberations, revision 8
    [esp32scooterR8.ino, main.h, thinker.h, timer.h]
2021-12-14 Testing whether data is missing for longer runs, 1. Started 21:15 End 22:17 Total Sent Values 186 about 20sec delay(5000); x 2 AT+GPSRD=5, 2. Started 22:58 End 23:48 but missing delay(5000); to delay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
    [esp32scooterR9.ino, main.h]
2021-12-14 new code flow and cleaning, revision 10
2021-12-15 adjudtmeny in reset and init routine
    [esp32scooterR10.ino, main.h]
2021-12-20 adding further logs, and code fixes
    [20211208 2115 Test1 Thingspeak feed.csv, 20211209 1400 Test2 Thingspeak feed.csv, 20211209 1540 Test3 Thingspeak feed.csv, 20211209 2232 Test5&6 Thingspeak feed.csv, 20211213221805 Test with longer runs to see if there is any missing values at thingspeak.csv, 20211213235022 Started 2258 End 2348 but missing.csv, 20211214001420 test long runs, but gives error of IP PROCESSING, but nothing missed.c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]
2021-12-23 fixing some error, timeouts, adding more states as secondary, added logs
    [20211221164817 CIPSTATUS timeout PCB3 test in the room without covers feeds.csv, 20211221225840 CIPSTATUS timeout PCB3 test in the room without covers feeds.csv, 20211222084114 PCB3 test in the room without covers 2021-12-22T004457+0100 start 2021-12-22T074800+0100 end 7h4m=25,440s1255=20s feeds.csv, 20211222224319 AT+CIPSEND timeout error, increased, add set_cipstart2 feeds.csv]
2021-12-25 added diiferent logs, adding THINGSPEAK and REAL_SENSOR and some backup states
    [20211223123946 long run in room 2021-12-23T001147+0100 start 2021-12-23T091611+0100 end 32700s1615=20s NO ERRORS feeds.csv, 20211224155028 long test with test values PCB2 open in the room start 2021-12-24T154956+0100 end 2021-12-24T004259+0100 15hr7min 54420s2721=20s NO ERRORS feeds.csv, 20211224155300 long test with test values PCB3 stopped while walking to TECO 47 values only feeds.csv, 2021122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]
2021-12-29 added diiferent logs, removed limits on error and reset to the initial state i.e. loop in case of AT commands errors
    [202112271751 start 1751 Out 1753 Train 1803 Walking 1827 - 1833 Room 1850 stopped when train entered in the tunnel feeds.csv, 20211229212632 Walking, stopped send data feeds.csv]
2021-12-30 added reset_module and waiting_ready states and if ((resetCntr % 10) == 0) rxState = reset_module
    [esp32scooterR10.ino, main.h]
2021-12-31 added preferences library to debug errors and erronous state, added timesheet files and logs
    [20211230032952 testing for error states and reset counters, gprs antenna is unplugged to have an error feeds.csv, 20211230043446 testing for error states and reset counters, gprs antenna is unplugged to have an error feeds.csv, 20211230192733 Test with long run feeds.csv, 20211230202554 Walking again stopped after some time feeds.csv]
2022-01-14 added timesheet files and logs
    [20220101133327 Walking towards durlach and stopped in the middle, power off, feeds.csv, 20220111214127 blackbox inside room without covers feeds.csv, 20220111214203 whitebox inside room without covers feeds.csv, 20220112230817 in the room then walking black box feeds.csv, 20220113221410 cycle start 1735 to hadiko return 1911, walk 2011, return 2100, stopped many times feeds.csv]
2022-02-06 modifying reset using mosfet and hardware pinds, added logs
    [esp32scooterR10.ino, esp32scooterR9.ino, main.h, sensor.h, test18B20.ino, testA9GLoopCustomPortR3.ino]
2022-02-09 added test logs
    [20220206221621 testing in the room started 0213, end 2216, monitoring mosfet resets feeds.csv, 20220207170921 testing the room, laptop went hibernation,battery ended after 9hr 2022-02-07T093740 2022-02-07T002135 09hr16min, 1641readings feeds.csv, 20220207213808 Walk 2022-02-07T201214 2022-02-07T212318, Gap 205500 - 205848, 192 values initial logs feeds.csv, 20220208201444 Walking feeds.csv, 20220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]
2022-03-06 adding new PCB revision, added info sheet to PCB schematics, added logs
    [20220214 Walking with cover feeds.csv, 20220216 Walking dinner Walking feeds.csv, 20220217 in the room.csv, 20220218 walking.csv, 20220220 Walking from TECO to dinner to TECO to home map feeds.csv, 20220221 Walking feeds.csv, 20220222 Walking feeds.csv, 20220223 Walking feeds.csv]
2022-05-23 test EDIT 2ND
    [20220401 Charging in the room feeds.csv, 20220401 Walking feeds.csv, 20220416 Charging feeds.csv, 20220416 Tests Walking Maps feeds.csv, 20220503 First Tests with Pink Case feeds.csv, 20220507 Walk Test feeds.csv, 20220507 Walk Test from Teco feeds.csv, 20220508 Tests feeds.csv]
